JacobFV/labrat/hardware/electronics/power_budget.md

# 5 V servo rail: power budget

Generated by `gen_wiring.py` from its load table; edit the table there, not this file.

The servos run from their own 5 V supply into the PCA9685 breakout's V+ screw terminal. The ESP32 and the
PCA9685 logic (VCC, ~10 mA) run from USB 5 V through the DevKit's 3.3 V regulator. The two meet only at GND.

## Per-servo currents at 5 V (conservative, datasheet and bench numbers rounded up)

| ch | role | servo | idle (A) | moving (A) | stall (A) |
|---|---|---|---|---|---|
| 0 | syringe plunger drive | FS90R continuous | 0.01 | 0.20 | 0.80 |
| 1 | capacitive-probe arm | SG90 positional | 0.01 | 0.25 | 0.75 |
| 2 | phone stand pan | MG90S positional | 0.01 | 0.30 | 0.90 |
| 3 | phone stand tilt | MG90S positional | 0.01 | 0.30 | 0.90 |
| 4 | spare / second syringe | FS90R or SG90 | 0.01 | 0.25 | 0.80 |
| 5 | spare | SG90 | 0.01 | 0.25 | 0.75 |

## Scenarios (supply: 4 A)

| scenario | rail current (A) | margin |
|---|---|---|
| idle, everything holding | 0.03 | ok |
| typical step: plunger moving, stand aiming, probe arm swinging | 1.05 | ok |
| homing: plunger driven into its stop (until syr_home), stand aiming | 1.41 | ok |
| bad day: all four installed servos stalled | 3.35 | tight |
| worst case, six servos (two spares) stalled | 4.90 | exceeds supply: brief only |

## Choices

- **Supply: 5 V, 4 A** (20 W). Normal work stays near 1-1.5 A; four installed servos all
  stalled is still inside the rating. Six stalled servos exceed it, but only for the moment before the
  firmware's timed pulses or the stall clears. A 3 A brick works for the four installed servos alone.
  Cheapest alternative: an XL4015 5 A buck module running off the 3018's 24 V supply, set to 5.2 V.
- **Bulk capacitor: 1000 uF / 16 V electrolytic across V+ and GND at the PCA9685 terminal** (the breakout
  has a footprint for it). 9 g servos draw 0.5-0.9 A spikes at every start; without it the rail sags and
  servos twitch. Rule of thumb ~150-250 uF per servo, so 1000 uF covers 4-6.
- **Wiring:** supply to terminal with 20-22 AWG. Servo leads are 26-28 AWG; for the 1 m runs to the head,
  1 m of 26 AWG round trip at 0.8 A stall drops ~0.2 V, which is acceptable.
- **Common ground:** supply -, PCA9685 GND and ESP32 GND are one net (the breakout's header carries it).
  The laptop USB ground joins it through the ESP32. Never connect the servo supply + to the ESP32's 5V pin.
- **ESP32 power:** USB only (laptop, powered hub, phone OTG, or a USB charger when the phone drives it
  over BLE). Peak ~0.35 A with BLE active.
