JacobFV/labrat/tappet/hardware/electronics/netlist.csv

net | ref | pin
+3V3 | A1 | J1-1
+3V3 | A1 | J1-2
+3V3 | A2 | VCC
+3V3 | R11 | 1
+3V3 | R6 | 1
+3V3 | TP6 | 1
5V_DEVKIT | A1 | J1-21
5V_DEVKIT | D3 | K
5V_DEVKIT | TP5 | 1
5V_LOGIC | C6 | +
5V_LOGIC | C9 | 1
5V_LOGIC | D3 | A
5V_LOGIC | TP3 | 1
5V_LOGIC | U3 | OUT+
5V_LOGIC | U4 | 1 IN
CC1_HEAD | J2 | CC1
CC1_HEAD | R12 | 2
CC1_IN | J1 | CC1
CC1_IN | U1 | CC1
CC2_HEAD | J2 | CC2
CC2_HEAD | R13 | 2
CC2_IN | J1 | CC2
CC2_IN | U1 | CC2
CH224_CFG1 | R2 | 1
CH224_CFG1 | U1 | CFG1
CH224_VDD | C1 | 1
CH224_VDD | R1 | 2
CH224_VDD | U1 | VDD
DN_IN | J1 | D-
DN_IN | U1 | DM
DP_IN | J1 | D+
DP_IN | U1 | DP
GND | A1 | J1-22
GND | A1 | J3-1
GND | A1 | J3-21
GND | A1 | J3-22
GND | A2 | GND
GND | A2 | GND (term)
GND | C1 | 2
GND | C10 | 2
GND | C11 | 2
GND | C2 | -
GND | C3 | 2
GND | C4 | -
GND | C5 | 2
GND | C6 | -
GND | C7 | -
GND | C8 | 2
GND | C9 | 2
GND | D2 | A
GND | E1 | TIP
GND | E2 | TIP
GND | J1 | GND
GND | J1 | SHIELD
GND | J2 | GND
GND | J2 | SHIELD
GND | M1 | GND
GND | M2 | GND
GND | M3 | GND
GND | M4 | GND
GND | M5 | GND
GND | M6 | GND
GND | M7 | GND
GND | M8 | GND
GND | R10 | 2
GND | R2 | 2
GND | R4 | 2
GND | R5 | 2
GND | R8 | 2
GND | SW1 | 2
GND | TP9 | 1
GND | U1 | GND
GND | U2 | IN-
GND | U2 | OUT-
GND | U3 | IN-
GND | U3 | OUT-
GND | U4 | 2 GND
GND | U5 | 2 GND
I2C_SCL | A1 | J1-15
I2C_SCL | A2 | SCL
I2C_SDA | A1 | J1-12
I2C_SDA | A2 | SDA
PCA_OE | A1 | J1-16
PCA_OE | A2 | OE
PCA_OE | R11 | 2
PD_PG | D1 | K
PD_PG | U1 | PG
PG_LED | D1 | A
PG_LED | R3 | 2
PHONE_VBUS_EN | A1 | J1-7
PHONE_VBUS_EN | R5 | 1
PHONE_VBUS_EN | U4 | 3 EN
PHONE_VBUS_FLT | A1 | J1-8
PHONE_VBUS_FLT | R6 | 2
PHONE_VBUS_FLT | U4 | 4 /FLT
PWM0 | A2 | PWM0
PWM0 | M1 | SIG
PWM1 | A2 | PWM1
PWM1 | M2 | SIG
PWM2 | A2 | PWM2
PWM2 | M3 | SIG
PWM3 | A2 | PWM3
PWM3 | M4 | SIG
PWM4 | A2 | PWM4
PWM4 | M5 | SIG
PWM5 | A2 | PWM5
PWM5 | M6 | SIG
PWM6 | A2 | PWM6
PWM6 | M7 | SIG
PWM7 | A2 | PWM7
PWM7 | M8 | SIG
STATUS_LED | A1 | J3-16
U4_ILIM | R4 | 1
U4_ILIM | U4 | 5 ILIM
USB_DN | A1 | J3-20
USB_DN | J2 | D-
USB_DN | U5 | 3 I/O2
USB_DN | U5 | 4 I/O2
USB_DP | A1 | J3-19
USB_DP | J2 | D+
USB_DP | U5 | 1 I/O1
USB_DP | U5 | 6 I/O1
USER_BUTTON | A1 | J3-14
USER_BUTTON | SW1 | 1
VBUS_HEAD | C7 | +
VBUS_HEAD | C8 | 1
VBUS_HEAD | J2 | VBUS
VBUS_HEAD | R12 | 1
VBUS_HEAD | R13 | 1
VBUS_HEAD | TP4 | 1
VBUS_HEAD | U4 | 6 OUT
VBUS_HEAD | U5 | 5 VBUS
VBUS_IN | F1 | 1
VBUS_IN | J1 | VBUS
VBUS_IN | R1 | 1
VBUS_IN | R3 | 1
VIN_9V | C2 | +
VIN_9V | C3 | 1
VIN_9V | D2 | K
VIN_9V | F1 | 2
VIN_9V | R9 | 1
VIN_9V | TP1 | 1
VIN_9V | U2 | IN+
VIN_9V | U3 | IN+
VIN_SENSE | A1 | J1-5
VIN_SENSE | C11 | 1
VIN_SENSE | R10 | 1
VIN_SENSE | R9 | 2
VIN_SENSE | TP8 | 1
VSERVO_SENSE | A1 | J1-4
VSERVO_SENSE | C10 | 1
VSERVO_SENSE | R7 | 2
VSERVO_SENSE | R8 | 1
VSERVO_SENSE | TP7 | 1
V_SERVO | A2 | V+ (term)
V_SERVO | C4 | +
V_SERVO | C5 | 1
V_SERVO | M1 | V+
V_SERVO | M2 | V+
V_SERVO | M3 | V+
V_SERVO | M4 | V+
V_SERVO | M5 | V+
V_SERVO | M6 | V+
V_SERVO | M7 | V+
V_SERVO | M8 | V+
V_SERVO | R7 | 1
V_SERVO | TP2 | 1
V_SERVO | U2 | OUT+
NC | A1 | J1-10
NC | A1 | J1-11
NC | A1 | J1-13
NC | A1 | J1-14
NC | A1 | J1-17
NC | A1 | J1-18
NC | A1 | J1-19
NC | A1 | J1-20
NC | A1 | J1-3
NC | A1 | J1-6
NC | A1 | J1-9
NC | A1 | J3-10
NC | A1 | J3-11
NC | A1 | J3-12
NC | A1 | J3-13
NC | A1 | J3-15
NC | A1 | J3-17
NC | A1 | J3-18
NC | A1 | J3-2
NC | A1 | J3-3
NC | A1 | J3-4
NC | A1 | J3-5
NC | A1 | J3-6
NC | A1 | J3-7
NC | A1 | J3-8
NC | A1 | J3-9
NC | A2 | PWM10
NC | A2 | PWM11
NC | A2 | PWM12
NC | A2 | PWM13
NC | A2 | PWM14
NC | A2 | PWM15
NC | A2 | PWM8
NC | A2 | PWM9
NC | U1 | CFG2
NC | U1 | CFG3
