JacobFV/labrat/apps/console/models/laptop_screen.jpg

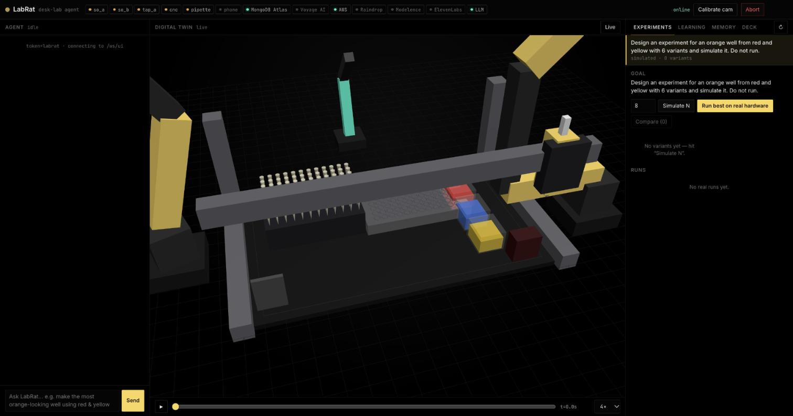
apps/console/models/laptop_screen.jpg
