JacobFV/labrat/cad/cnc3018/renders/cnc3018_spindle_pipette.png

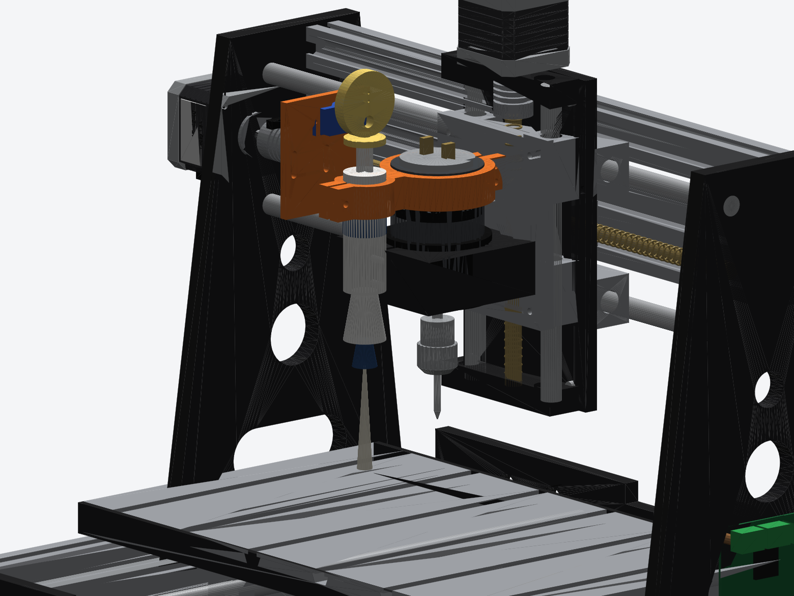
cad/cnc3018/renders/cnc3018_spindle_pipette.png
