JacobFV/labrat/cad/cnc3018/renders/real_bench_photo.png

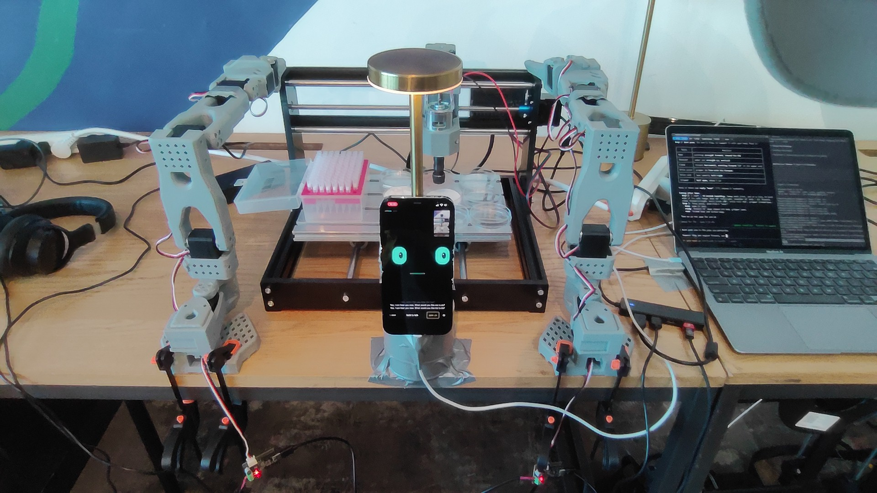
cad/cnc3018/renders/real_bench_photo.png
