JacobFV/labrat/cad/cnc3018/renders/twin_chrome.png

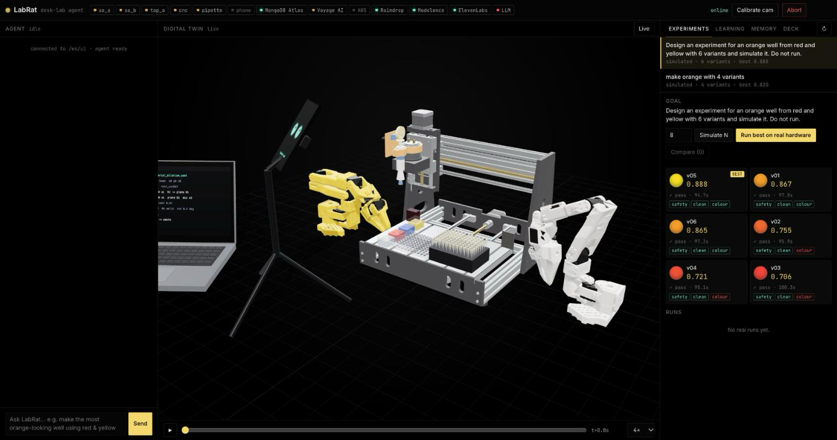
cad/cnc3018/renders/twin_chrome.png
