JacobFV/labrat/cad/syringe/preview.png

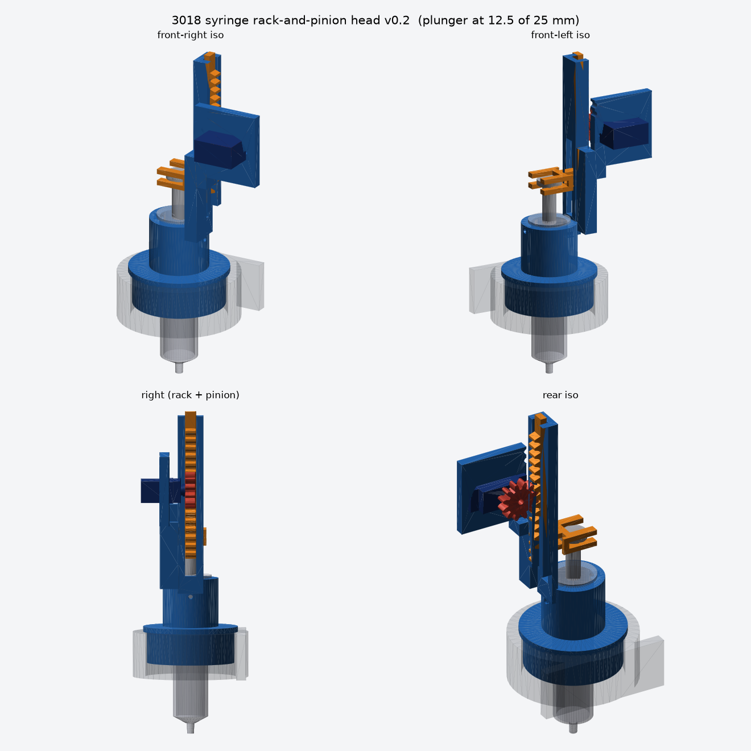
cad/syringe/preview.png
