JacobFV/labrat/docs/images/sponsors/aws.png

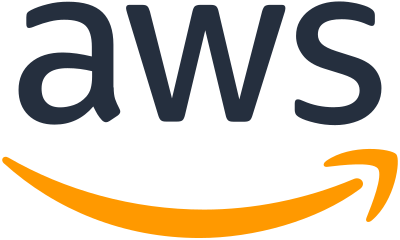
docs/images/sponsors/aws.png
