JacobFV/labrat/docs/images/sponsors/mongodb.png

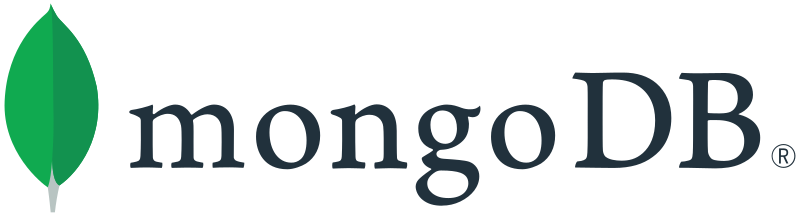
docs/images/sponsors/mongodb.png
