JacobFV/labrat/docs/images/sponsors/voyageai.png

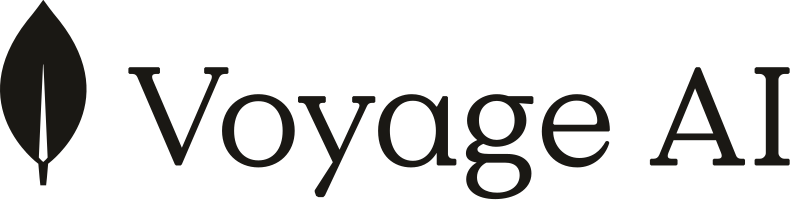
docs/images/sponsors/voyageai.png
