JacobFV/labrat/docs/images/twin_layers_head.png

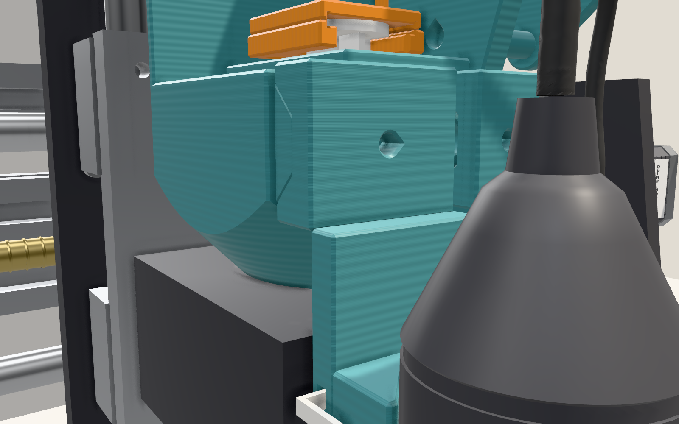
docs/images/twin_layers_head.png
