JacobFV/labrat/docs/images/twin_layers_so101.png

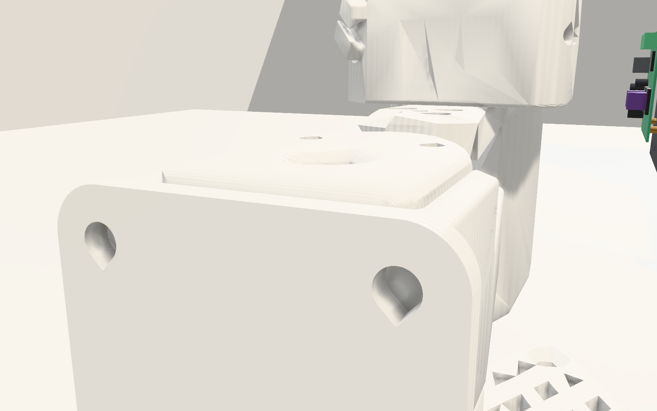
docs/images/twin_layers_so101.png
