JacobFV/labrat/docs/images/twin_simmany.png

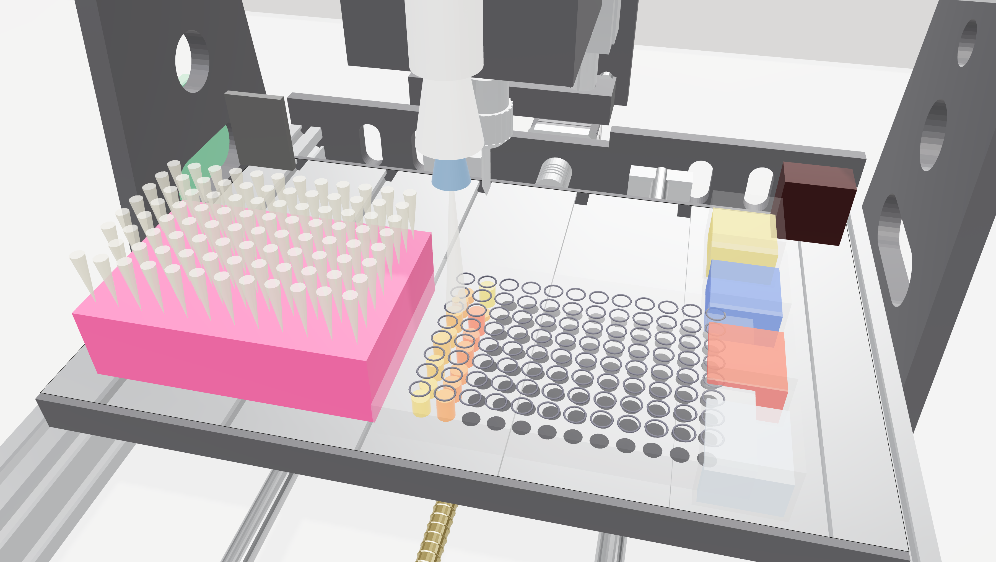
docs/images/twin_simmany.png
