JacobFV/labrat/docs/images/twin_simreal.png

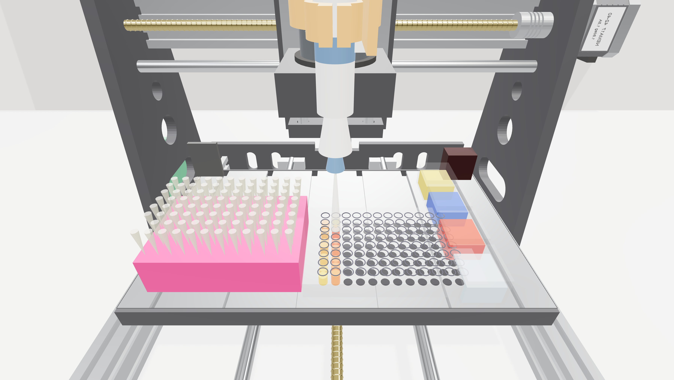
docs/images/twin_simreal.png
