JacobFV/labrat/docs/images/twin_tip.png

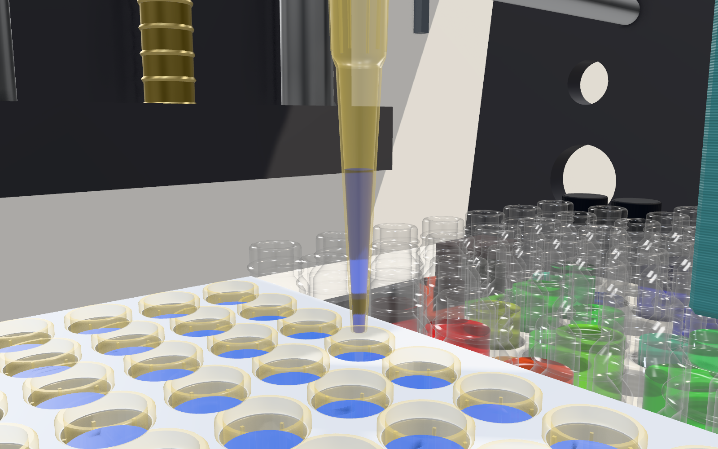
docs/images/twin_tip.png
