JacobFV/labrat/docs/images/twin_tiprack.png

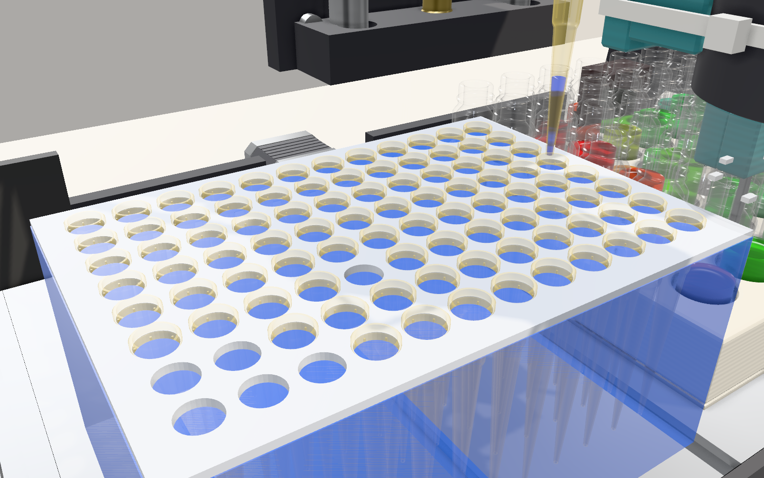
docs/images/twin_tiprack.png
