JacobFV/labrat/docs/images/twin_vials.png

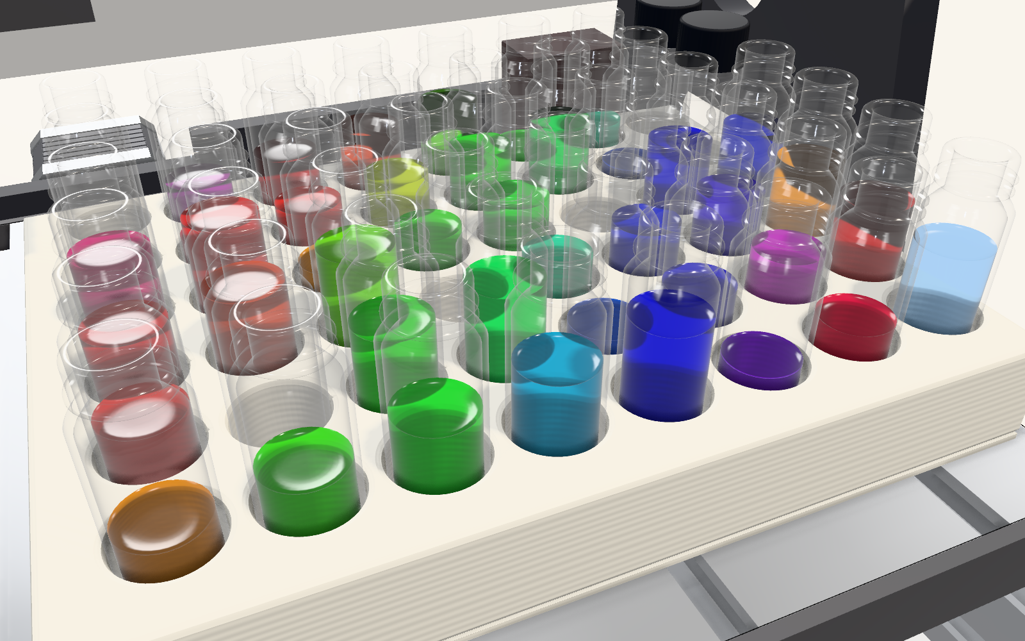
docs/images/twin_vials.png
