JacobFV/labrat/docs/images/twin_vials_caps.png

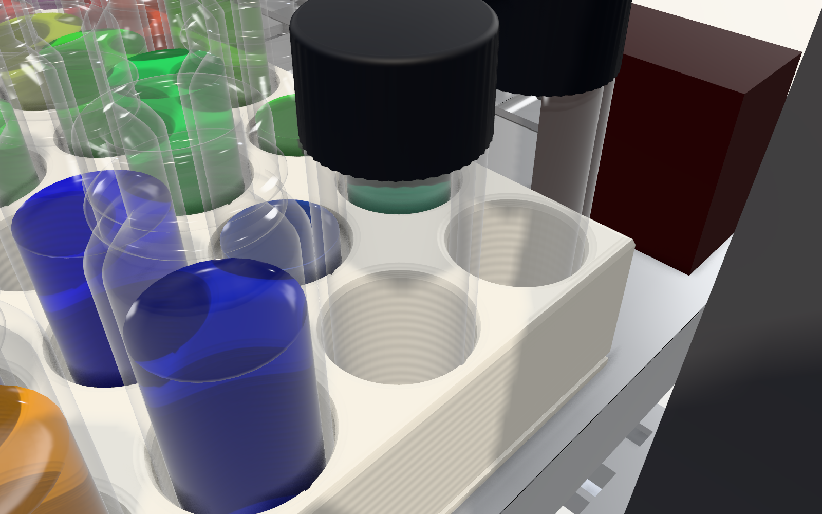
docs/images/twin_vials_caps.png
