JacobFV/labrat/docs/images/twin_vials_side.png

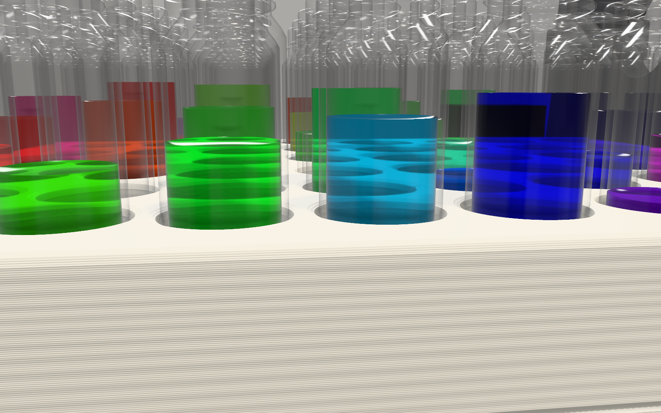
docs/images/twin_vials_side.png
