JacobFV/labrat/docs/images/twin_vials_top.png

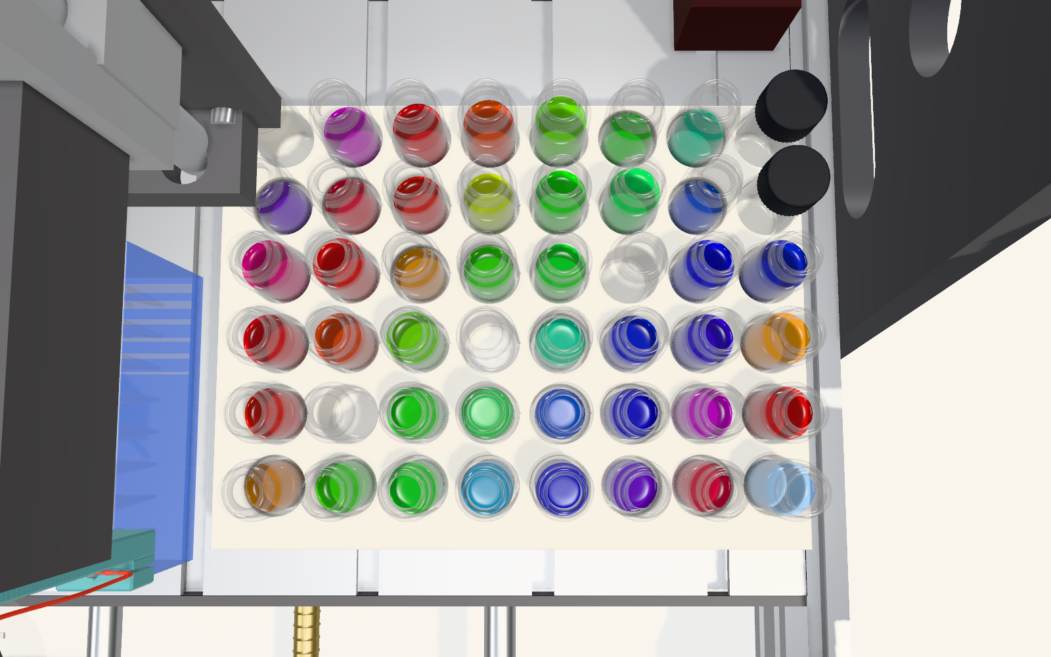
docs/images/twin_vials_top.png
