JacobFV/labrat/hardware/cnc3018/renders/bench_cnc_syringe_closeup.png

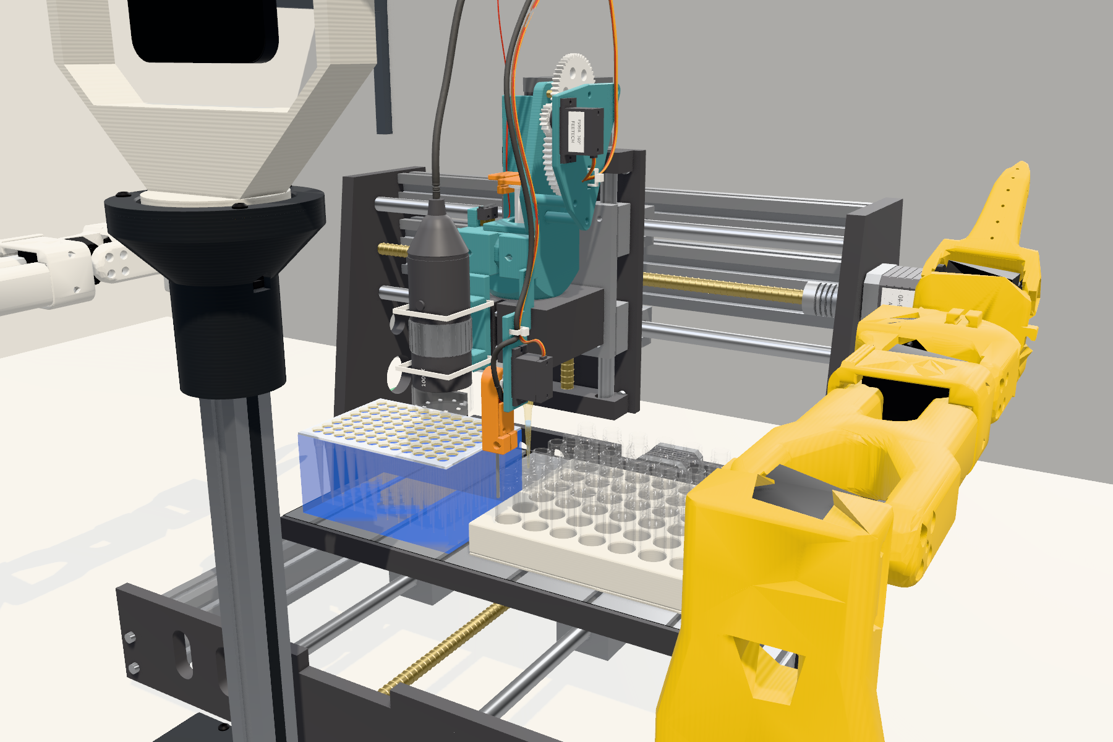
hardware/cnc3018/renders/bench_cnc_syringe_closeup.png
