JacobFV/labrat/hardware/cnc3018/renders/bench_syringe_head_detail.png

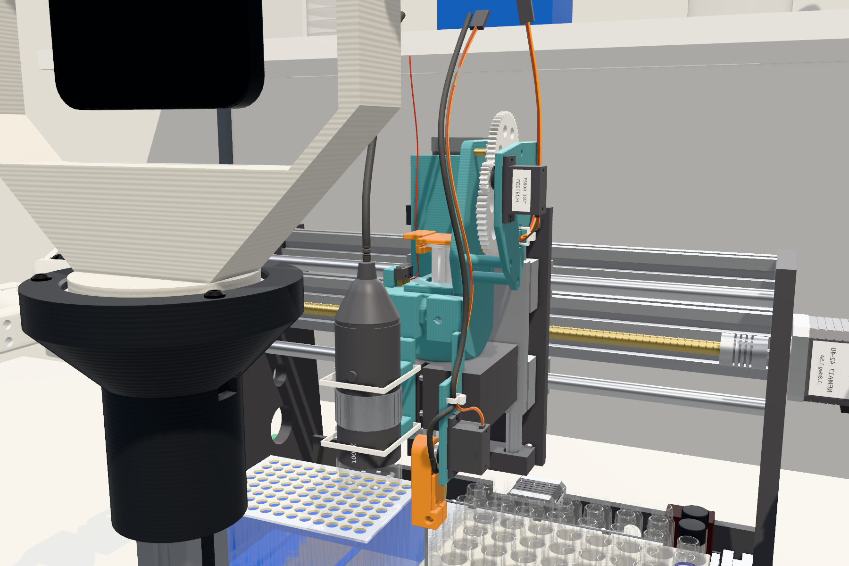
hardware/cnc3018/renders/bench_syringe_head_detail.png
