JacobFV/labrat/hardware/cnc3018/renders/cnc3018_front.png

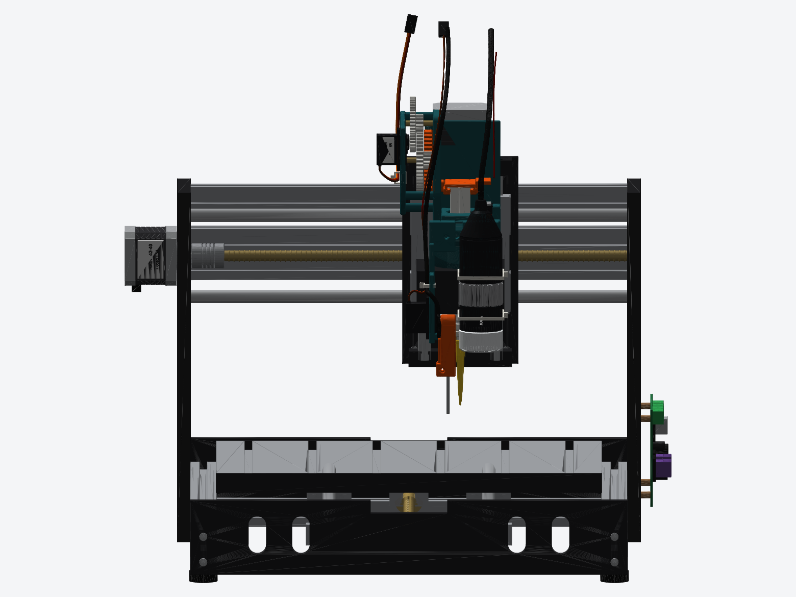
hardware/cnc3018/renders/cnc3018_front.png
