JacobFV/labrat/hardware/cnc3018/renders/cnc3018_iso.png

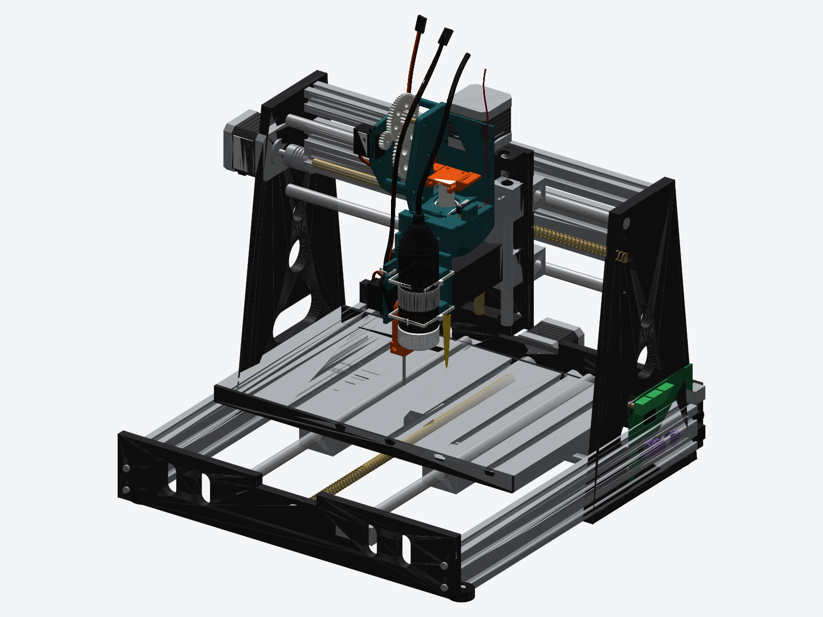
hardware/cnc3018/renders/cnc3018_iso.png
