JacobFV/labrat/hardware/cnc3018/renders/cnc3018_syringe_head.png

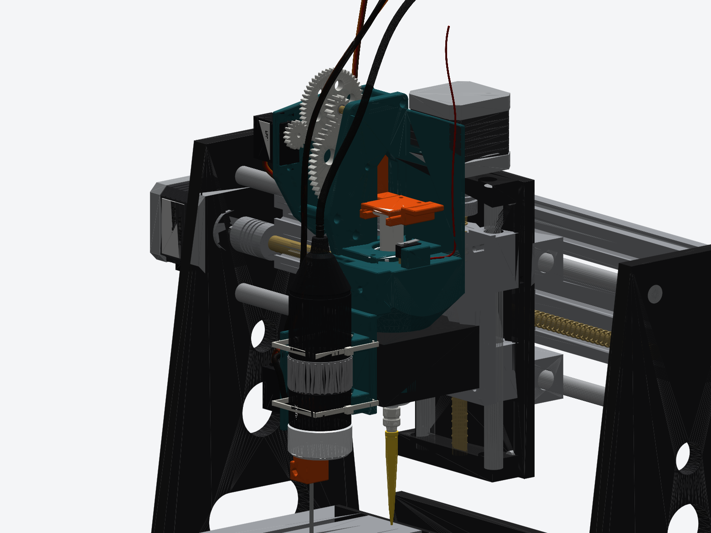
hardware/cnc3018/renders/cnc3018_syringe_head.png
