JacobFV/labrat/hardware/cnc3018/renders/lab_iso.png

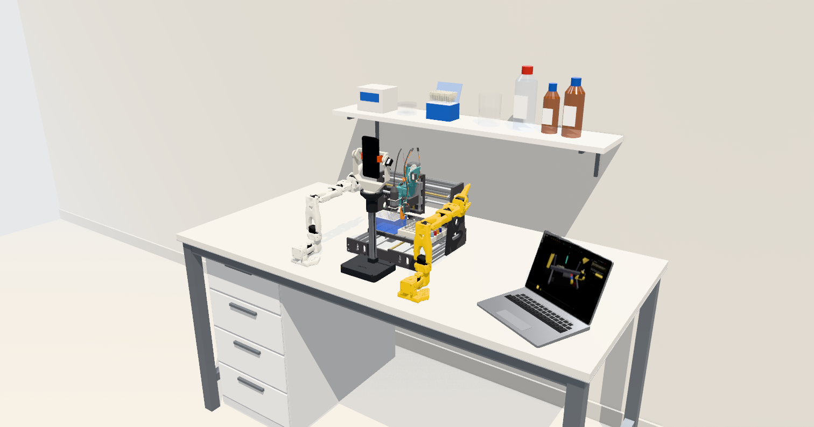
hardware/cnc3018/renders/lab_iso.png
