JacobFV/labrat/hardware/phone-stand/renders/detail_turntable.png

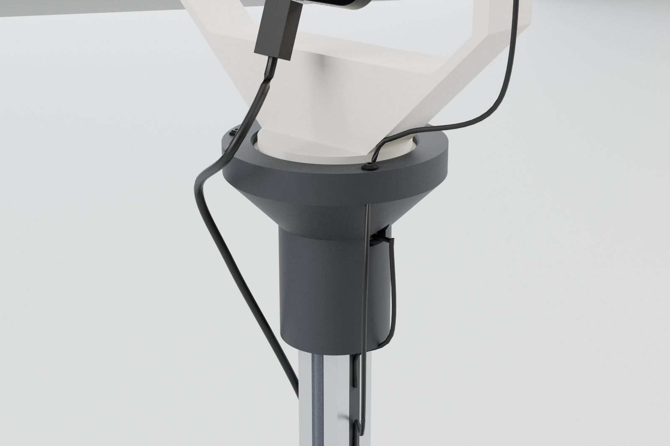
hardware/phone-stand/renders/detail_turntable.png
