JacobFV/labrat/hardware/tool-head/renders/bench_deck.png

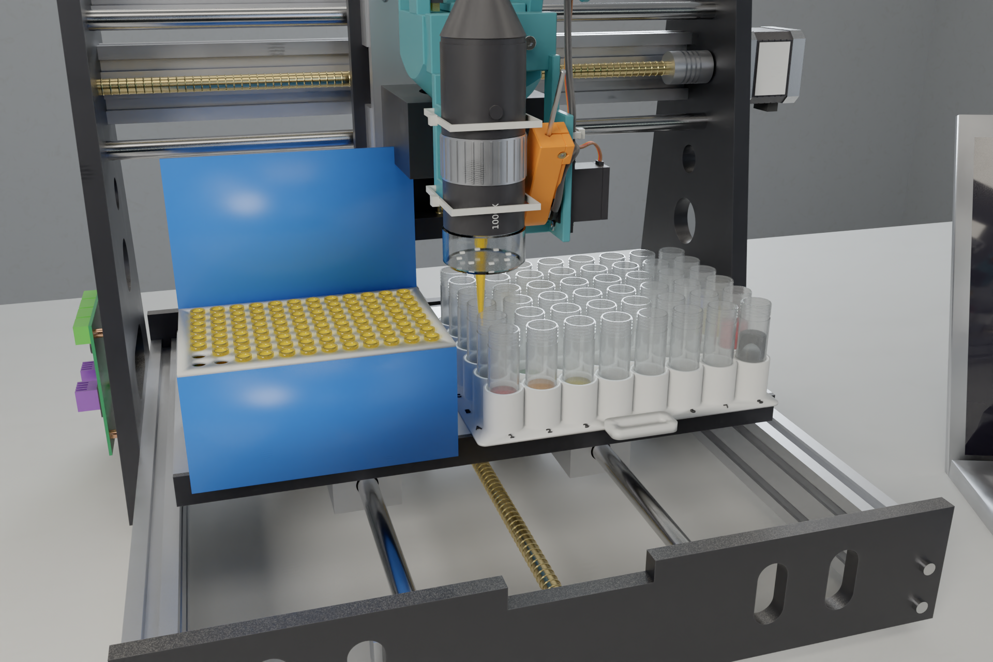
hardware/tool-head/renders/bench_deck.png
