JacobFV/labrat/hardware/tool-head/renders/bench_probing_wide.png

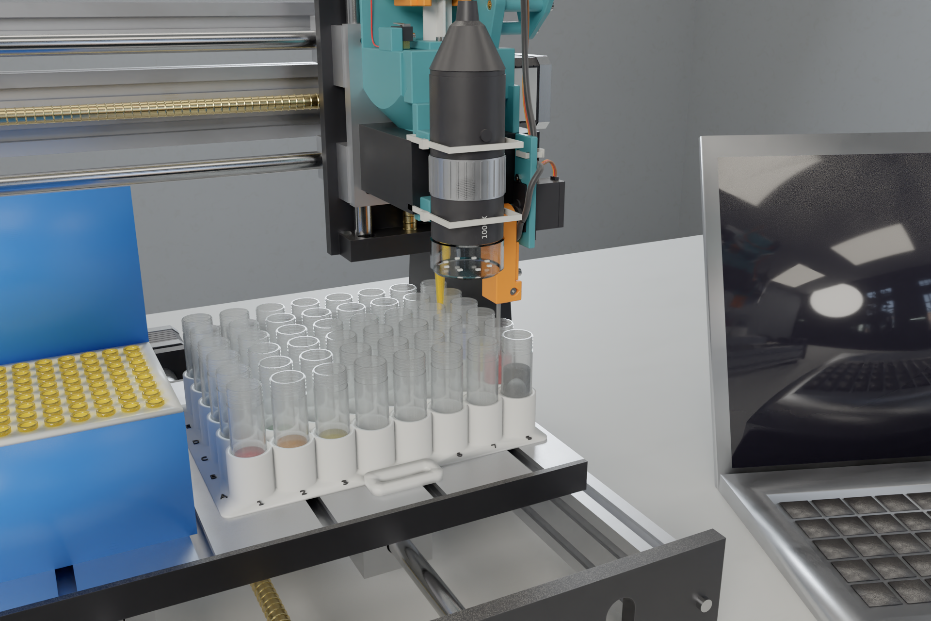
hardware/tool-head/renders/bench_probing_wide.png
