JacobFV/labrat/hardware/tool-head/renders/head_tip.png

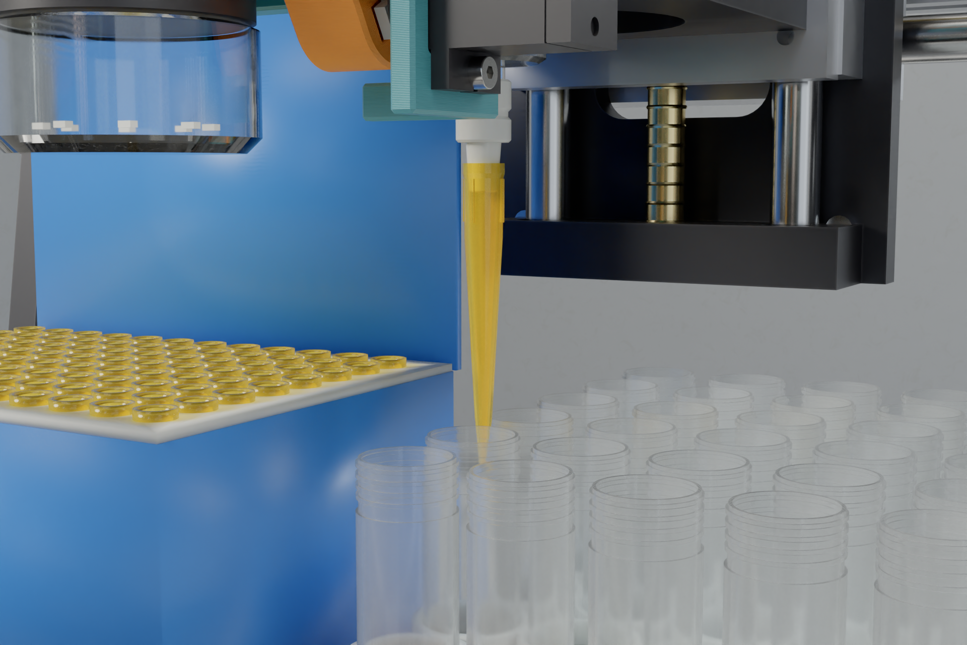
hardware/tool-head/renders/head_tip.png
