JacobFV/labrat/hardware/tool-head/renders/studio_carriage.png

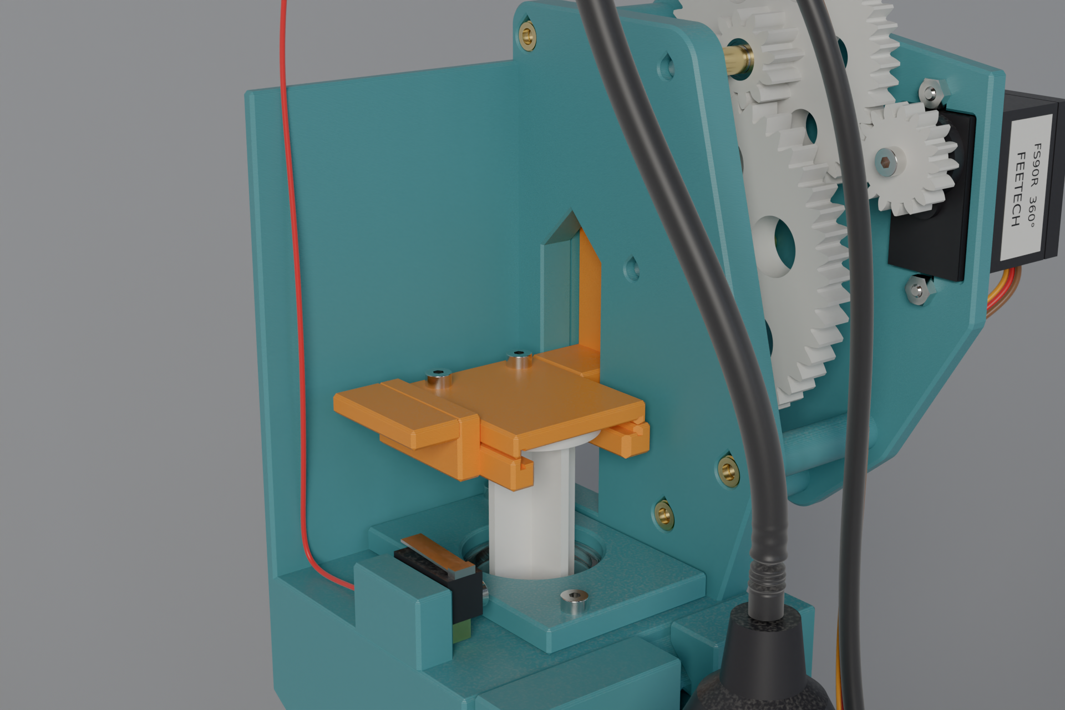
hardware/tool-head/renders/studio_carriage.png
