JacobFV/labrat/hardware/tool-head/renders/studio_gearbox.png

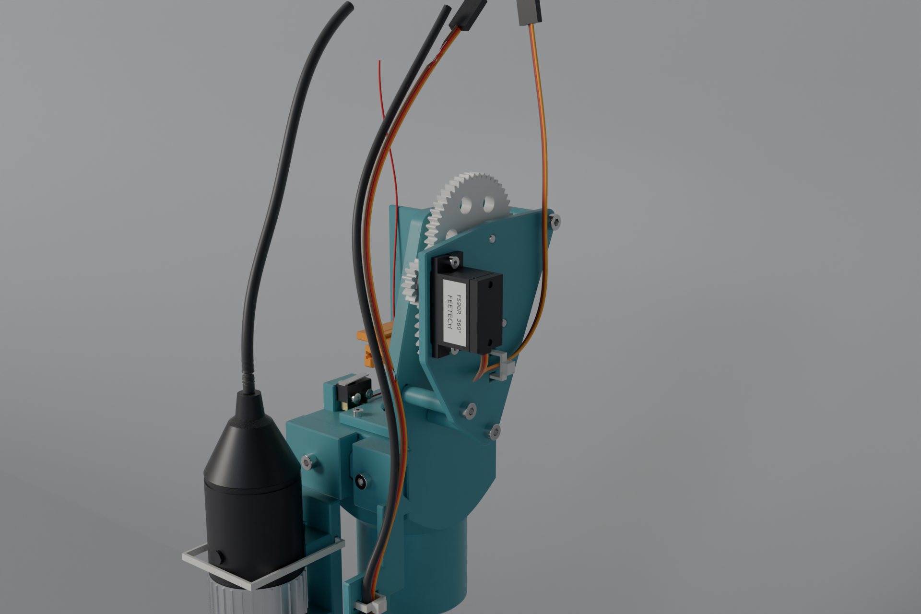
hardware/tool-head/renders/studio_gearbox.png
