JacobFV/labrat/hardware/tool-head/renders/studio_home_switch.png

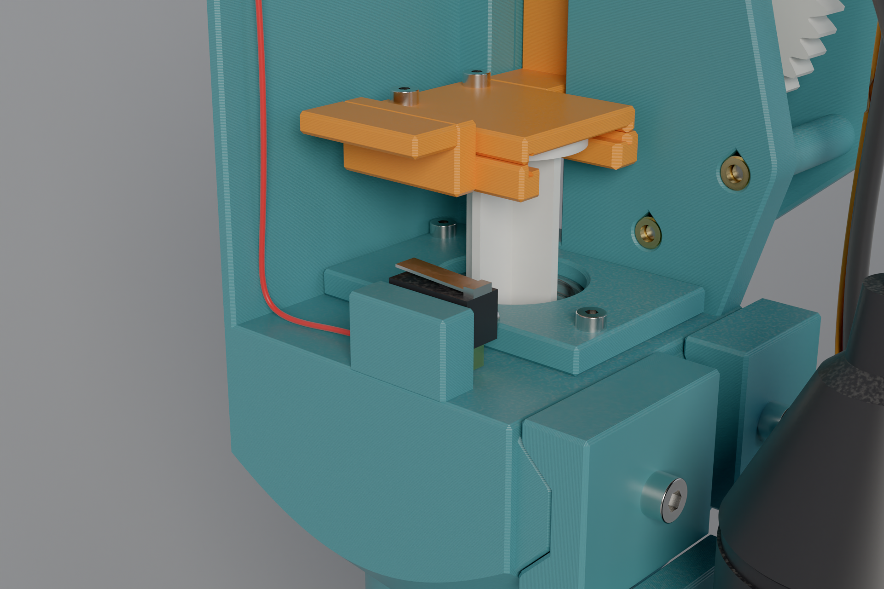
hardware/tool-head/renders/studio_home_switch.png
