JacobFV/labrat/hardware/tool-head/renders/studio_rear_left.png

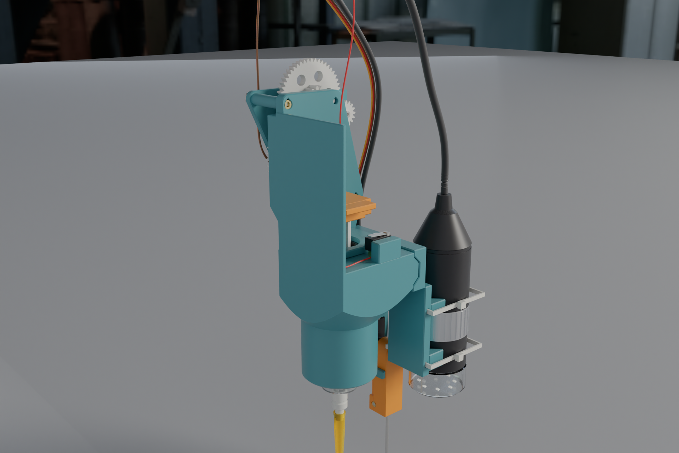
hardware/tool-head/renders/studio_rear_left.png
