JacobFV/labrat/hardware/tool-head/renders/studio_servo_side.png

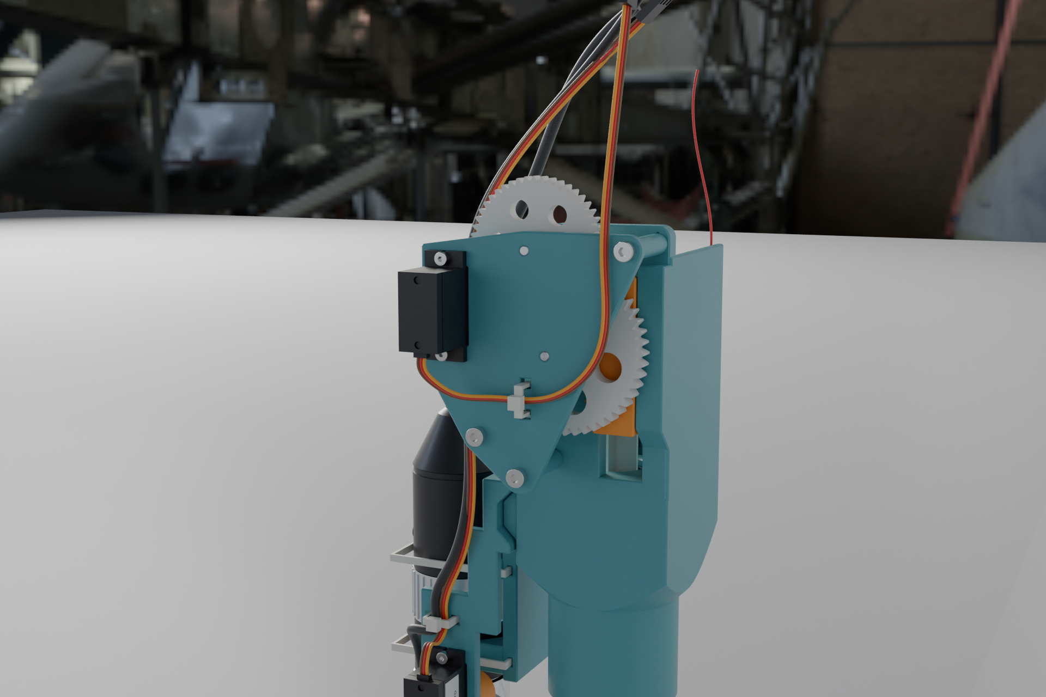
hardware/tool-head/renders/studio_servo_side.png
