JacobFV/labrat/hardware/tool-head/renders/studio_tip.png

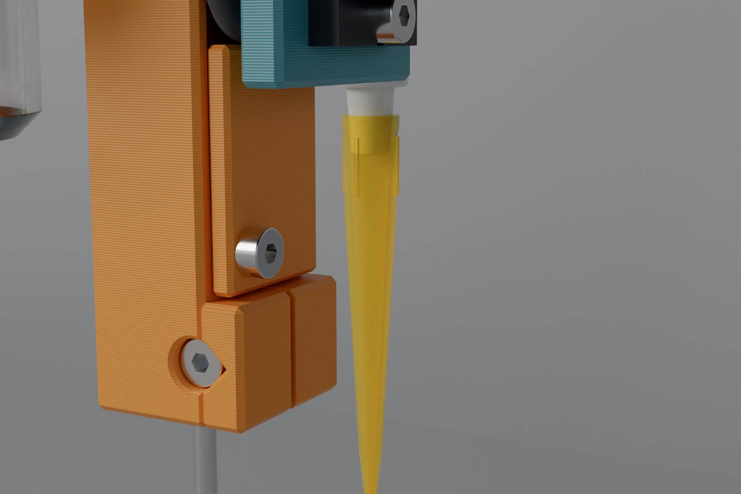
hardware/tool-head/renders/studio_tip.png
