JacobFV/labrat/hardware/tool-head/renders/studio_tool_rail.png

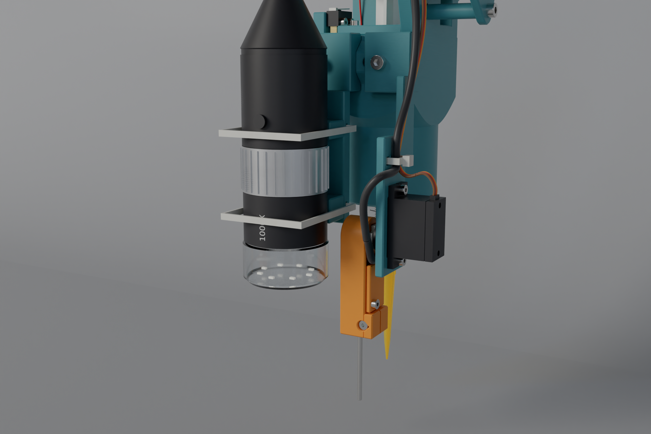
hardware/tool-head/renders/studio_tool_rail.png
