JacobFV/labrat/tappet/hardware/cad/plates/plate2_turrets_neck_clamp.png

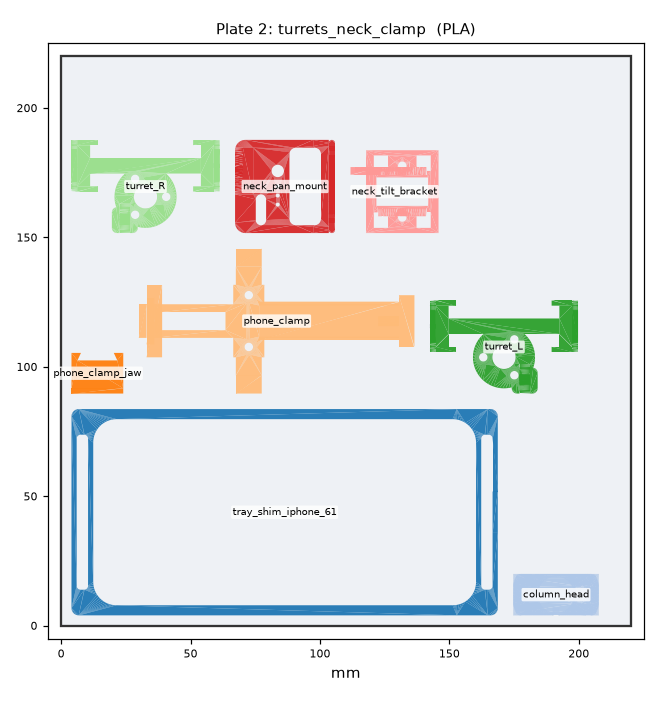
tappet/hardware/cad/plates/plate2_turrets_neck_clamp.png
