JacobFV/labrat/tappet/hardware/cad/plates/plate4_arm_links.png

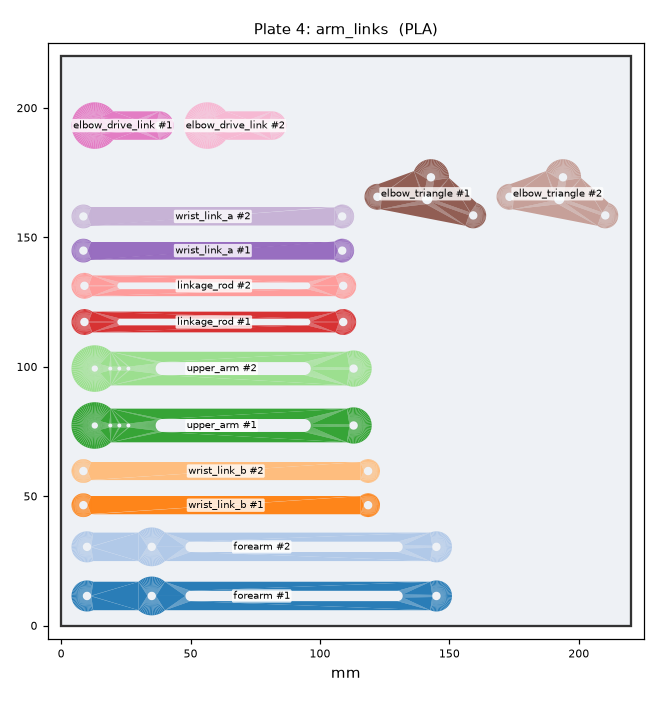
tappet/hardware/cad/plates/plate4_arm_links.png
