JacobFV/labrat/tappet/hardware/cad/renders/arm_L_closeup.png

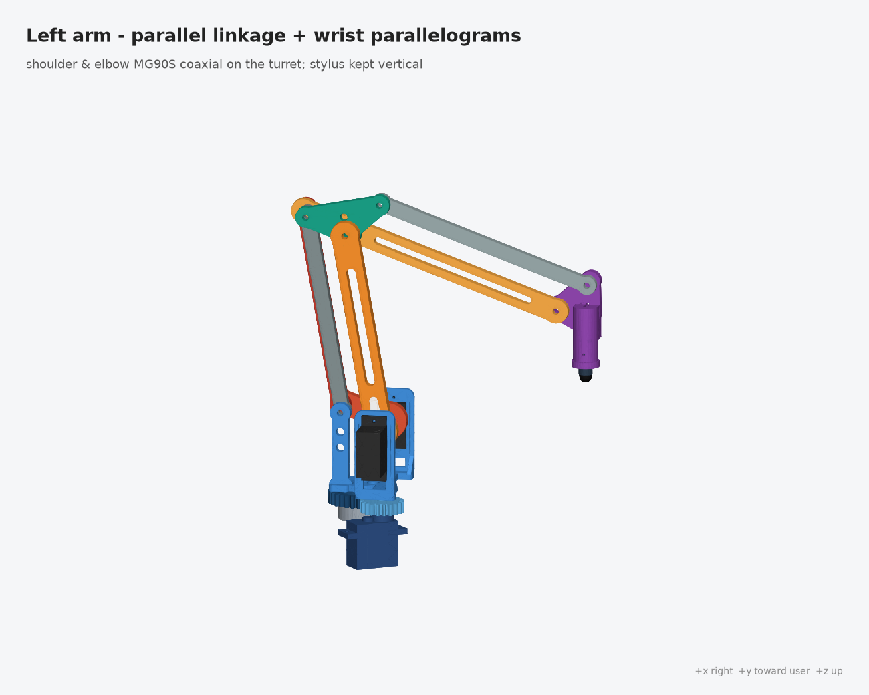
tappet/hardware/cad/renders/arm_L_closeup.png
