JacobFV/labrat/tappet/hardware/cad/renders/part_cable_clip.png

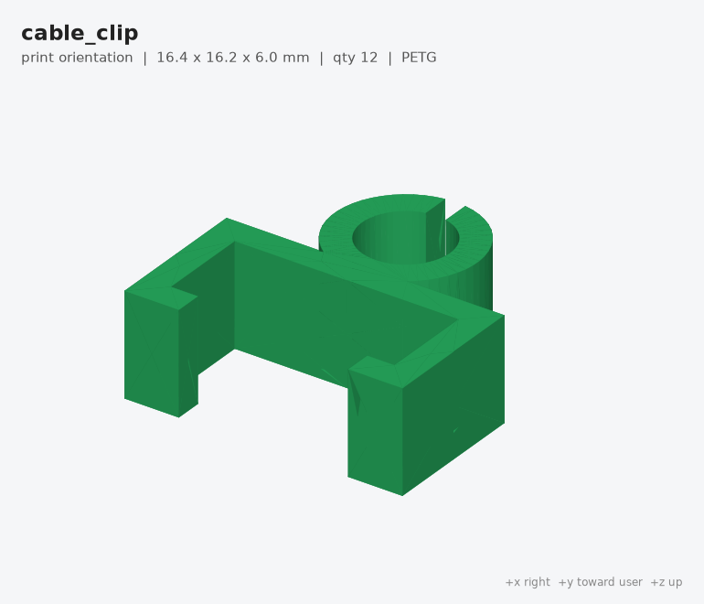
tappet/hardware/cad/renders/part_cable_clip.png
