JacobFV/labrat/tappet/hardware/cad/renders/part_elbow_drive_link.png

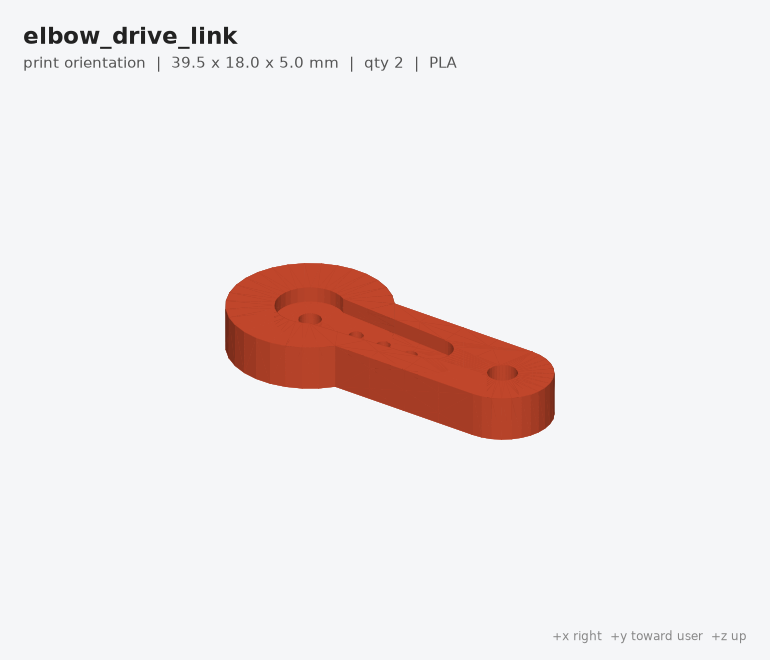
tappet/hardware/cad/renders/part_elbow_drive_link.png
