JacobFV/labrat/tappet/hardware/cad/renders/part_neck_pan_mount.png

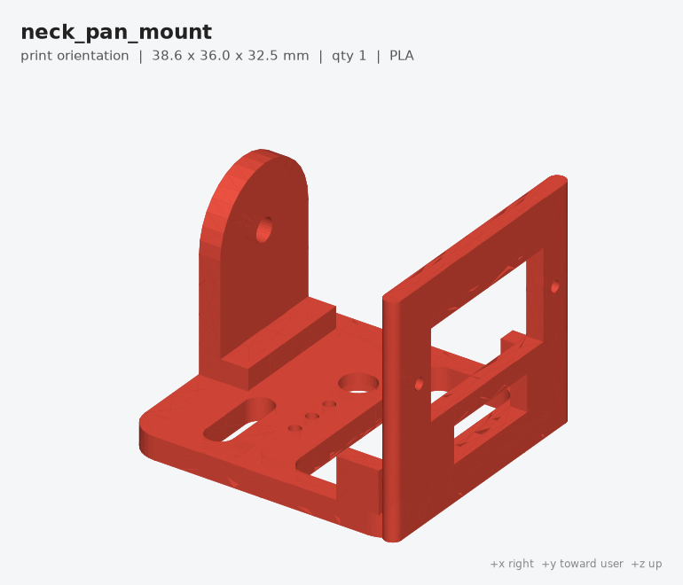
tappet/hardware/cad/renders/part_neck_pan_mount.png
