JacobFV/labrat/tappet/hardware/cad/renders/part_neck_tilt_bracket.png

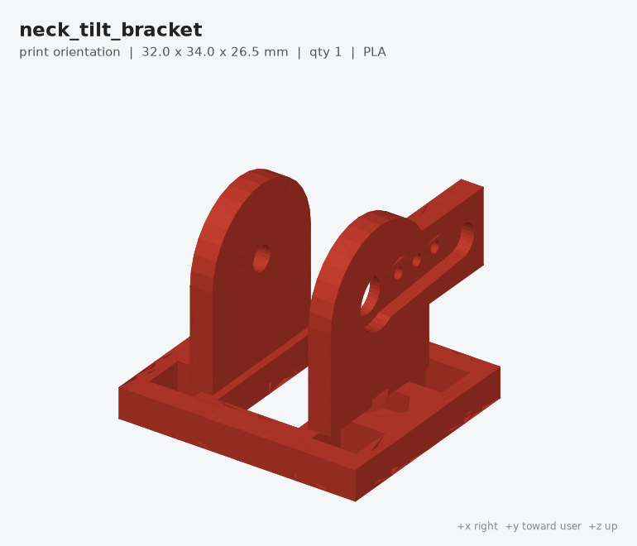
tappet/hardware/cad/renders/part_neck_tilt_bracket.png
