JacobFV/labrat/tappet/hardware/cad/renders/part_phone_clamp.png

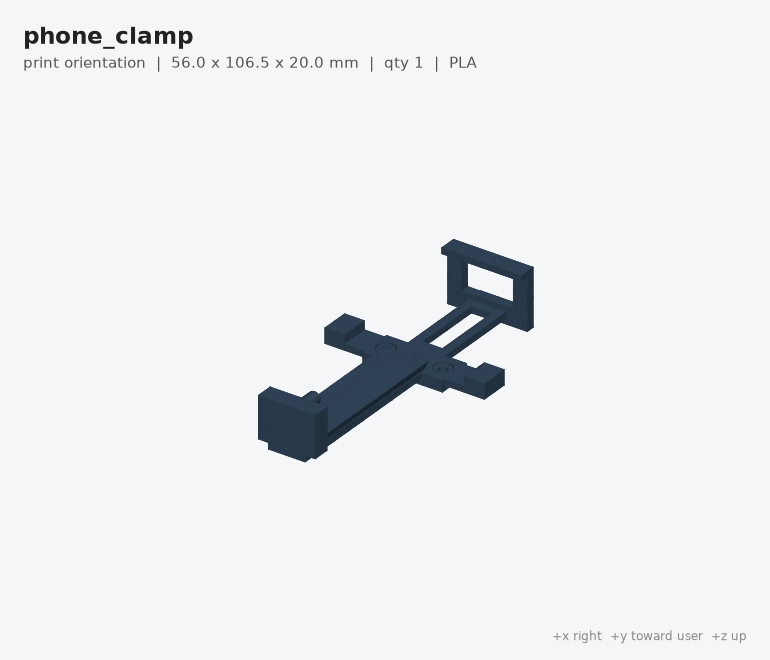
tappet/hardware/cad/renders/part_phone_clamp.png
