JacobFV/labrat/tappet/hardware/cad/renders/part_stylus_holder_R.png

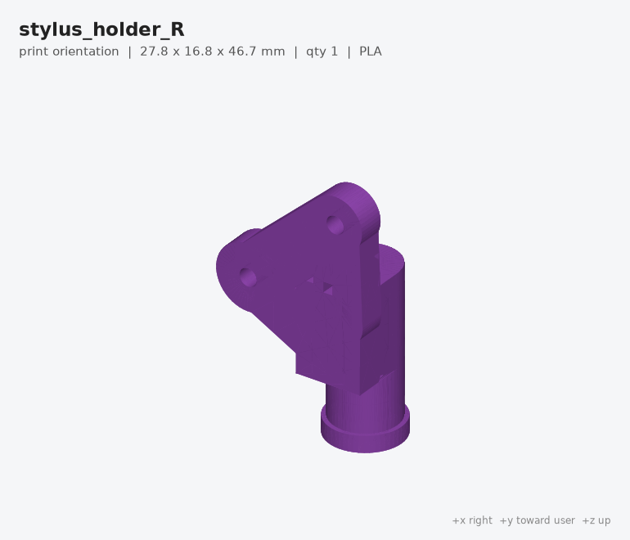
tappet/hardware/cad/renders/part_stylus_holder_R.png
