JacobFV/labrat/tappet/hardware/cad/renders/part_tray.png

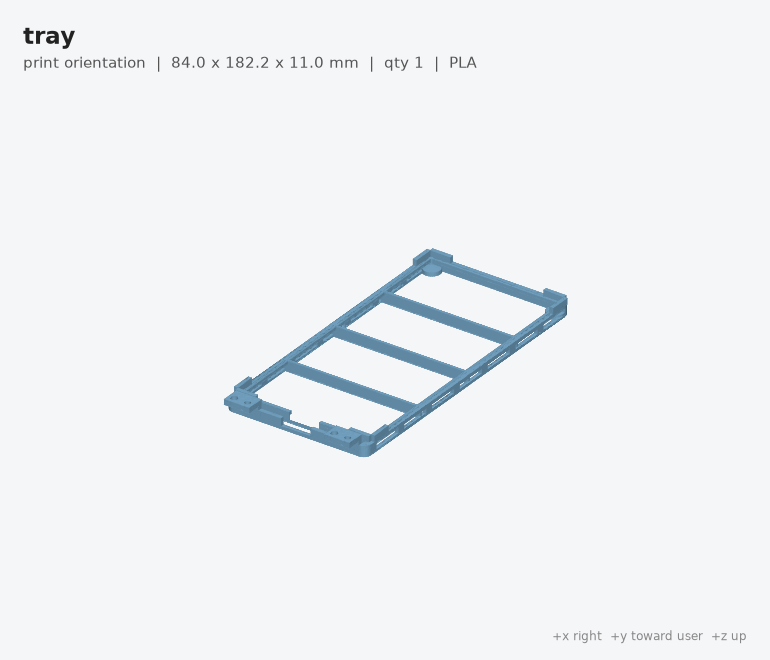
tappet/hardware/cad/renders/part_tray.png
