JacobFV/labrat/tappet/hardware/cad/renders/part_tray_shim_iphone_61.png

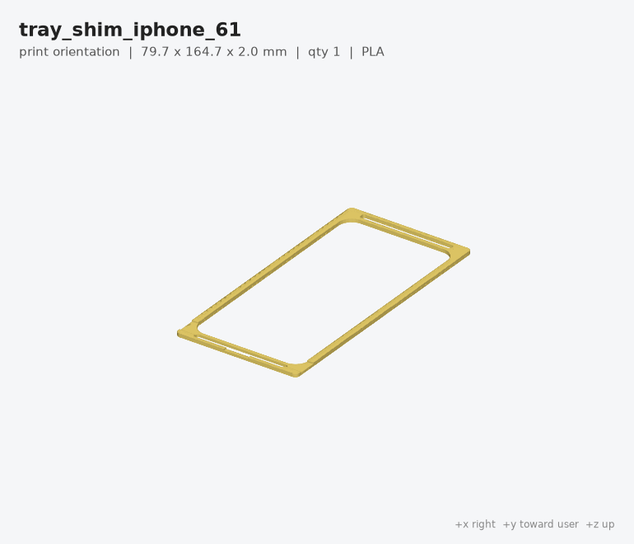
tappet/hardware/cad/renders/part_tray_shim_iphone_61.png
