JacobFV/labrat/tappet/hardware/cad/renders/part_turret_L.png

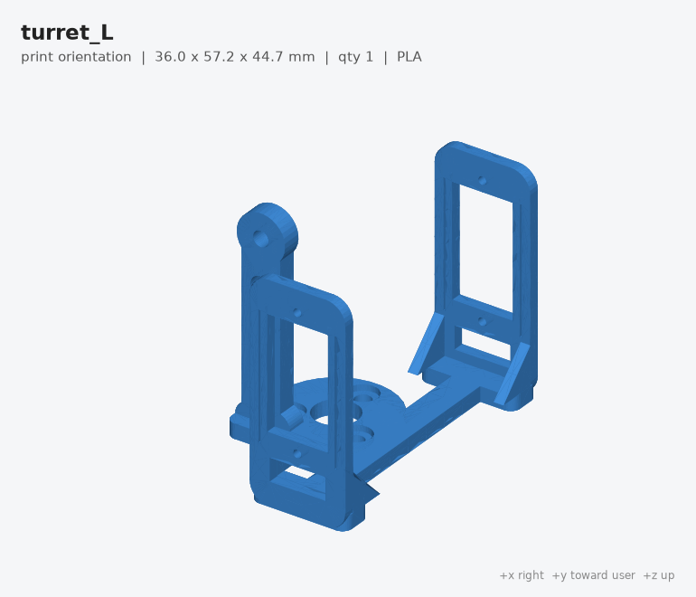
tappet/hardware/cad/renders/part_turret_L.png
