JacobFV/labrat/tappet/hardware/cad/renders/part_upper_arm.png

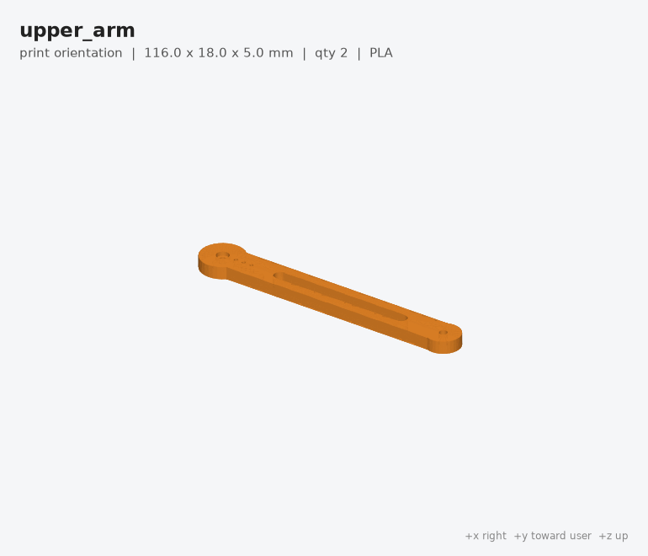
tappet/hardware/cad/renders/part_upper_arm.png
