JacobFV/labrat/video/iphone_overlay.png

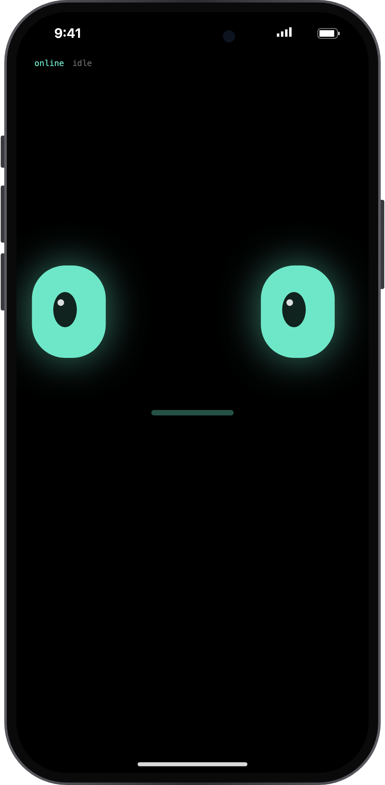
video/iphone_overlay.png
