JacobFV/labrat/hardware/tool-head/bom.csv

pn | qty | unit | name | kind | process | material | vendor | vendor_pn | unit_cost_usd | notes
LIB-SHCS-M2x10 | 2 | ea | ISO 4762 M2x10 socket head cap screw, A2 | buy | purchased | stainless_a2_fastener | McMaster-Carr / Bossard | ISO 4762 M2x10 A2 | 0.08
LIB-SHCS-M2x12 | 1 | ea | ISO 4762 M2x12 socket head cap screw, A2 | buy | purchased | stainless_a2_fastener | McMaster-Carr / Bossard | ISO 4762 M2x12 A2 | 0.084
LIB-SHCS-M2x16 | 1 | ea | ISO 4762 M2x16 socket head cap screw, A2 | buy | purchased | stainless_a2_fastener | McMaster-Carr / Bossard | ISO 4762 M2x16 A2 | 0.092
LIB-SHCS-M2x6 | 2 | ea | ISO 4762 M2x6 socket head cap screw, A2 | buy | purchased | stainless_a2_fastener | McMaster-Carr / Bossard | ISO 4762 M2x6 A2 | 0.072
LIB-SHCS-M2x8 | 8 | ea | ISO 4762 M2x8 socket head cap screw, A2 | buy | purchased | stainless_a2_fastener | McMaster-Carr / Bossard | ISO 4762 M2x8 A2 | 0.076
LIB-SHCS-M3x10 | 2 | ea | ISO 4762 M3x10 socket head cap screw, A2 | buy | purchased | stainless_a2_fastener | McMaster-Carr / Bossard | ISO 4762 M3x10 A2 | 0.08
LIB-SHCS-M3x30 | 3 | ea | ISO 4762 M3x30 socket head cap screw, A2 | buy | purchased | stainless_a2_fastener | McMaster-Carr / Bossard | ISO 4762 M3x30 A2 | 0.12
MF-NUT-M2-ISO4032 | 4 | ea | ISO 4032 hex nut M2 | buy | purchased | stainless_a2_fastener
SYR-100 | 1 | ea | head body | make | fdm_print | petg_print |  |  |  | PETG, 0.2 mm, 6 walls, 25 % gyroid; upright on the plug, no supports
SYR-101 | 1 | ea | gear plate 2 with standoffs | make | fdm_print | petg_print |  |  |  | PETG, 0.2 mm, 6 walls; on its outer face (standoffs up), no supports
SYR-102 | 1 | ea | flange clamp | make | fdm_print | petg_print |  |  |  | upside down (relief pocket up), no supports
SYR-103 | 1 | ea | plunger carriage with m1 rack | make | fdm_print | petg_print |  |  |  | on its back face (rack teeth stand up), no supports; its back V-groove rides a rib behind the mesh (PLA on PLA, a smear of PTFE / silicone grease)
SYR-104 | 1 | ea | luer-to-tip adapter | make | cnc_lathe | pom_black |  |  |  | POM-C natural, turned; female ISO 80369-7 slip socket, 200 uL tip cone
SYR-105 | 1 | ea | thumb-disc cap | make | fdm_print | petg_print |  |  |  | upside down (pocket up), no supports
SYR-110 | 1 | ea | G1 17T m0.8 servo gear | make | fdm_print | petg_print |  |  |  | horn pocket up, no supports
SYR-111 | 1 | ea | G2/G3 50T m0.8 + 12T m1 compound gear | make | fdm_print | petg_print |  |  |  | G2 on the bed, no supports
SYR-112 | 1 | ea | G4/G5 49T m1 + 12T m1 output gear | make | fdm_print | petg_print |  |  |  | G4 on the bed, no supports
SYR-130-01p00 | 1.0 | mm | bearing spacer, brass tube 4 x 0.45 cut to 1 | stock | tube_cut | brass_c360 | K&S Precision Metals | 9220 (4 mm x 0.45 wall brass tube), cut + deburred | 0.004 | bears on the MR63ZZ inner ring only (OD 4.0 < shield bore)
SYR-130-04p00 | 4.0 | mm | bearing spacer, brass tube 4 x 0.45 cut to 4 | stock | tube_cut | brass_c360 | K&S Precision Metals | 9220 (4 mm x 0.45 wall brass tube), cut + deburred | 0.016 | bears on the MR63ZZ inner ring only (OD 4.0 < shield bore)
SYR-130-08p00 | 8.0 | mm | bearing spacer, brass tube 4 x 0.45 cut to 8 | stock | tube_cut | brass_c360 | K&S Precision Metals | 9220 (4 mm x 0.45 wall brass tube), cut + deburred | 0.032 | bears on the MR63ZZ inner ring only (OD 4.0 < shield bore)
SYR-130-09p00 | 9.0 | mm | bearing spacer, brass tube 4 x 0.45 cut to 9 | stock | tube_cut | brass_c360 | K&S Precision Metals | 9220 (4 mm x 0.45 wall brass tube), cut + deburred | 0.036 | bears on the MR63ZZ inner ring only (OD 4.0 < shield bore)
SYR-200A | 1 | ea | Feetech FS90R continuous-rotation servo (case, spline, horn, lead) | buy | purchased | abs_black | Feetech | FS90R | 6.5 | continuous rotation micro servo, 4.8-6 V, 110 rpm no-load @ 4.8 V
SYR-201A | 1 | ea | 12 mL luer-slip syringe (barrel 20.2 OD x 80) | buy | purchased | polypropylene_natural | BD / Terumo / Monoject | 12 mL luer slip (barrel OD 20.2 measured) | 0.25
SYR-202 | 1 | ea | 200 uL universal pipette tip | buy | purchased | polypropylene_natural | (FT-200L-RS rack) | 200 uL, 96 / rack (representative tip geometry) | 0.02
SYR-220 | 4 | ea | MR63ZZ bearing 3x6x2.5 | buy | purchased | steel_hardened_ground | NMB / SKF | MR63ZZ | 0.6
SYR-221 | 2 | ea | dowel pin ISO 2338 3m6 x 30 | buy | purchased | steel_hardened_ground | McMaster-Carr | ISO 2338 3m6x30 | 0.3
SYR-222 | 8 | ea | heat-set insert M2 x 4 | buy | purchased | brass_c360 | ruthex | RX-M2x4 | 0.1
SYR-223 | 5 | ea | heat-set insert M3 x 5.7 | buy | purchased | brass_c360 | ruthex | RX-M3x5.7 | 0.12
SYR-232 | 1 | ea | cable tie 2.5 x 100 nylon | buy | purchased | polypropylene_natural | HellermannTyton | T18R | 0.03
SYR-233 | 2 | ea | cable tie 2.5 x 200 nylon (microscope) | buy | purchased | polypropylene_natural | HellermannTyton | T30R | 0.04
SYR-240A | 1 | ea | TowerPro SG90 positional micro servo (case, spline, horn, lead) - probe arm | buy | purchased | abs_black | TowerPro | SG90 (positional, 180 deg) | 2.5 | positional micro servo, 4.8-6 V; servo hub PCA9685 ch 1
SYR-243 | 1 | ea | cable tie 2.5 x 100 nylon (probe leads) | buy | purchased | polypropylene_natural | HellermannTyton | T18R | 0.03
SYR-250A | 1 | ea | subminiature hinge-lever microswitch (D2F-01L class / KW10) - syr_home | buy | purchased | abs_black | Omron / generic | D2F-01L class / KW10-Z1P (12.8 x 5.8 x 6.5, holes 2x Ø2.1 on 6.5) | 0.6 | COM + NO: closes ~0.5 mm before the stopper bottoms; to the servo hub syr_home input (switch to GND, internal pull-up)
SYR-251 | 1 | ea | syr_home lead, 2 x 26 AWG (COM, NO) + 2.54 housing | buy | purchased | cable_pvc_black | generic | 2-core 26 AWG | 0.3
SYR-300A | 1 | ea | USB digital microscope housing | buy | purchased | abs_black | generic (Jiusion / DEPSTECH / Mustool) | 1000x 8-LED USB digital microscope | 18.0 | Ø33 x ~118 body (ASSUMED: measure); UVC camera on the laptop's USB
SYR-310A | 1 | ea | TTP223 capacitive touch module (mini) | buy | purchased | pcb_green | generic | TTP223 15 x 11 module | 0.4 | VCC 5 V, OUT -> GRBL probe pin (A5), $6=1
SYR-311 | 48.0 | mm | electrode, stainless rod Ø2 cut to 48 | stock | tube_cut | stainless_304_brushed | McMaster-Carr | 304 stainless rod Ø2 | 0.48 | tip squared and deburred
SYR-312 | 1 | ea | sensing lead TTP223 pad -> electrode (PVC, 26 AWG, 25 mm) | buy | purchased | cable_pvc_black | generic | 26 AWG hook-up wire | 0.02
SYR-313 | 1 | ea | probe cable, 3 x 28 AWG silicone, Ø3 (GND, 5 V, OUT -> 3018 probe pin A5); service loop across the arm joint | buy | purchased | cable_pvc_black | generic | 3-core 28 AWG silicone + 2.54 housing | 0.8
TM-110 | 1 | ea | tool module: USB microscope cradle | make | fdm_print | petg_print |  |  |  | on its side (module +X up), no supports; slides on the tool rail, 1x M3x10 at an index
TM-120 | 1 | ea | probe bracket (rail saddle + SG90 plate + deployed stop) | make | fdm_print | petg_print |  |  |  | Servo-deployed arm. On its +X face (servo plate on the bed), no supports; slides on the tool rail, 1x M3x10 at x = 11
TM-121 | 1 | ea | probe lid (TTP223 cover on the arm) | make | fdm_print | petg_print |  |  |  | flat, no supports; 1x M2x6
TM-122 | 1 | ea | probe arm (electrode + TTP223, on the SG90 horn) | make | fdm_print | petg_print |  |  |  | on its -X face (horn + TTP223 pockets up), no supports; electrode pinched by 1x M2x12
