JacobFV/labrat/cad/renders/parts.png

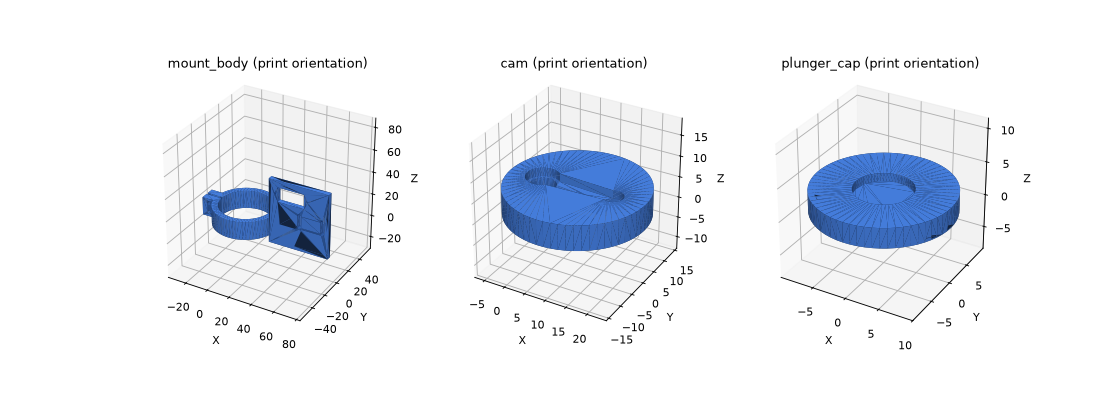
cad/renders/parts.png
