JacobFV/labrat/hardware/phone-stand/step/phone_stand_assembly.step

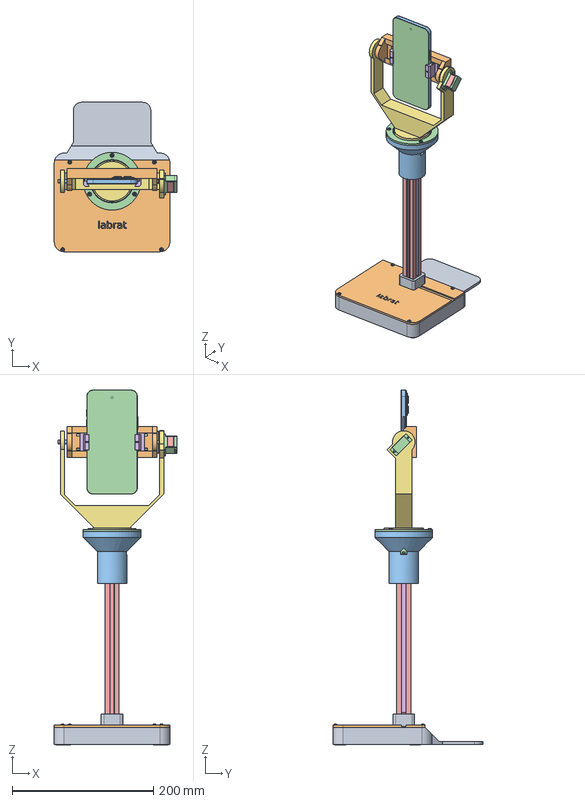
[picture p73: CAD file, 2026-10-15]
hardware/phone-stand/step/phone_stand_assembly.step
173.7 x 212.0 x 503.2 mm
base [PS-100]
lid [PS-101]
pan_housing [PS-110]
retainer [PS-111]
post [PS-201]
slot_cover [PS-206]
pad_3 [PS-205] x 4
base_screw [LIB-M5x12-CSK]
housing_screw [LIB-M5x20-BH]
pinion_insert [LIB-INS-M3] x 9
pinion_screw [LIB-M3x8-BH] x 8
pan_servo_C [PS-200A-C]
pan_servo_L [PS-200A-L]
pan_servo_S [PS-200A-S]
yoke [PS-120]
pan_horn [PS-200A-H]
tilt_servo_C [PS-200B-C]
tilt_servo_L [PS-200B-L]
tilt_servo_S [PS-200B-S]
bearing_623 [PS-202]
cradle [PS-130]
tilt_horn [PS-200B-H]
idler_spacer [PS-133]
idler_washer [LIB-M3-W433]
idler_screw [LIB-M3x16-SHCS]
jaw_r [PS-131] x 2
pinion [PS-132]
pinion_sleeve [PS-134]
spring_post_ru [LIB-M2.5x12-PAN] x 4
phone_body [LIB-PHONE-phone_body]
phone_glass [LIB-PHONE-phone_glass]
phone_bump [LIB-PHONE-phone_bump]
phone_lens [LIB-PHONE-phone_lens]
