JacobFV/labrat/cad/syringe/step/syringe_head_assembly.step

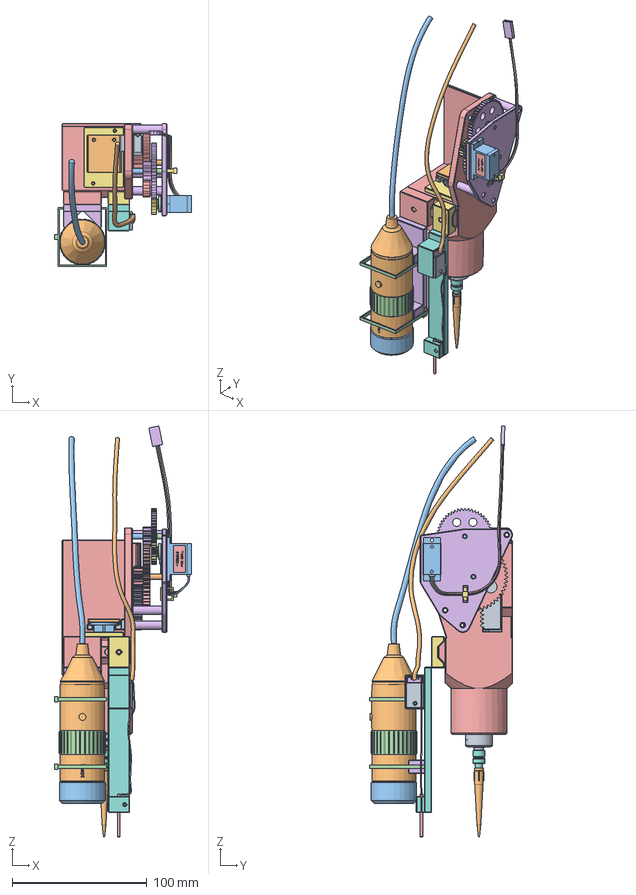
[picture p74: CAD file, 2026-10-14]
cad/syringe/step/syringe_head_assembly.step
101.7 x 106.0 x 304.5 mm
spacer_c_rear [SYR-130-01p00]
spacer_c_front [SYR-130-09p00]
spacer_b_rear [SYR-130-08p00]
spacer_b_front [SYR-130-04p00]
body [SYR-100]
plate2 [SYR-101]
flange_clamp [SYR-102]
adapter [SYR-104]
barrel [SYR-201A]
tip [SYR-202]
servo [SYR-200A]
servo_label [SYR-200C]
servo_label_print [SYR-200D]
lead_gnd [SYR-230A]
lead_vcc [SYR-230B]
lead_sig [SYR-230C]
lead_connector [SYR-231]
lead_tie [SYR-232]
pin_c [SYR-221] x 2
carriage [SYR-103]
disc_cap [SYR-105]
plunger [SYR-201C]
stopper [SYR-201D]
gear_c [SYR-112]
gear_b [SYR-111]
gear_a [SYR-110]
servo_spline [SYR-200B]
servo_horn [SYR-200E]
bearing_b_front [SYR-220] x 4
ins_rail_probe [SYR-223] x 5
ins_lid [SYR-222] x 6
mod_microscope [TM-110]
mod_probe [TM-120]
mod_probe_lid [TM-121]
microscope [SYR-300A]
microscope_cap [SYR-300B]
microscope_wheel [SYR-300C]
microscope_leds [SYR-300D]
microscope_label [SYR-300E]
microscope_usb [SYR-300F]
microscope_tie_1 [SYR-233] x 2
electrode [SYR-311]
ttp223 [SYR-310A]
ttp223_ic [SYR-310B]
electrode_lead [SYR-312]
probe_cable [SYR-313]
