JacobFV/labrat/tappet/hardware/cad/step/assembly.step

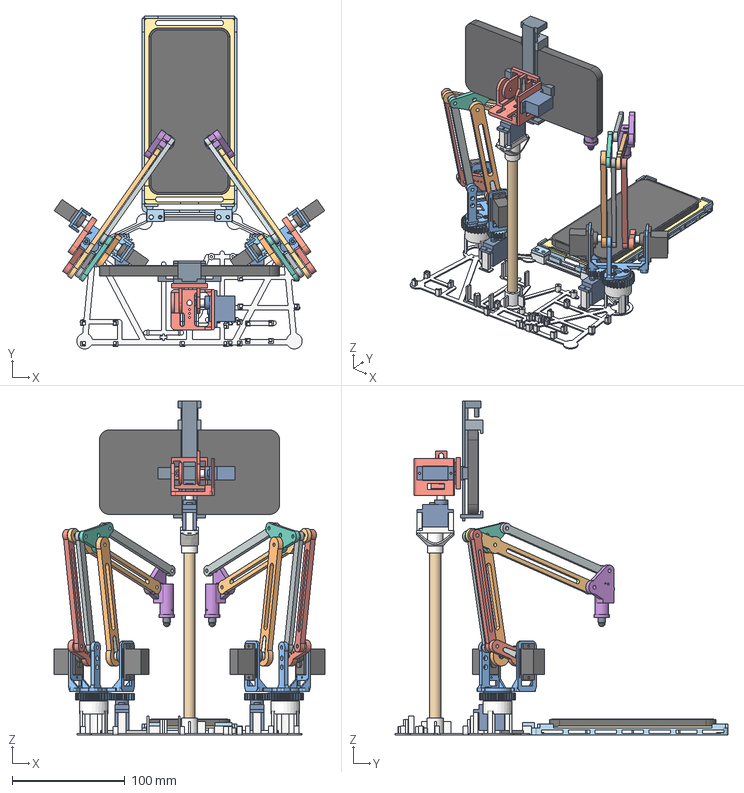
[picture p75: CAD file, 2026-10-11]
tappet/hardware/cad/step/assembly.step
240.2 x 295.5 x 296.0 mm
chassis
column_dowel
column_head
servo_pan
neck_pan_mount
horn_pan
servo_tilt
neck_tilt_bracket
horn_tilt
phone_clamp
phone_clamp_jaw
head_phone
tray
tray_shim
target_phone
turret_L
yaw_gear_turret_L
upper_arm_L
forearm_L
elbow_drive_link_L
linkage_rod_L
wrist_link_a_L
wrist_link_b_L
elbow_triangle_L
stylus_holder_L
stylus_plunger_L
stylus_tip_L
horn_shoulder_L
horn_elbow_L
servo_shoulder_L
servo_elbow_L
bearing_608_L
yaw_servo_L
yaw_gear_servo_L
turret_R
yaw_gear_turret_R
upper_arm_R
forearm_R
elbow_drive_link_R
linkage_rod_R
wrist_link_a_R
wrist_link_b_R
elbow_triangle_R
stylus_holder_R
stylus_plunger_R
stylus_tip_R
horn_shoulder_R
horn_elbow_R
servo_shoulder_R
servo_elbow_R
bearing_608_R
yaw_servo_R
yaw_gear_servo_R
