JacobFV/labrat/cad/syringe/step/assembly.step

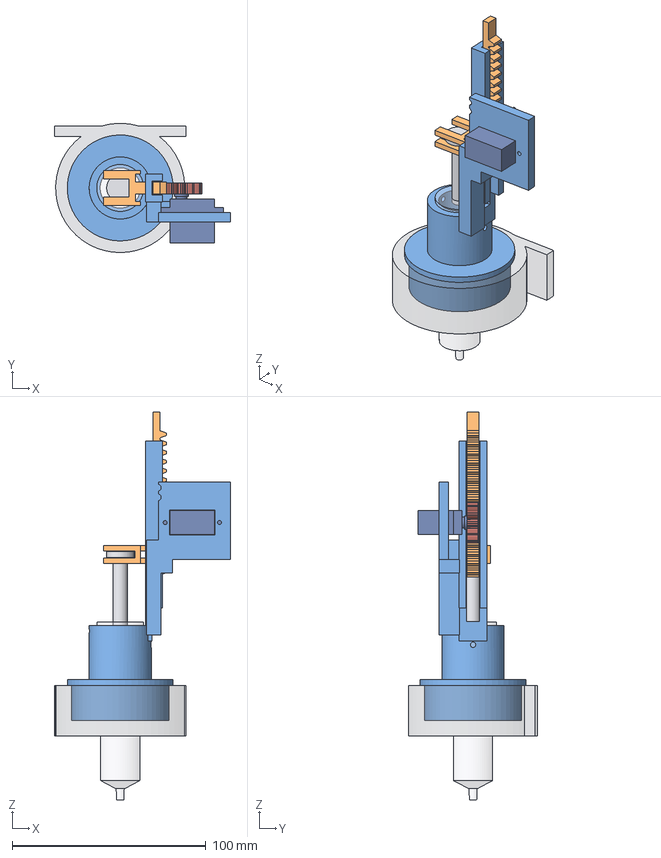
[picture p76: CAD file, 2026-10-14]
cad/syringe/step/assembly.step
91.0 x 66.5 x 200.0 mm
mount_body
rack
pinion
syringe
plunger
servo
clamp_proxy
