JacobFV/labrat/apps/console/models/so101/assets/sts3215_03a_no_horn_v1.stl

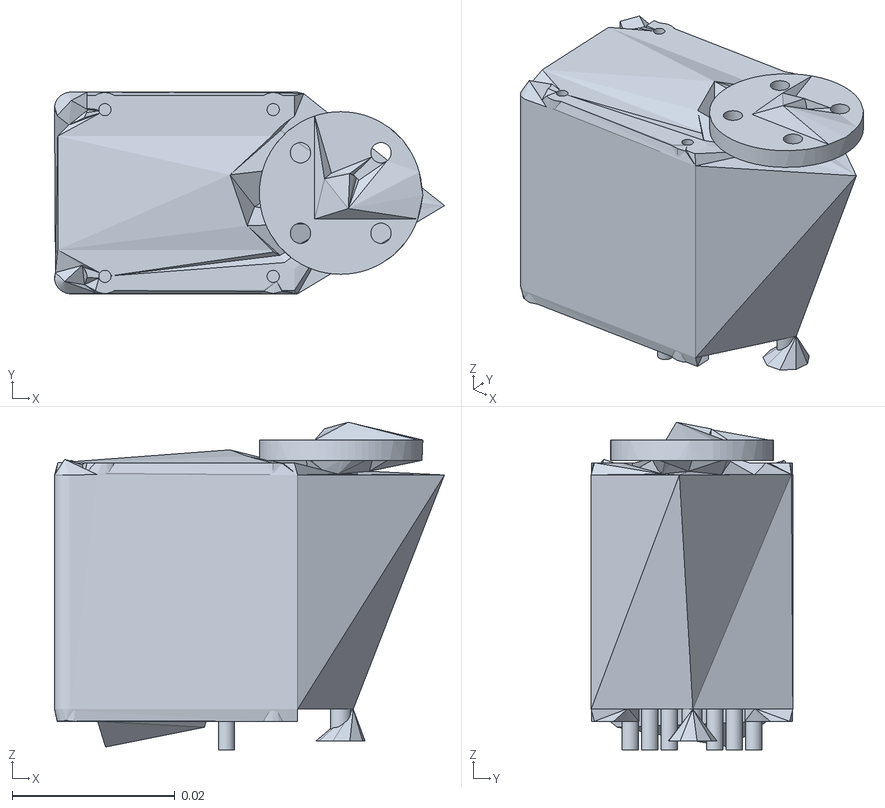
[picture p77: CAD file, 2026-10-15]
apps/console/models/so101/assets/sts3215_03a_no_horn_v1.stl
0.048 x 0.0248 x 0.0403
