JacobFV/labrat/cad/deck/step/DECK-001.step

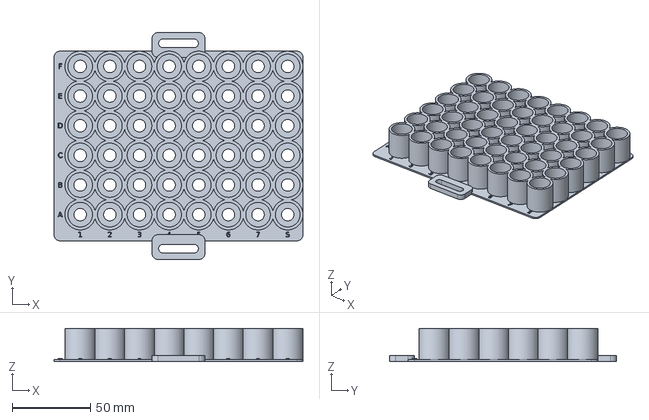
[picture p78: CAD file, 2026-10-14]
cad/deck/step/DECK-001.step
159.6 x 145.6 x 21.2 mm
