JacobFV/labrat/cad/plate_pipette.3mf

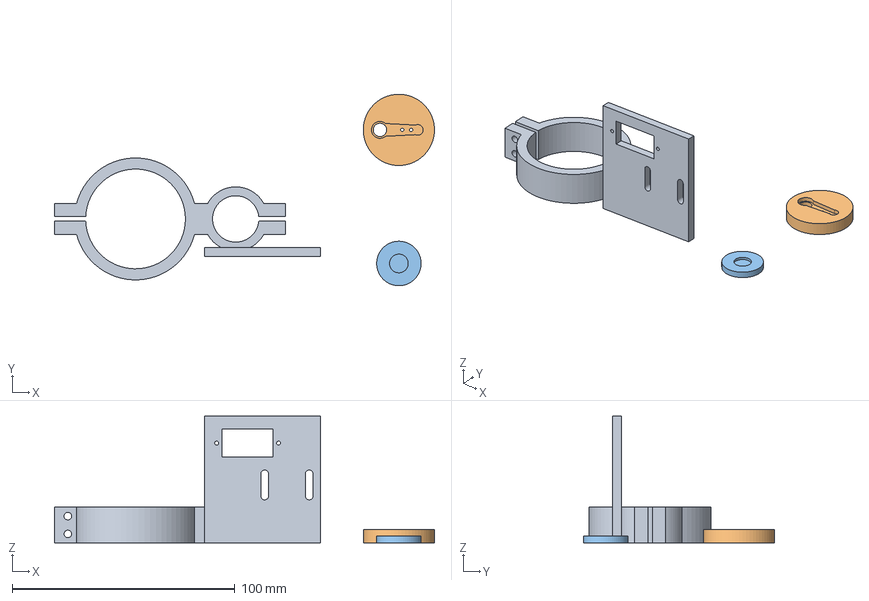
[picture p79: CAD file, 2026-10-11]
cad/plate_pipette.3mf
170.7 x 86.0 x 56.9 mm
mount_body
cam
plunger_cap
