JacobFV/labrat/cad/stl/cam.stl

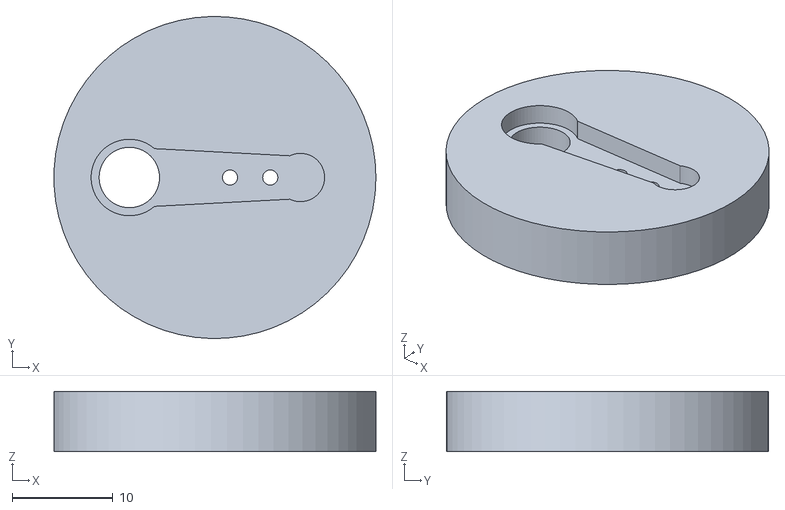
[picture p80: CAD file, 2026-10-11]
cad/stl/cam.stl
32.0 x 32.0 x 6.00
