JacobFV/labrat/cad/syringe/plate_fdm_1.3mf

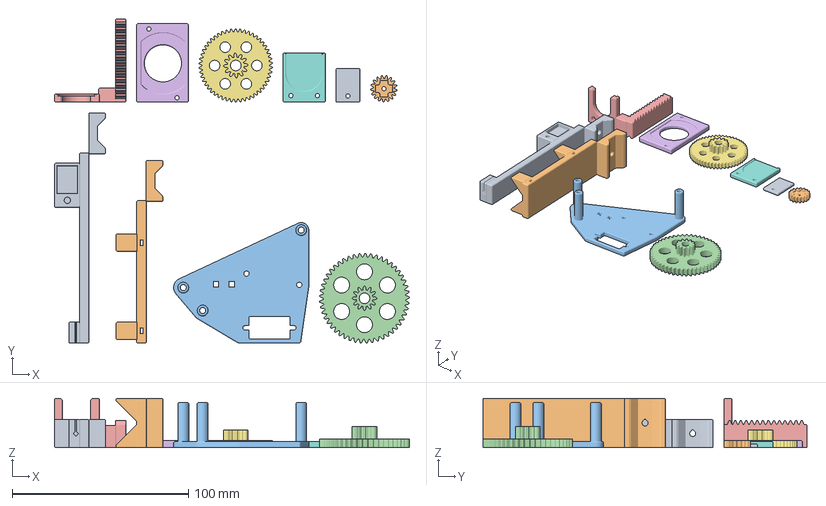
[picture p81: CAD file, 2026-10-14]
cad/syringe/plate_fdm_1.3mf
201.3 x 183.9 x 28.0 mm
TM-120_0
TM-110_0
SYR-101_0
SYR-112_0
SYR-103_0
SYR-102_0
SYR-111_0
SYR-105_0
TM-121_0
SYR-110_0
