JacobFV/labrat/cad/syringe/stl/mock_syringe.stl

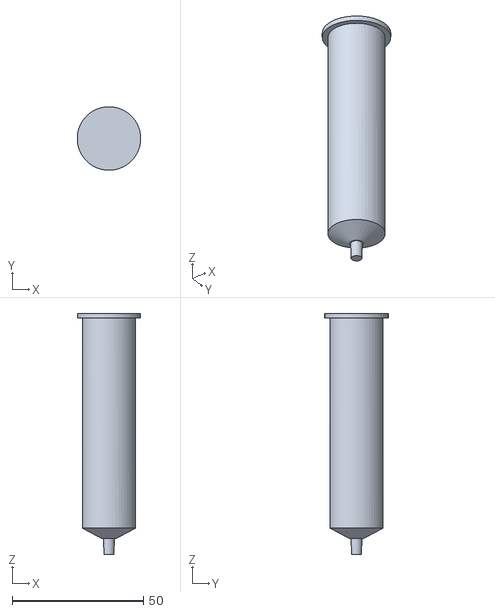
[picture p82: CAD file, 2026-10-14]
cad/syringe/stl/mock_syringe.stl
24.2 x 24.2 x 91.8
