JacobFV/labrat/cad/syringe/twin/static__abs_black.stl

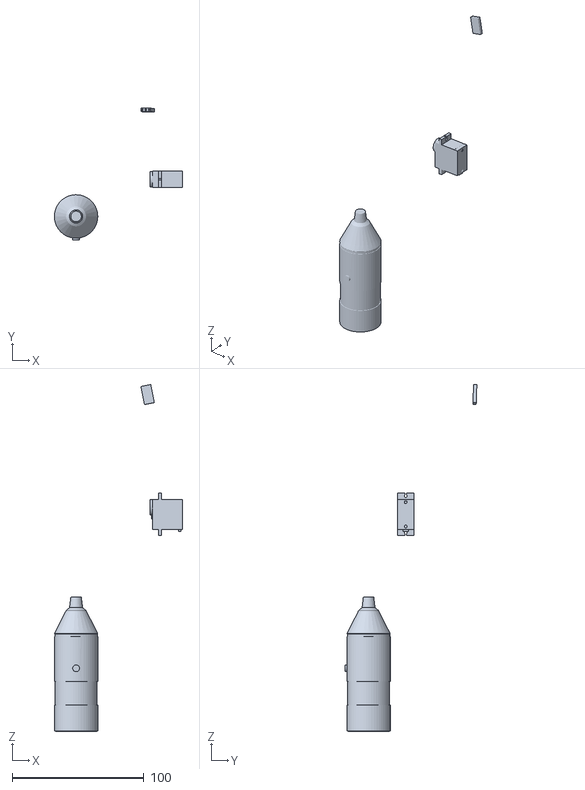
[picture p83: CAD file, 2026-10-14]
cad/syringe/twin/static__abs_black.stl
97.4 x 100.1 x 263.5
