JacobFV/labrat/hardware/deck/step/DECK-001.step

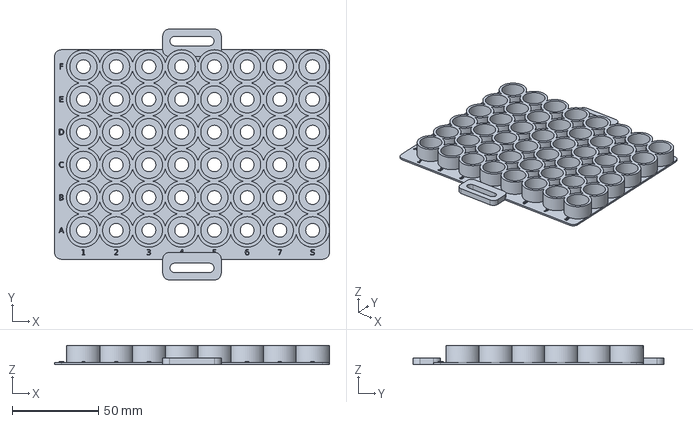
[picture p84: CAD file, 2026-10-15]
hardware/deck/step/DECK-001.step
159.6 x 145.6 x 11.2 mm
