JacobFV/labrat/hardware/phone-stand/plate_3.3mf

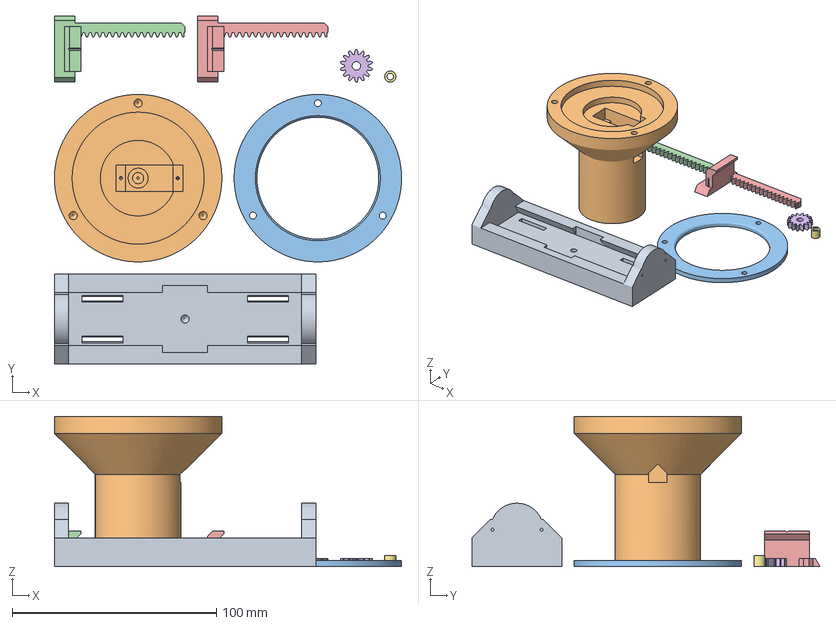
[picture p85: CAD file, 2026-10-15]
hardware/phone-stand/plate_3.3mf
170.0 x 170.4 x 73.4 mm
PS-130_1
PS-110_1
PS-111_1
PS-131_1
PS-131_2
PS-132_1
PS-133_1
