JacobFV/labrat/hardware/phone-stand/step/PS-120.step

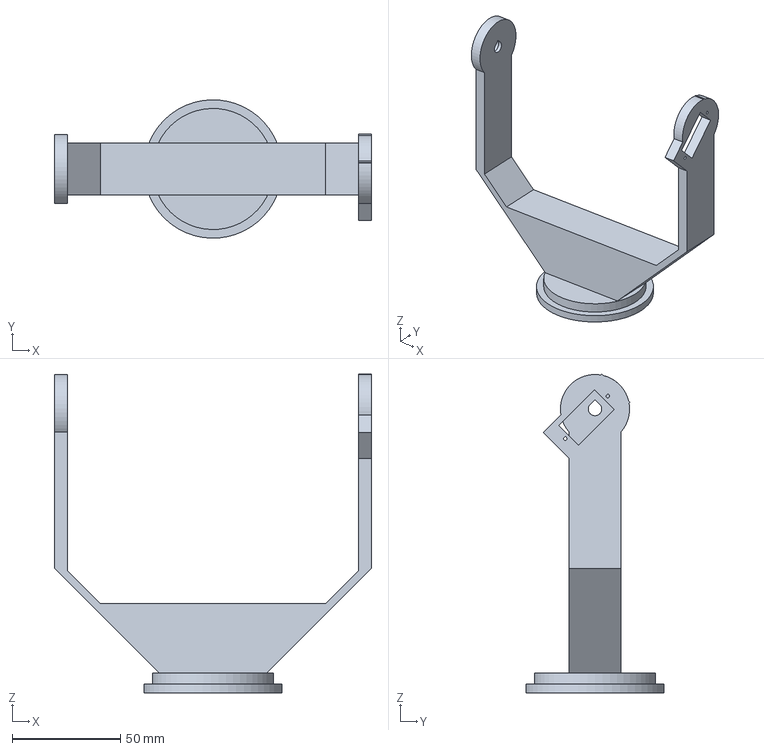
[picture p86: CAD file, 2026-10-15]
hardware/phone-stand/step/PS-120.step
146.6 x 64.0 x 147.3 mm
