JacobFV/labrat/hardware/print/plate_01_pla_toolhead_deck.3mf

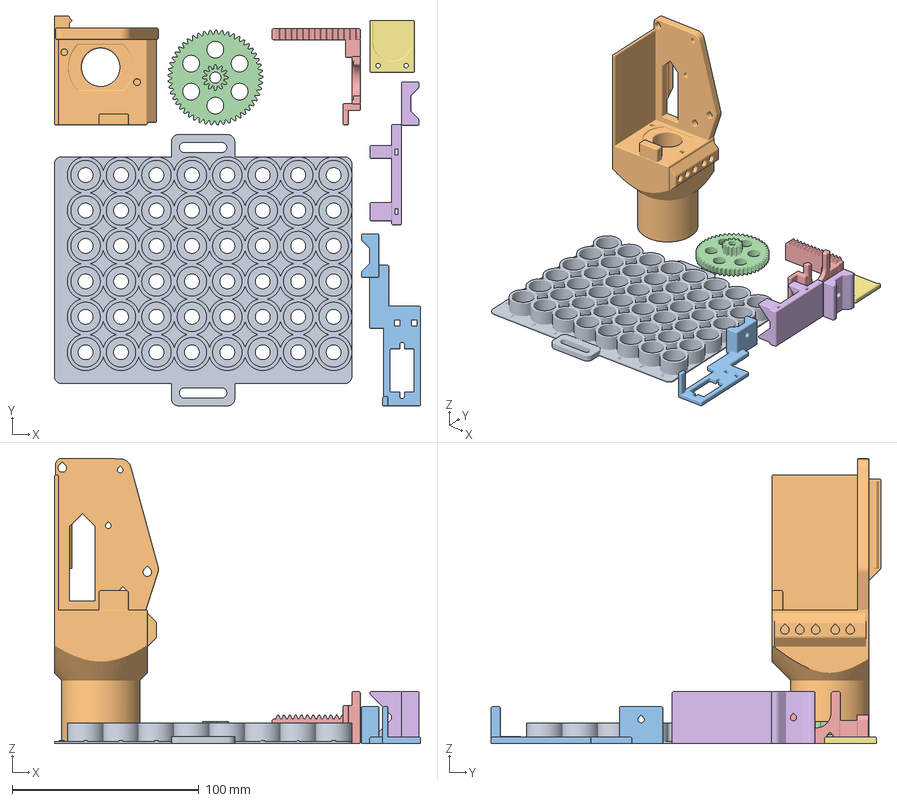
[picture p87: CAD file, 2026-10-15]
hardware/print/plate_01_pla_toolhead_deck.3mf
196.5 x 209.1 x 153.1 mm
DECK-001
SYR-100
TM-120
SYR-112
SYR-103
TM-110
SYR-105
