JacobFV/labrat/hardware/tool-head/plate_fdm_1.3mf

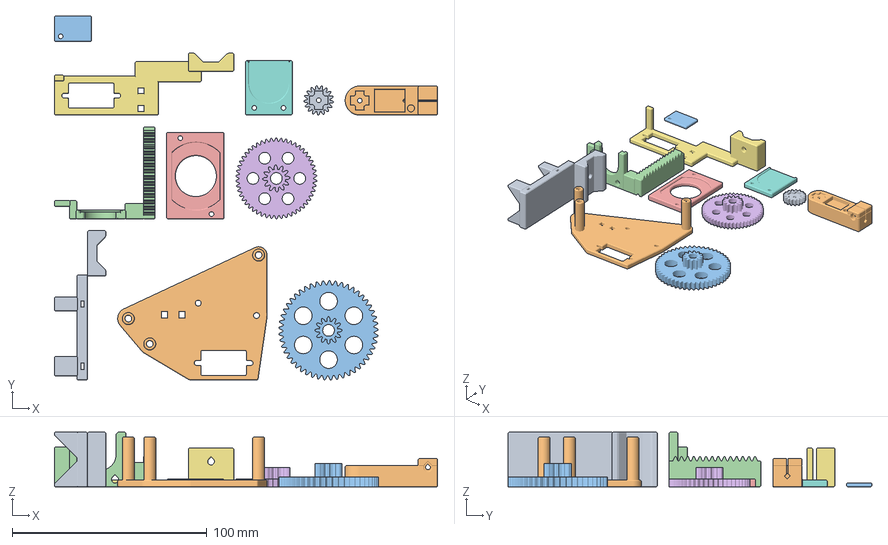
[picture p88: CAD file, 2026-10-15]
hardware/tool-head/plate_fdm_1.3mf
196.8 x 186.8 x 28.0 mm
TM-110_0
SYR-101_0
SYR-112_0
SYR-103_0
SYR-102_0
SYR-111_0
TM-120_0
SYR-105_0
SYR-110_0
TM-122_0
TM-121_0
