JacobFV/labrat/hardware/tool-head/step/SYR-100.step

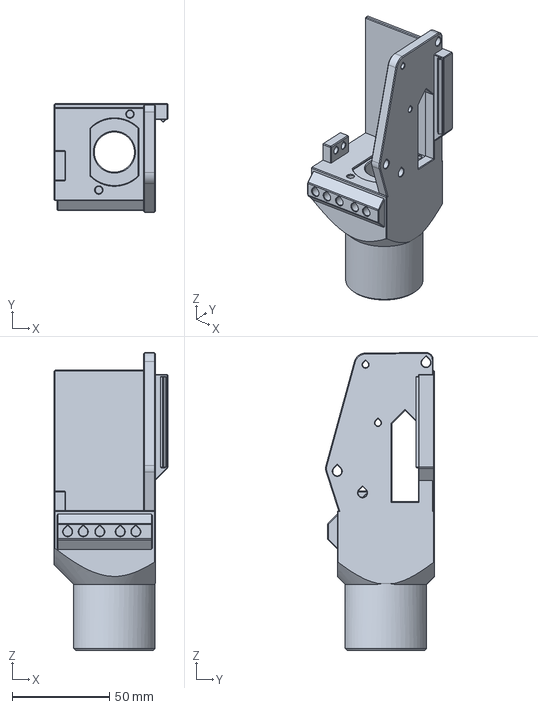
[picture p89: CAD file, 2026-10-15]
hardware/tool-head/step/SYR-100.step
58.5 x 55.9 x 153.1 mm
