JacobFV/labrat/hardware/tool-head/twin/probe__pom_black.stl

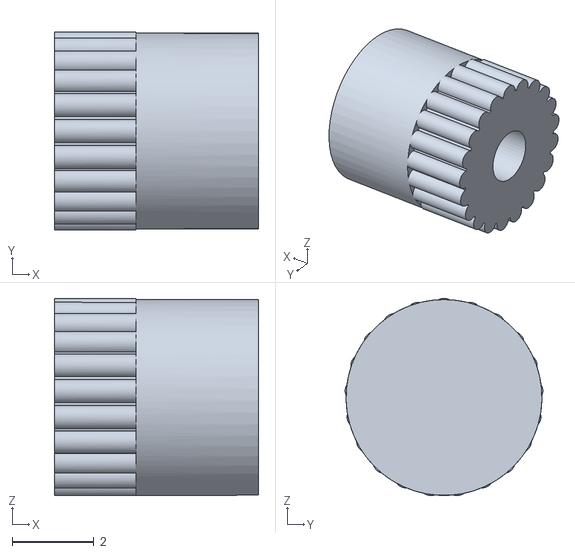
[picture p90: CAD file, 2026-10-15]
hardware/tool-head/twin/probe__pom_black.stl
5.00 x 4.85 x 4.84
