JacobFV/labrat/tappet/hardware/cad/plates/plate1_chassis_tray.stl

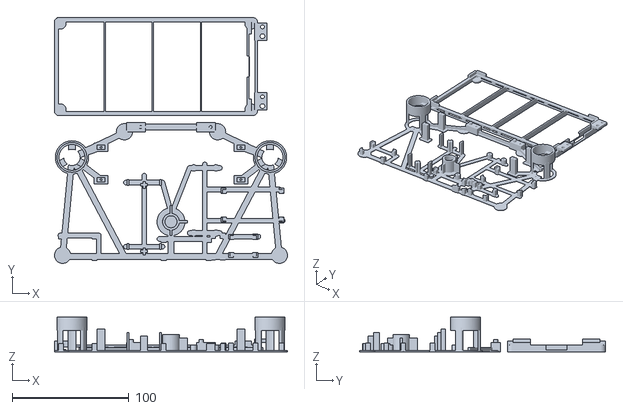
[picture p91: CAD file, 2026-10-11]
tappet/hardware/cad/plates/plate1_chassis_tray.stl
200.0 x 211.0 x 30.0
