JacobFV/labrat/tappet/hardware/cad/step/neck_pan_mount.step

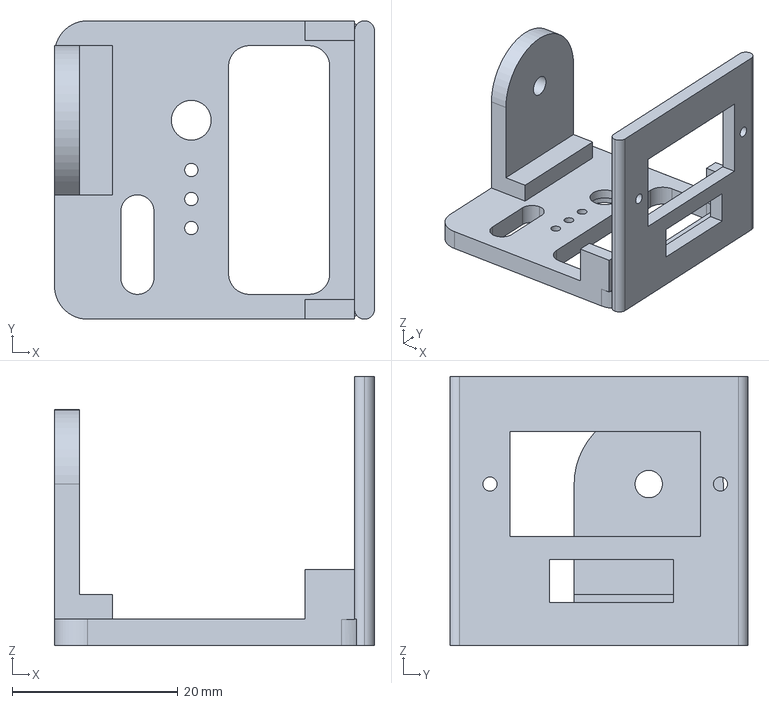
[picture p92: CAD file, 2026-10-11]
tappet/hardware/cad/step/neck_pan_mount.step
38.6 x 36.0 x 32.5 mm
