JacobFV/labrat/tappet/hardware/cad/stl/phone_clamp_jaw.stl

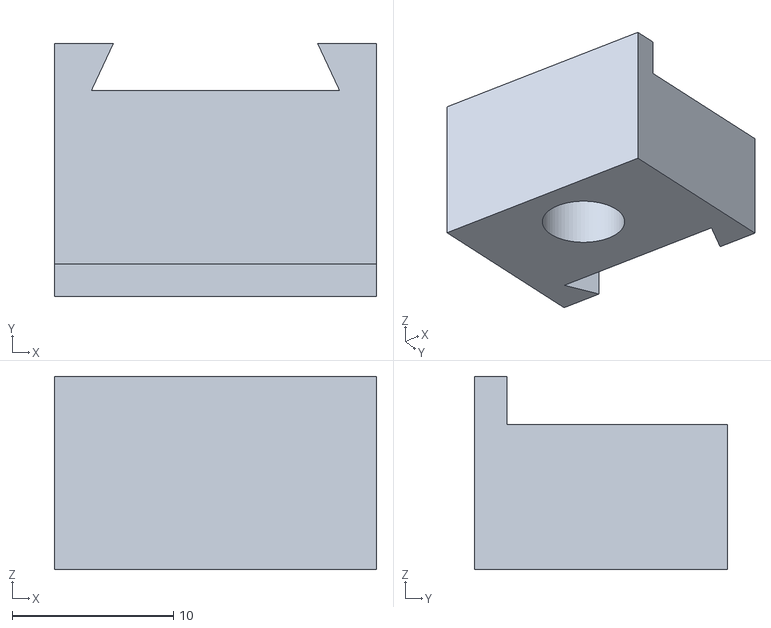
[picture p93: CAD file, 2026-10-11]
tappet/hardware/cad/stl/phone_clamp_jaw.stl
20.0 x 15.7 x 12.0
