JacobFV/labrat/web/models/so101/assets/upper_arm_so101_v1.stl

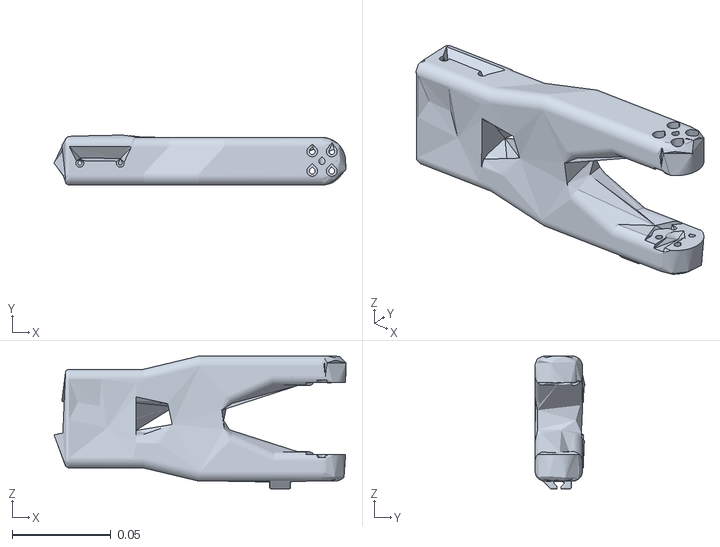
[picture p94: CAD file, 2026-10-11]
web/models/so101/assets/upper_arm_so101_v1.stl
0.148 x 0.0253 x 0.0674
