JacobFV/labrat/apps/console/models/so101/assets/under_arm_so101_v1.stl

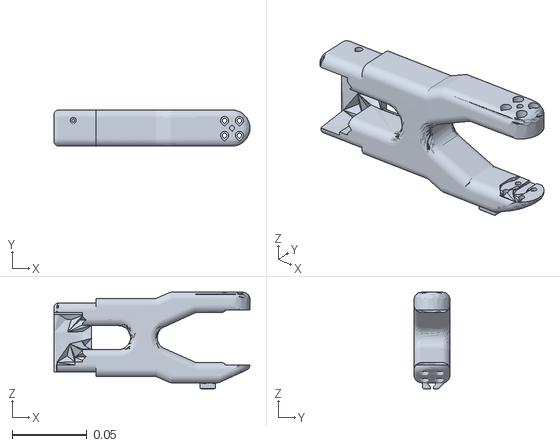
[picture p95: CAD file, 2026-10-15]
apps/console/models/so101/assets/under_arm_so101_v1.stl
0.131 x 0.024 x 0.0644
