JacobFV/labrat/cad/stl/plunger_cap.stl

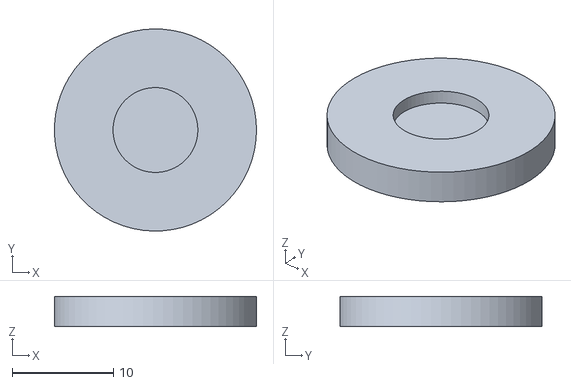
[picture p96: CAD file, 2026-10-11]
cad/stl/plunger_cap.stl
20.0 x 20.0 x 3.00
