JacobFV/labrat/cad/syringe/plate_fdm.3mf

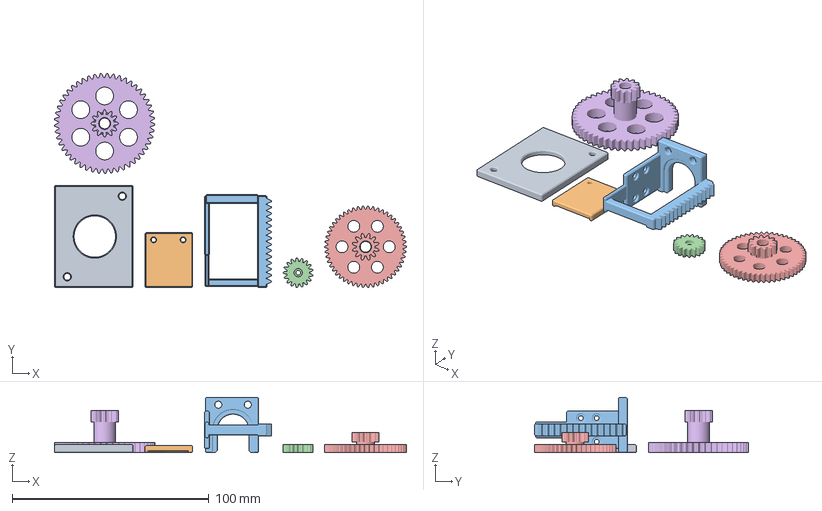
[picture p97: CAD file, 2026-10-14]
cad/syringe/plate_fdm.3mf
179.0 x 109.0 x 28.0 mm
SYR-102_0
SYR-105_0
SYR-103_0
SYR-110_0
SYR-111_0
SYR-112_0
