JacobFV/labrat/cad/syringe/stl/mock_servo.stl

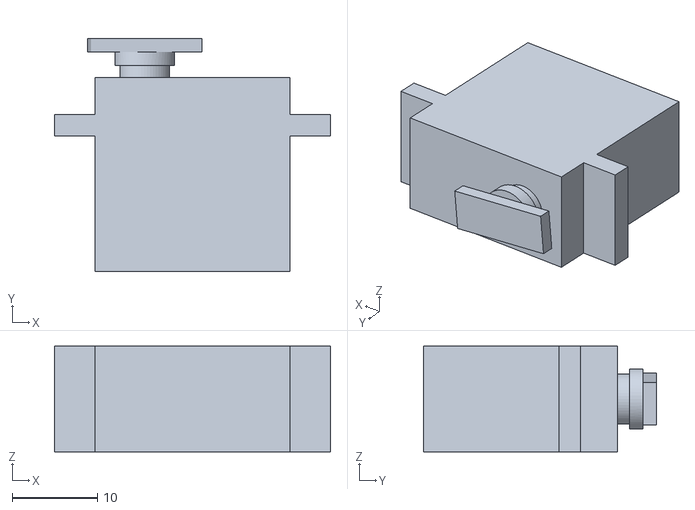
[picture p98: CAD file, 2026-10-14]
cad/syringe/stl/mock_servo.stl
32.3 x 27.3 x 12.4
