JacobFV/labrat/cad/syringe/twin/static__stainless_304_brushed.stl

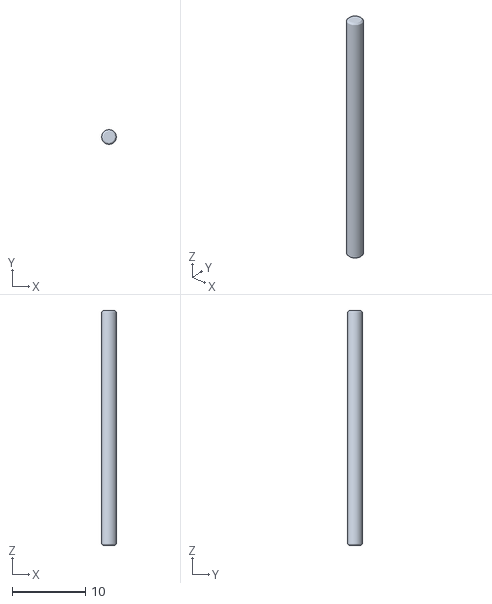
[picture p99: CAD file, 2026-10-14]
cad/syringe/twin/static__stainless_304_brushed.stl
2.00 x 2.00 x 32.0
