JacobFV/labrat/hardware/phone-stand/plate_2.3mf

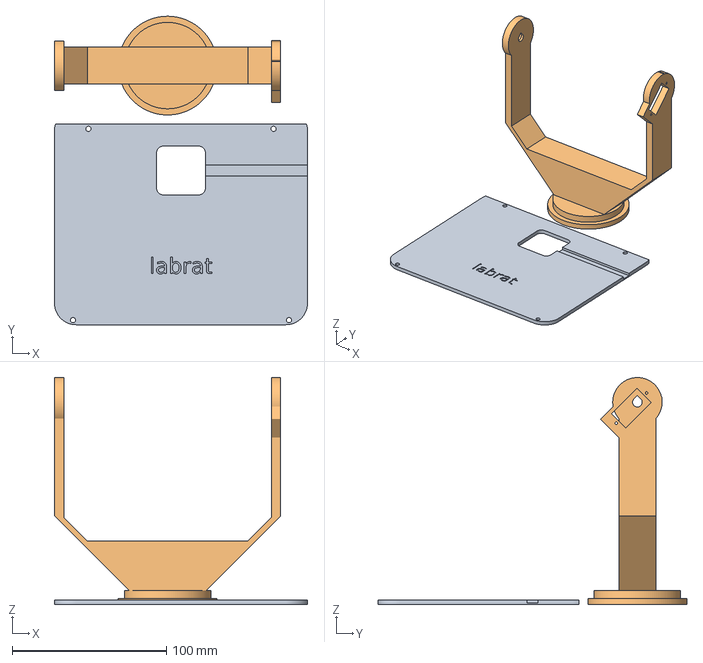
[picture p100: CAD file, 2026-10-15]
hardware/phone-stand/plate_2.3mf
164.0 x 200.0 x 147.3 mm
PS-101_1
PS-120_1
