JacobFV/labrat/hardware/phone-stand/step/PS-101.step

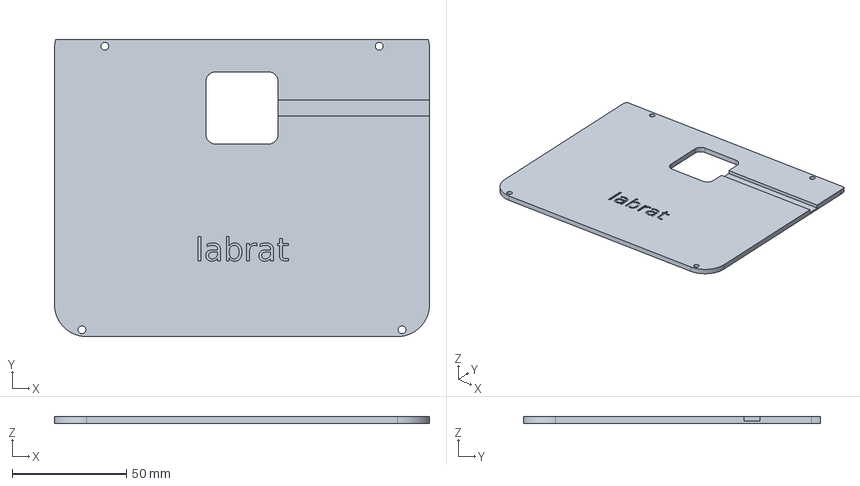
[picture p101: CAD file, 2026-10-15]
hardware/phone-stand/step/PS-101.step
164.0 x 130.0 x 3.00 mm
