JacobFV/labrat/hardware/print/plate_02_pla_toolhead_deck.3mf

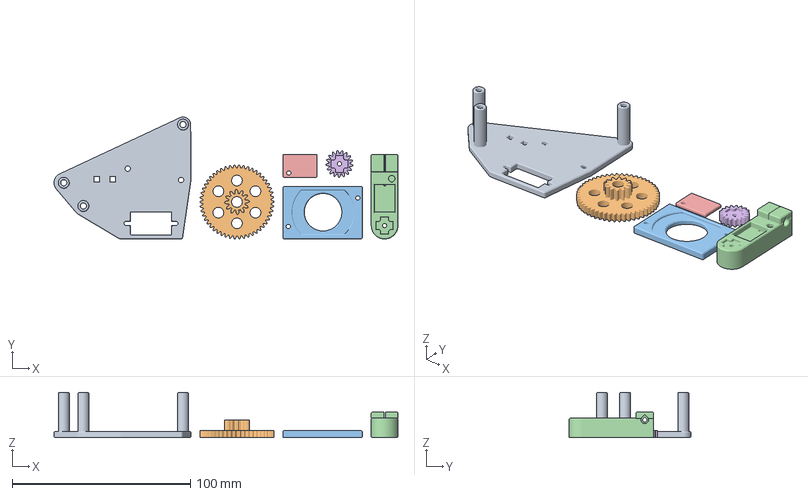
[picture p102: CAD file, 2026-10-15]
hardware/print/plate_02_pla_toolhead_deck.3mf
192.9 x 68.4 x 25.5 mm
SYR-101
SYR-111
SYR-102
TM-122
TM-121
SYR-110
