JacobFV/labrat/hardware/tool-head/step/SYR-105.step

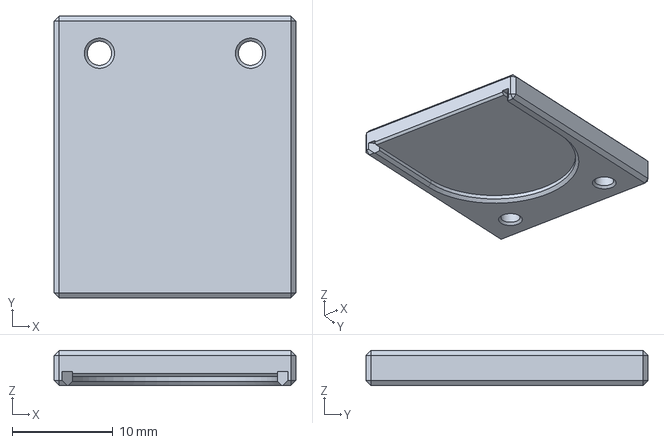
[picture p103: CAD file, 2026-10-15]
hardware/tool-head/step/SYR-105.step
24.0 x 28.0 x 3.50 mm
