JacobFV/labrat/hardware/tool-head/twin/static__petg_print__mod_probe.stl

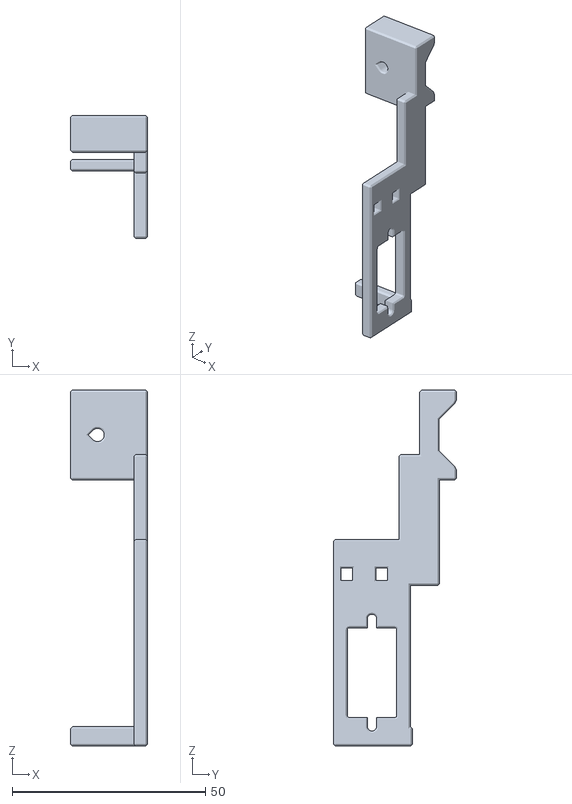
[picture p104: CAD file, 2026-10-15]
hardware/tool-head/twin/static__petg_print__mod_probe.stl
19.9 x 31.9 x 92.2
