JacobFV/labrat/tappet/hardware/cad/plates/plate5_gears_stylus.3mf

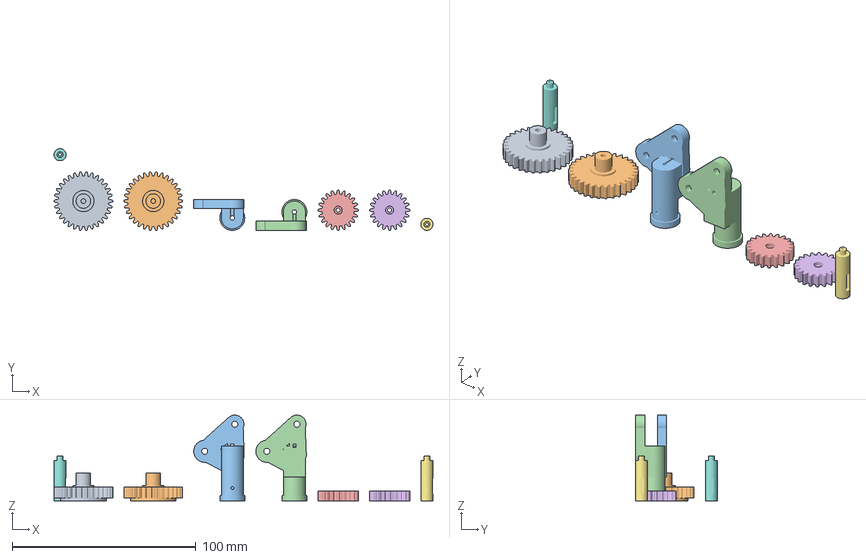
[picture p105: CAD file, 2026-10-11]
tappet/hardware/cad/plates/plate5_gears_stylus.3mf
206.2 x 44.5 x 46.7 mm
yaw_gear_turret_1
yaw_gear_turret_2
stylus_holder_L
stylus_holder_R
yaw_gear_servo_1
yaw_gear_servo_2
stylus_plunger_1
stylus_plunger_2
