JacobFV/labrat/tappet/hardware/cad/step/stylus_plunger.step

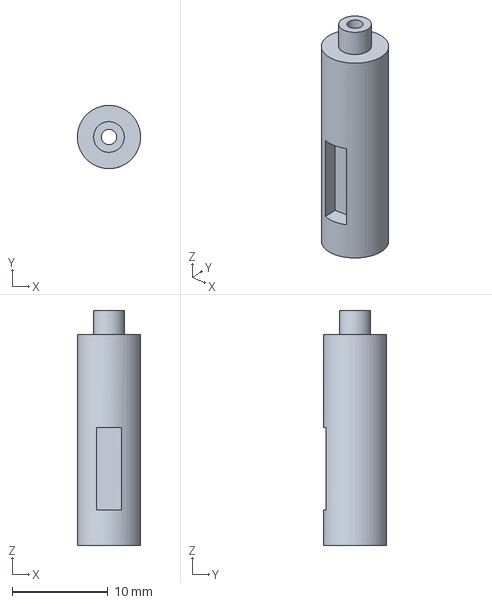
[picture p106: CAD file, 2026-10-11]
tappet/hardware/cad/step/stylus_plunger.step
6.59 x 6.60 x 24.5 mm
