JacobFV/labrat/tappet/hardware/cad/stl/tray.stl

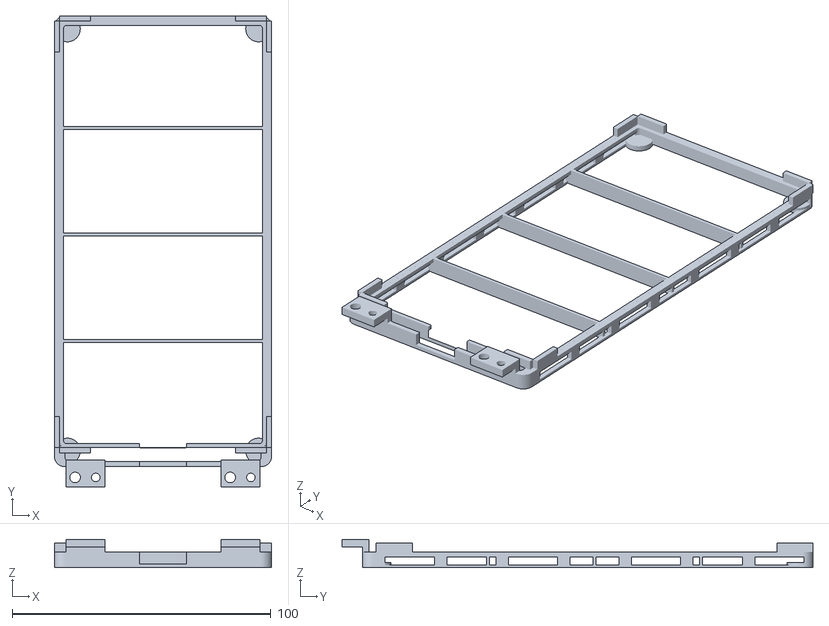
[picture p107: CAD file, 2026-10-11]
tappet/hardware/cad/stl/tray.stl
84.0 x 182.2 x 11.0
