JacobFV/labrat/web/models/so101/assets/wrist_roll_pitch_so101_v2.stl

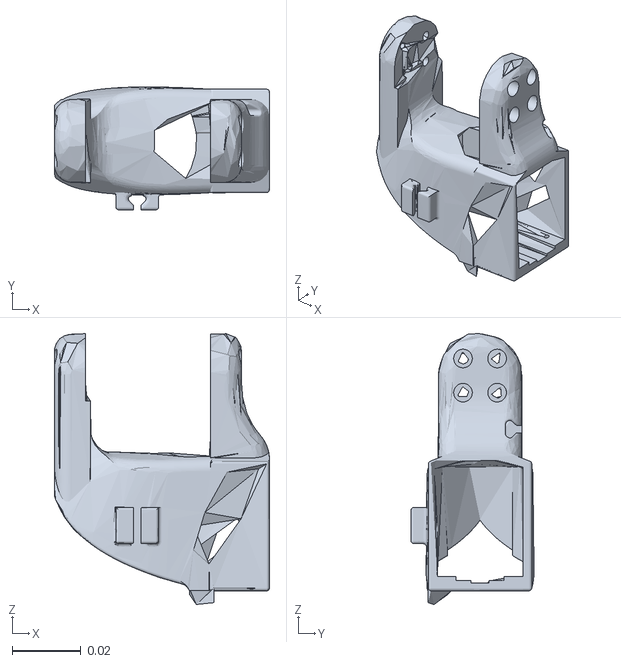
[picture p108: CAD file, 2026-10-11]
web/models/so101/assets/wrist_roll_pitch_so101_v2.stl
0.0623 x 0.0357 x 0.0786
