JacobFV/labrat/apps/console/models/so101/assets/motor_holder_so101_wrist_v1.stl

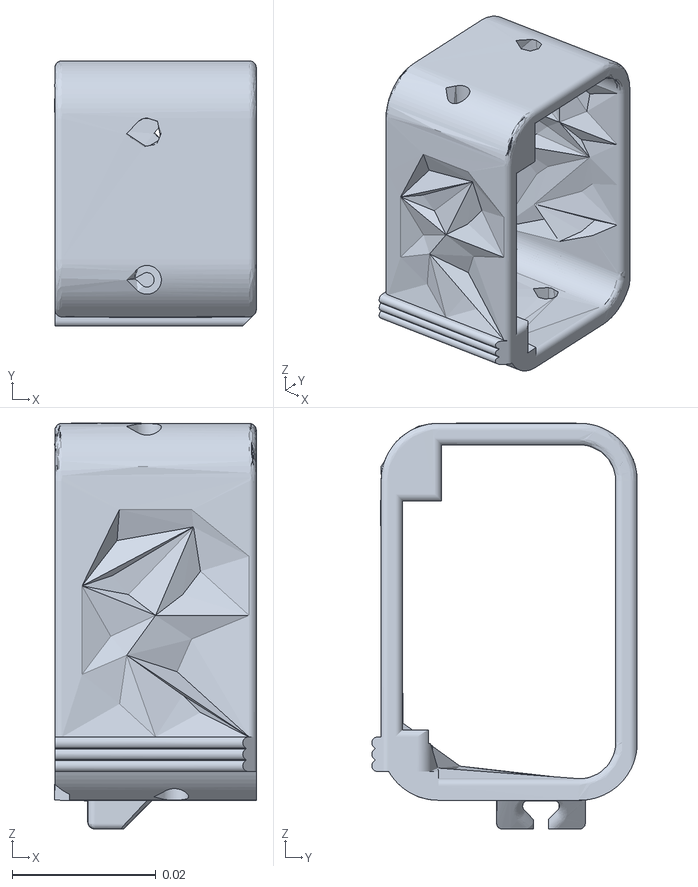
[picture p109: CAD file, 2026-10-15]
apps/console/models/so101/assets/motor_holder_so101_wrist_v1.stl
0.0281 x 0.0369 x 0.0564
