JacobFV/labrat/cad/stl/mount_body.stl

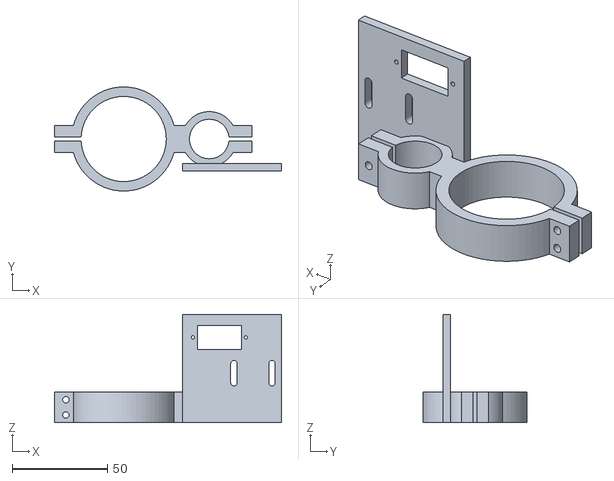
[picture p110: CAD file, 2026-10-11]
cad/stl/mount_body.stl
119.4 x 54.7 x 56.9
