JacobFV/labrat/cad/syringe/plate_syringe.3mf

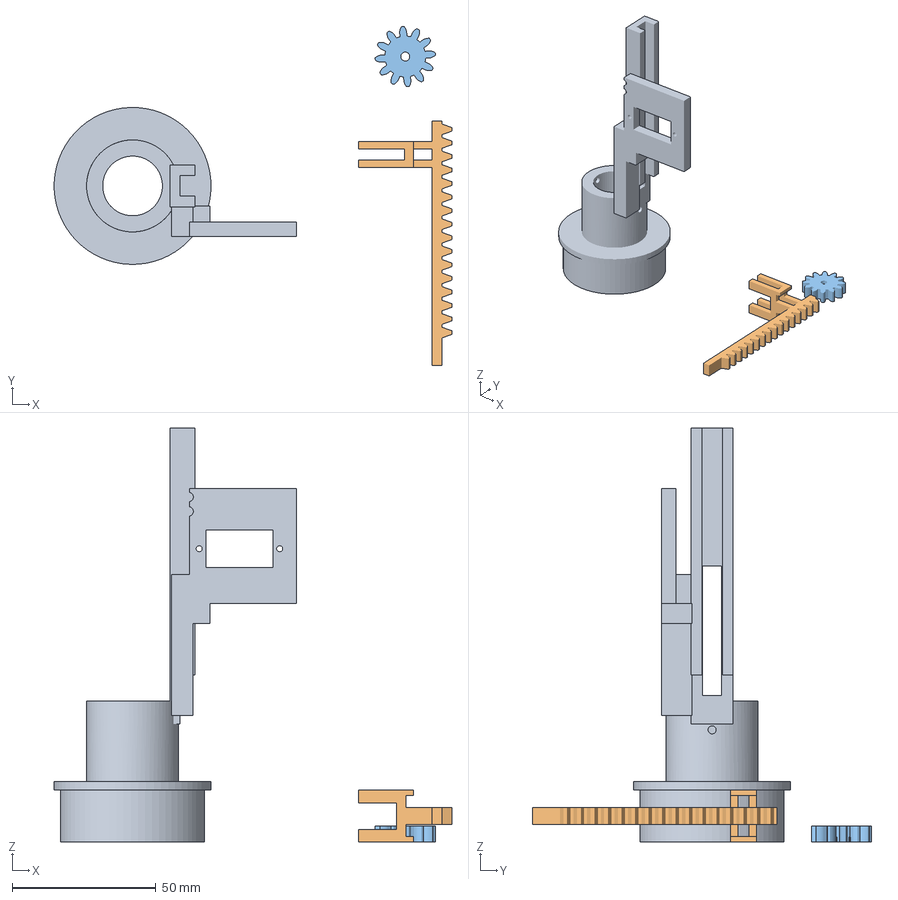
[picture p111: CAD file, 2026-10-14]
cad/syringe/plate_syringe.3mf
138.3 x 118.0 x 144.0 mm
mount_body
rack
pinion
