JacobFV/labrat/cad/syringe/stl/mock_plunger.stl

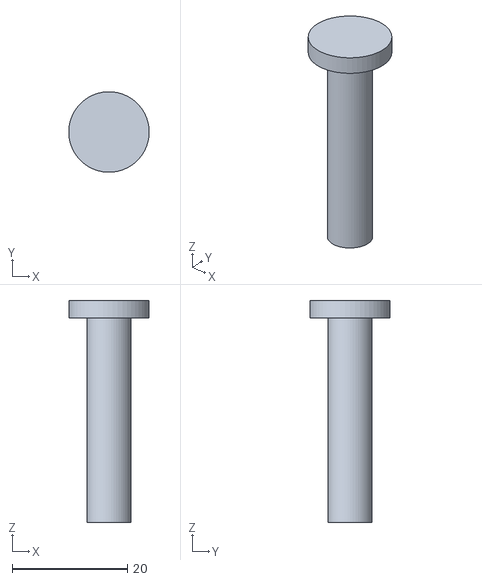
[picture p112: CAD file, 2026-10-14]
cad/syringe/stl/mock_plunger.stl
14.0 x 14.0 x 38.6
