JacobFV/labrat/cad/syringe/twin/static__syr_cable_red.stl

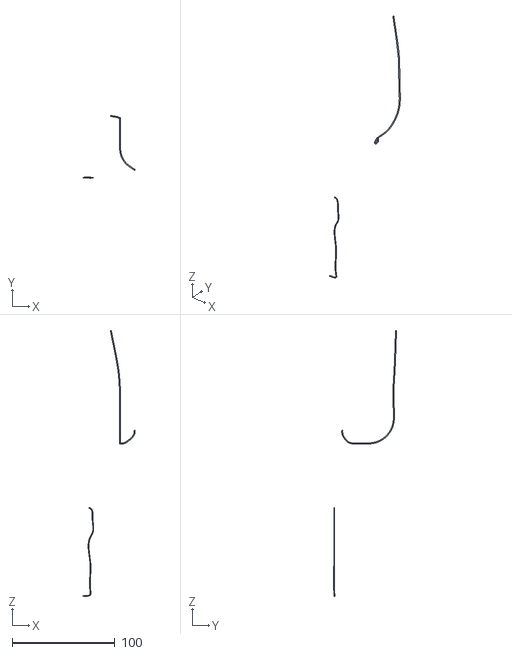
[picture p113: CAD file, 2026-10-14]
cad/syringe/twin/static__syr_cable_red.stl
51.0 x 61.4 x 259.1
