JacobFV/labrat/hardware/phone-stand/plate_1.3mf

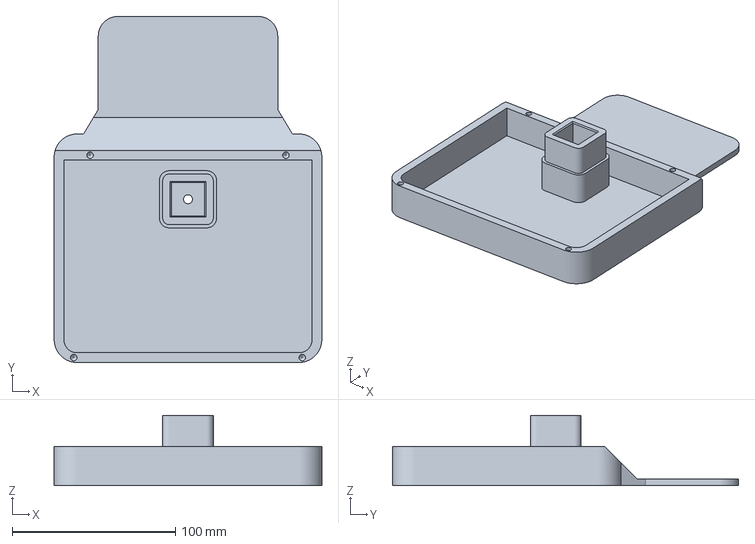
[picture p114: CAD file, 2026-10-15]
hardware/phone-stand/plate_1.3mf
164.0 x 212.0 x 43.0 mm
