JacobFV/labrat/hardware/phone-stand/step/PS-131.step

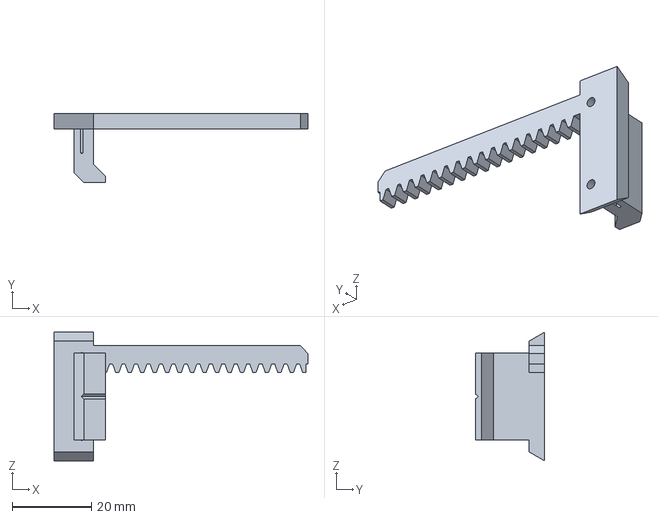
[picture p115: CAD file, 2026-10-15]
hardware/phone-stand/step/PS-131.step
64.0 x 17.4 x 32.4 mm
