JacobFV/labrat/hardware/tool-head/step/SYR-130-01p00.step

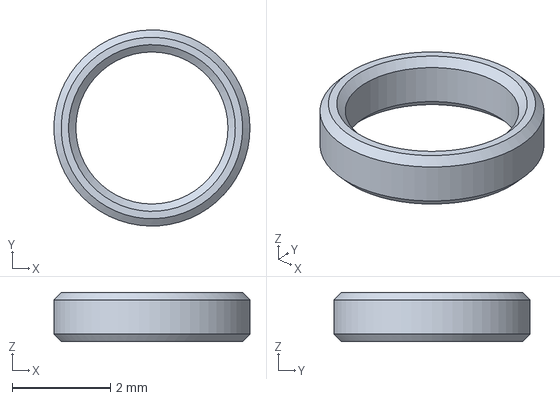
[picture p116: CAD file, 2026-10-15]
hardware/tool-head/step/SYR-130-01p00.step
4.00 x 4.00 x 1.00 mm
