JacobFV/labrat/hardware/tool-head/twin/static__print_black.stl

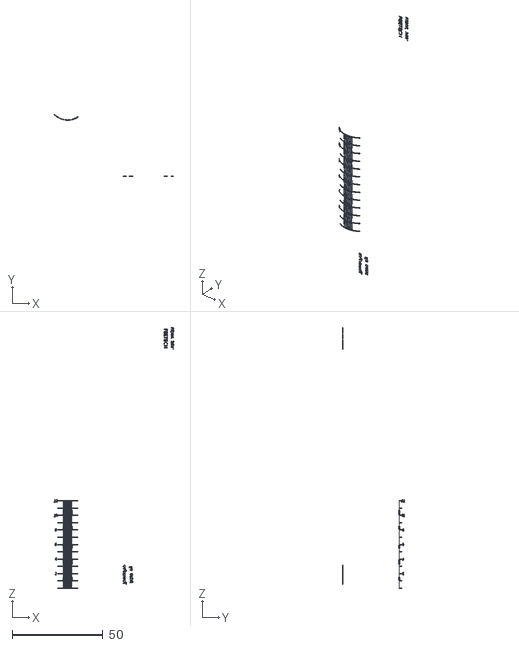
[picture p117: CAD file, 2026-10-15]
hardware/tool-head/twin/static__print_black.stl
65.8 x 34.2 x 144.0
