JacobFV/labrat/tappet/hardware/cad/plates/plate4_arm_links.stl

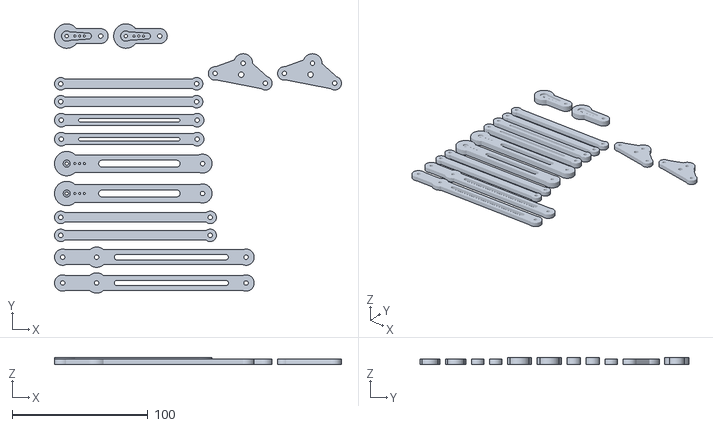
[picture p118: CAD file, 2026-10-11]
tappet/hardware/cad/plates/plate4_arm_links.stl
211.2 x 198.2 x 5.00
