JacobFV/labrat/tappet/hardware/cad/step/elbow_drive_link.step

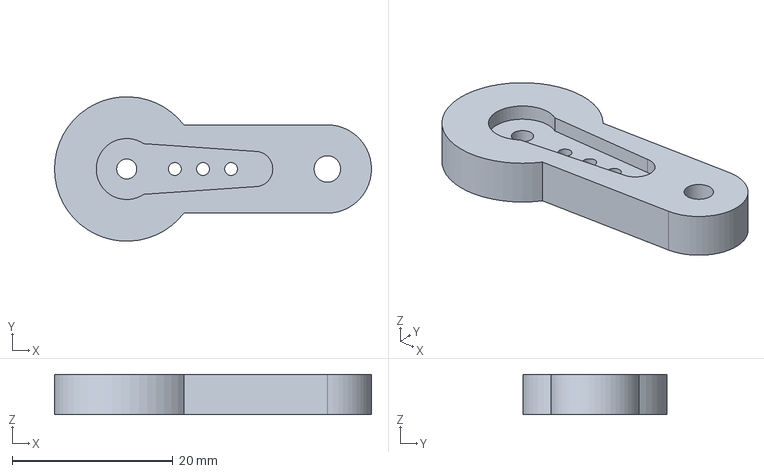
[picture p119: CAD file, 2026-10-11]
tappet/hardware/cad/step/elbow_drive_link.step
39.5 x 18.0 x 5.00 mm
