JacobFV/labrat/tappet/hardware/cad/stl/stylus_holder_R.stl

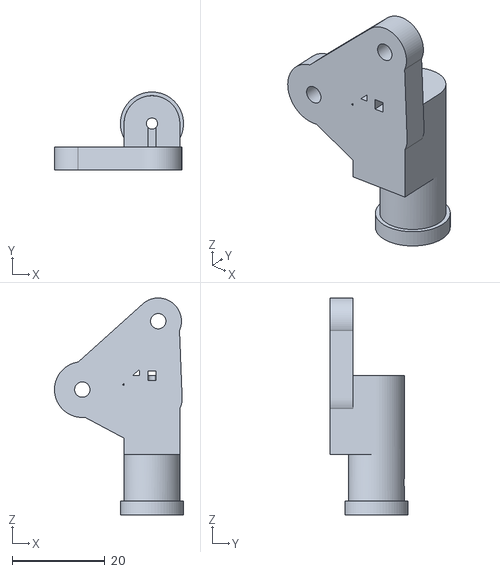
[picture p120: CAD file, 2026-10-11]
tappet/hardware/cad/stl/stylus_holder_R.stl
27.8 x 16.8 x 46.7
