JacobFV/labrat/web/models/so101/assets/sts3215_03a_v1.stl

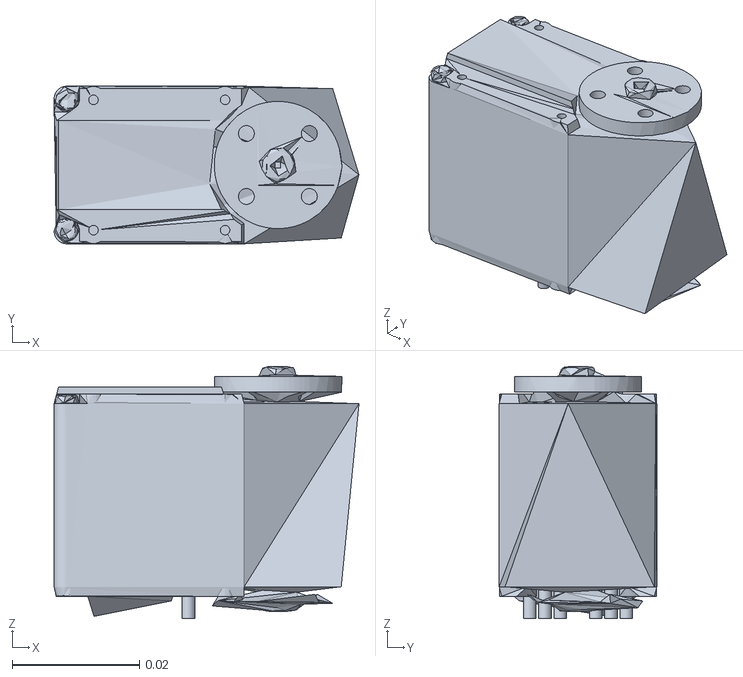
[picture p121: CAD file, 2026-10-11]
web/models/so101/assets/sts3215_03a_v1.stl
0.048 x 0.0248 x 0.0397
