JacobFV/labrat/apps/console/models/so101/assets/moving_jaw_so101_v1.stl

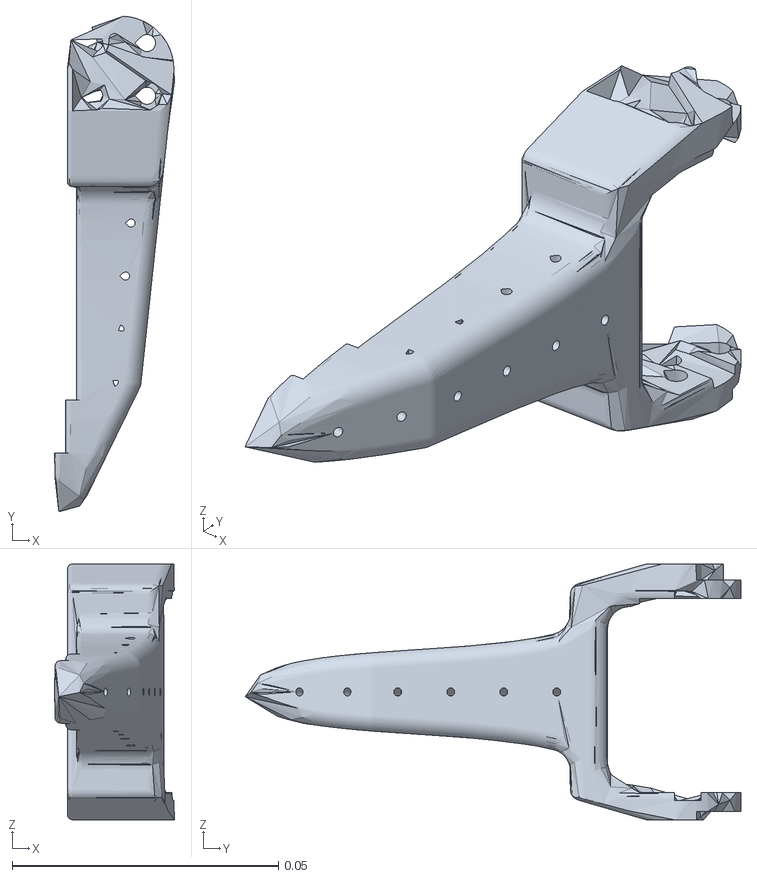
[picture p122: CAD file, 2026-10-15]
apps/console/models/so101/assets/moving_jaw_so101_v1.stl
0.0225 x 0.093 x 0.048
