JacobFV/labrat/cad/syringe/twin/static__aluminum_6063_t5_clear_anodized.stl

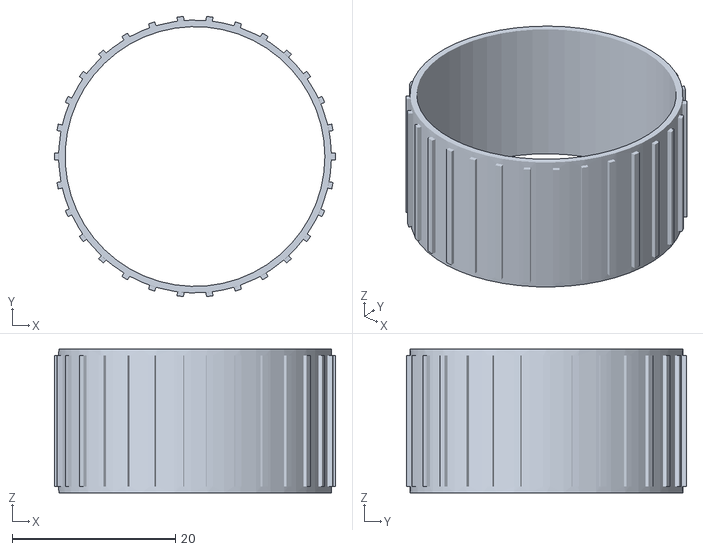
[picture p123: CAD file, 2026-10-14]
cad/syringe/twin/static__aluminum_6063_t5_clear_anodized.stl
34.4 x 34.3 x 17.6
