JacobFV/labrat/hardware/phone-stand/step/PS-130.step

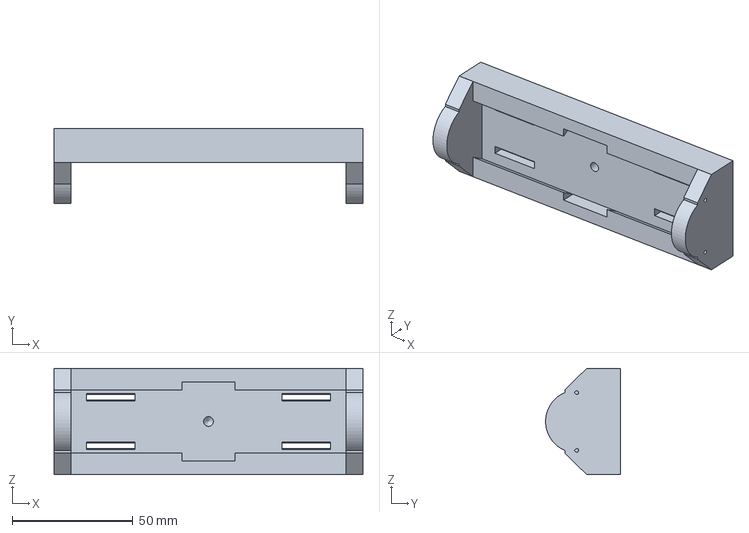
[picture p124: CAD file, 2026-10-15]
hardware/phone-stand/step/PS-130.step
128.0 x 31.0 x 44.0 mm
