JacobFV/labrat/hardware/print/plate_04_petg_stand.3mf

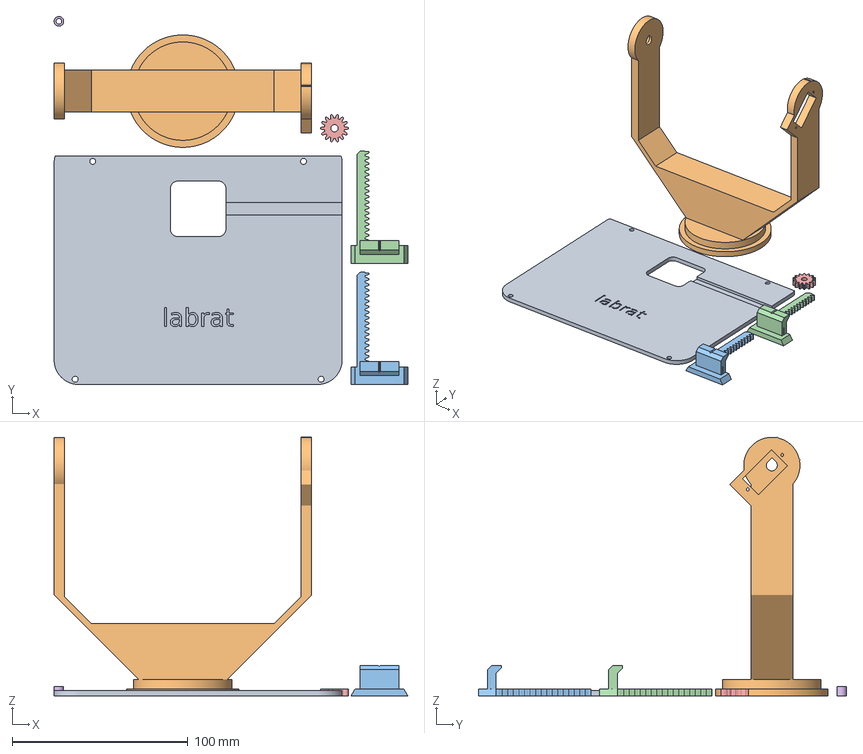
[picture p125: CAD file, 2026-10-15]
hardware/print/plate_04_petg_stand.3mf
201.4 x 209.5 x 147.3 mm
PS-101
PS-120
PS-131
PS-131_2
PS-132
PS-133
