JacobFV/labrat/hardware/tool-head/step/SYR-130-08p00.step

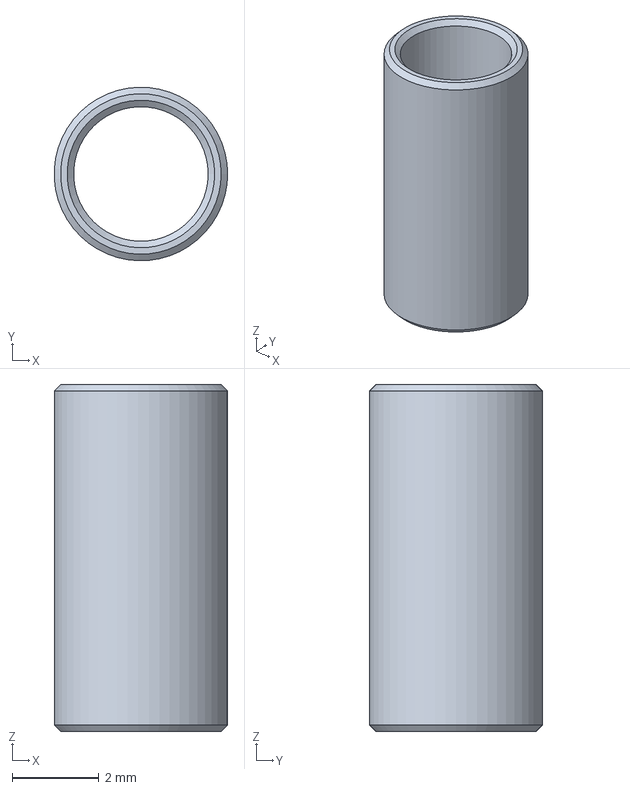
[picture p126: CAD file, 2026-10-15]
hardware/tool-head/step/SYR-130-08p00.step
4.00 x 4.00 x 8.00 mm
