JacobFV/labrat/hardware/tool-head/twin/probe__ic_epoxy_black.stl

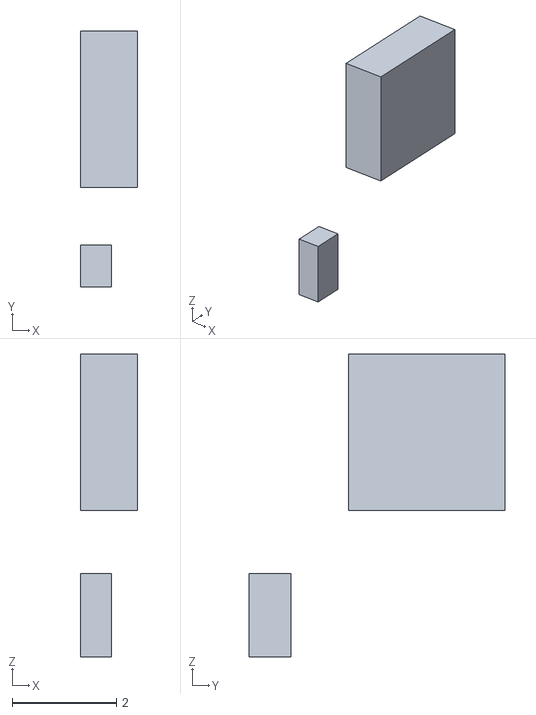
[picture p127: CAD file, 2026-10-15]
hardware/tool-head/twin/probe__ic_epoxy_black.stl
1.10 x 4.90 x 5.80
