JacobFV/labrat/tappet/hardware/cad/plates/plate2_turrets_neck_clamp.stl

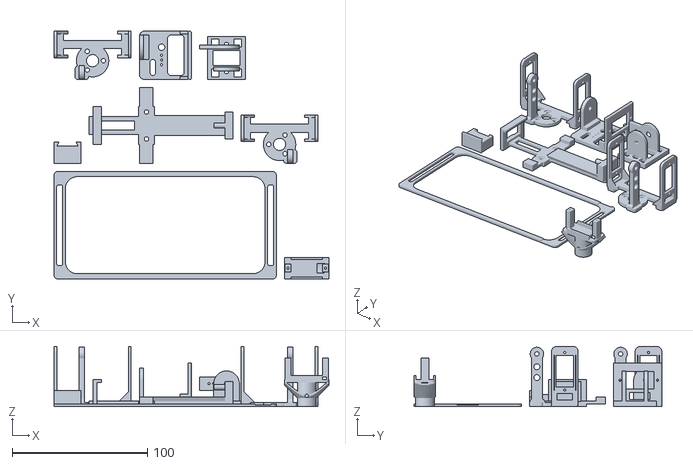
[picture p128: CAD file, 2026-10-11]
tappet/hardware/cad/plates/plate2_turrets_neck_clamp.stl
203.7 x 183.7 x 44.7
