JacobFV/labrat/tappet/hardware/cad/step/elbow_triangle.step

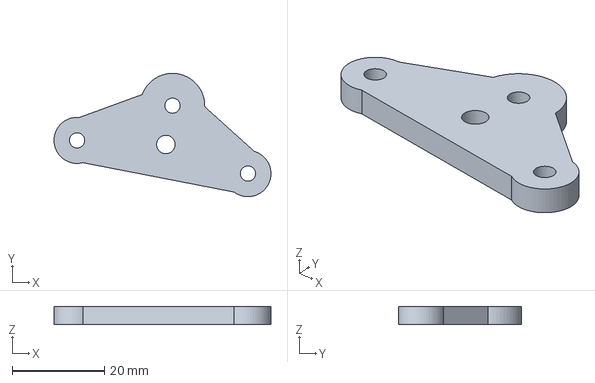
[picture p129: CAD file, 2026-10-11]
tappet/hardware/cad/step/elbow_triangle.step
47.0 x 26.7 x 4.00 mm
