JacobFV/labrat/tappet/hardware/cad/stl/upper_arm.stl

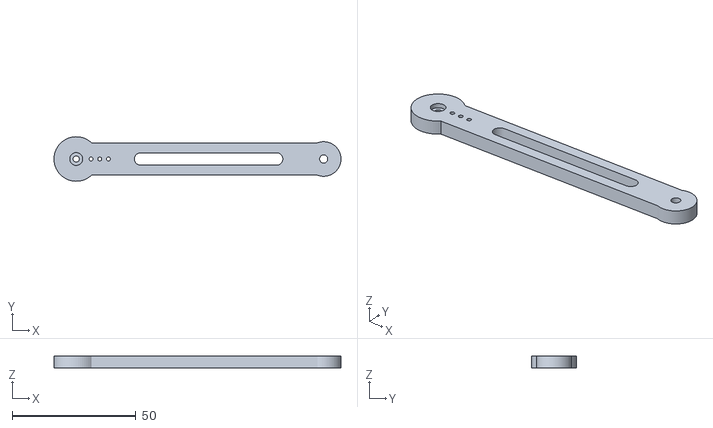
[picture p130: CAD file, 2026-10-11]
tappet/hardware/cad/stl/upper_arm.stl
116.0 x 18.0 x 5.00
