JacobFV/labrat/web/models/so101/assets/rotation_pitch_so101_v1.stl

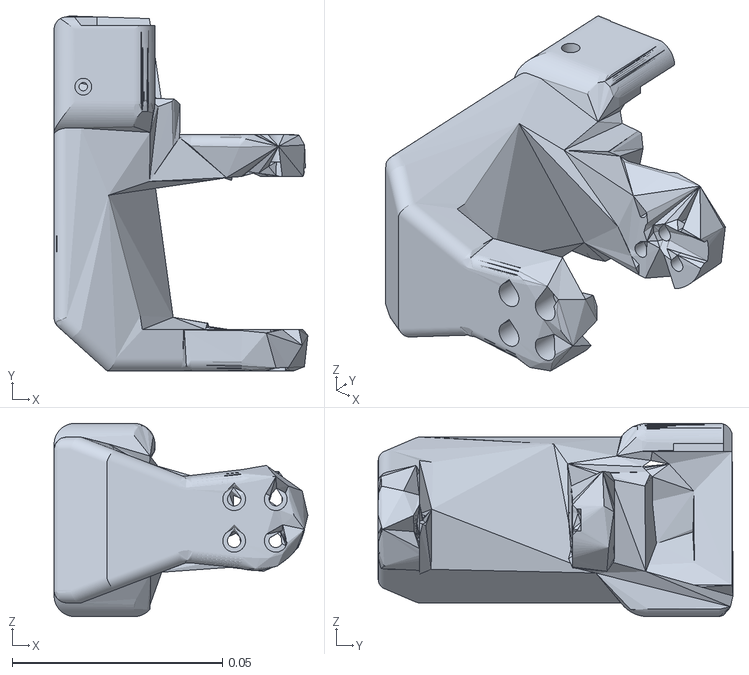
[picture p131: CAD file, 2026-10-11]
web/models/so101/assets/rotation_pitch_so101_v1.stl
0.0604 x 0.0845 x 0.046
