JacobFV/labrat/cad/syringe/twin/static__polycarbonate_clear.stl

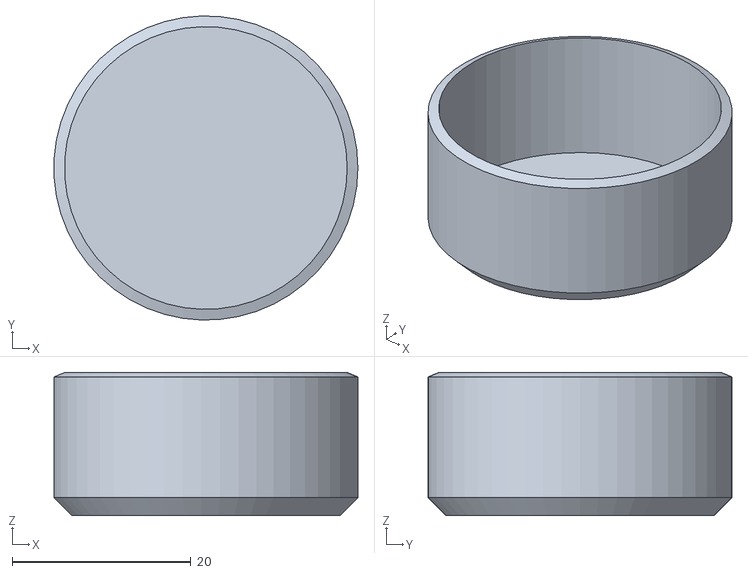
[picture p133: CAD file, 2026-10-14]
cad/syringe/twin/static__polycarbonate_clear.stl
34.0 x 34.0 x 16.0
