JacobFV/labrat/hardware/print/plate_05_petg_stand.3mf

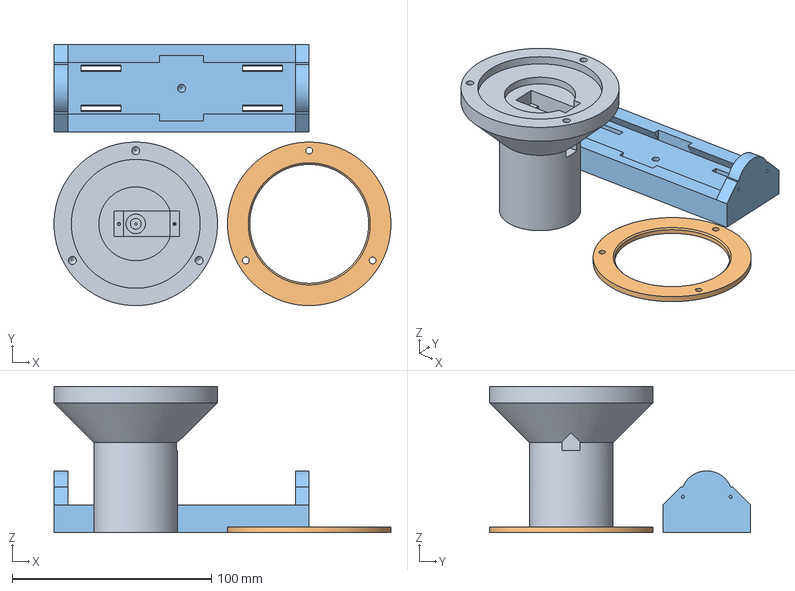
[picture p134: CAD file, 2026-10-15]
hardware/print/plate_05_petg_stand.3mf
169.0 x 131.0 x 73.4 mm
PS-110
PS-111
PS-130
