JacobFV/labrat/hardware/tool-head/step/SYR-112.step

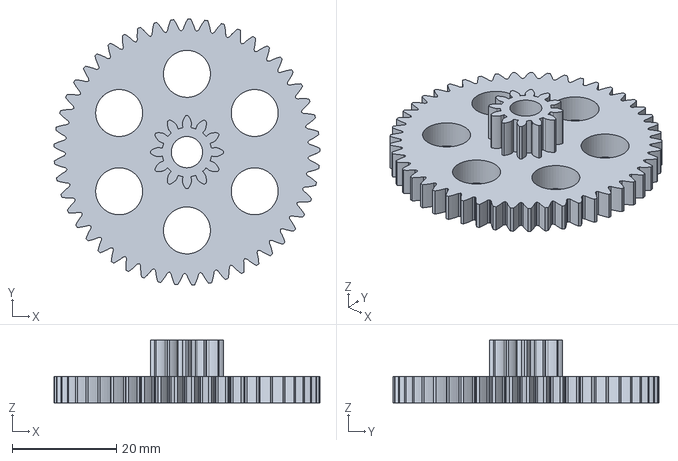
[picture p135: CAD file, 2026-10-15]
hardware/tool-head/step/SYR-112.step
51.0 x 51.0 x 12.0 mm
