JacobFV/labrat/hardware/tool-head/twin/static__cable_pvc_black.stl

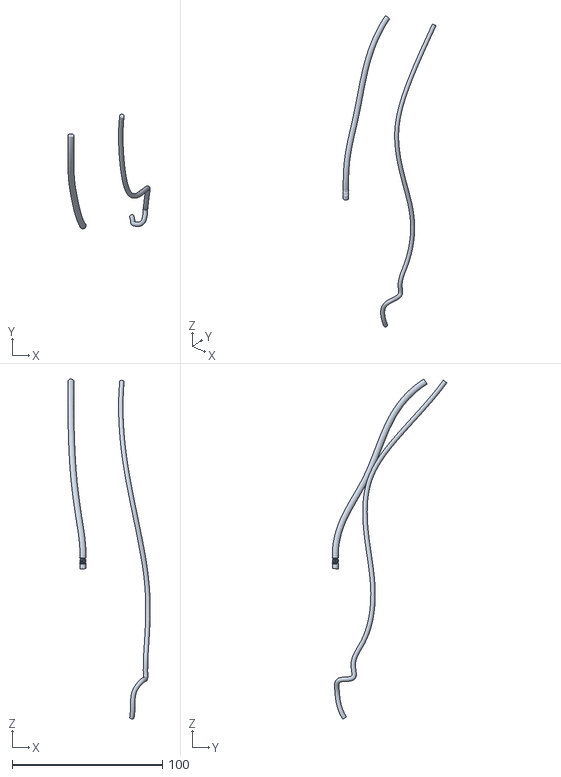
[picture p136: CAD file, 2026-10-15]
hardware/tool-head/twin/static__cable_pvc_black.stl
54.9 x 76.4 x 226.5
