JacobFV/labrat/tappet/hardware/cad/step/wrist_link_a.step

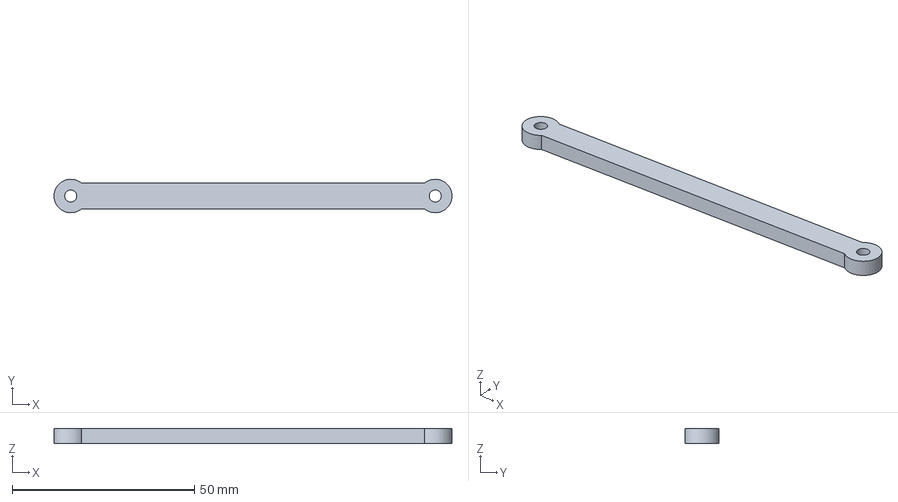
[picture p137: CAD file, 2026-10-11]
tappet/hardware/cad/step/wrist_link_a.step
109.2 x 9.20 x 4.00 mm
