JacobFV/labrat/tappet/hardware/cad/stl/turret_L.stl

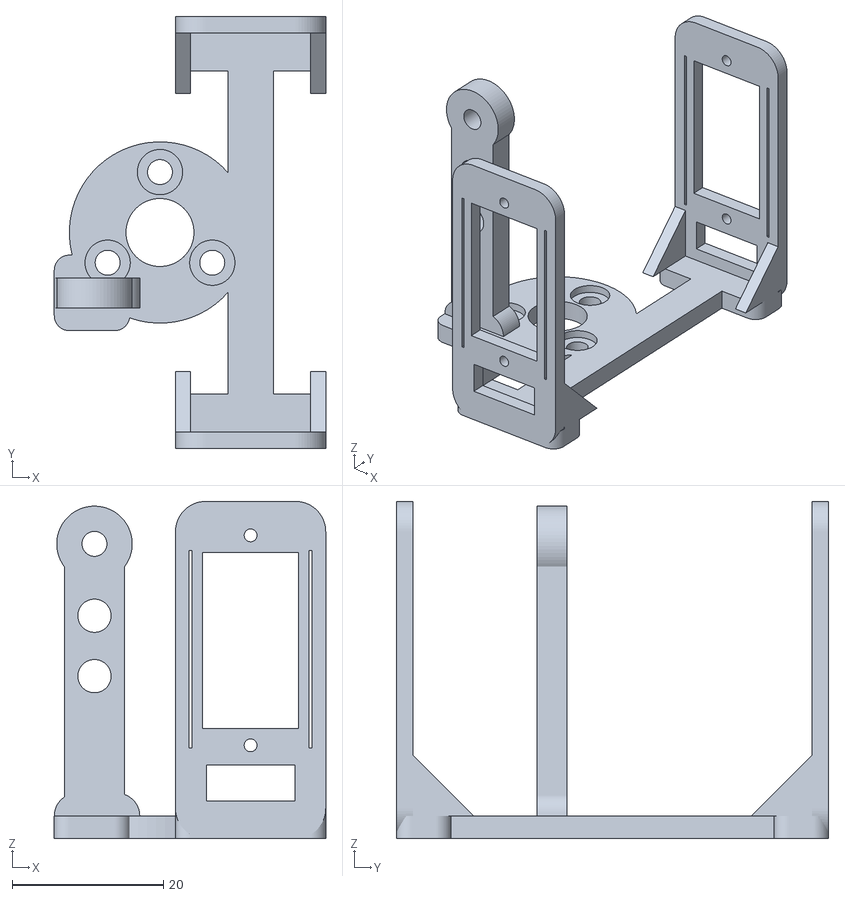
[picture p138: CAD file, 2026-10-11]
tappet/hardware/cad/stl/turret_L.stl
36.0 x 57.2 x 44.7
