JacobFV/labrat/web/models/so101/assets/base_so101_v2.stl

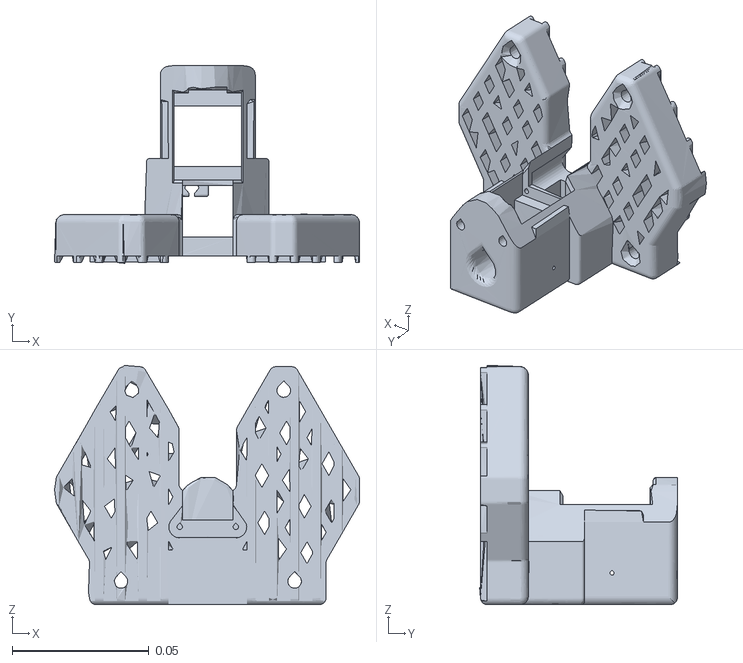
[picture p139: CAD file, 2026-10-11]
web/models/so101/assets/base_so101_v2.stl
0.112 x 0.0723 x 0.0875
