JacobFV/labrat/apps/console/models/so101/assets/motor_holder_so101_base_v1.stl

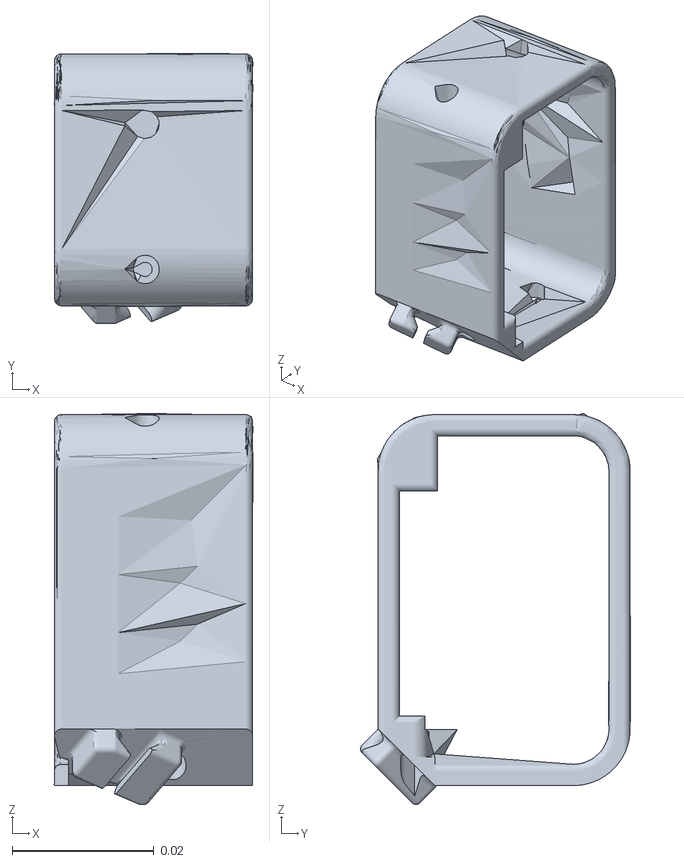
[picture p140: CAD file, 2026-10-15]
apps/console/models/so101/assets/motor_holder_so101_base_v1.stl
0.028 x 0.0382 x 0.0552
