JacobFV/labrat/cad/syringe/twin/static__print_white.stl

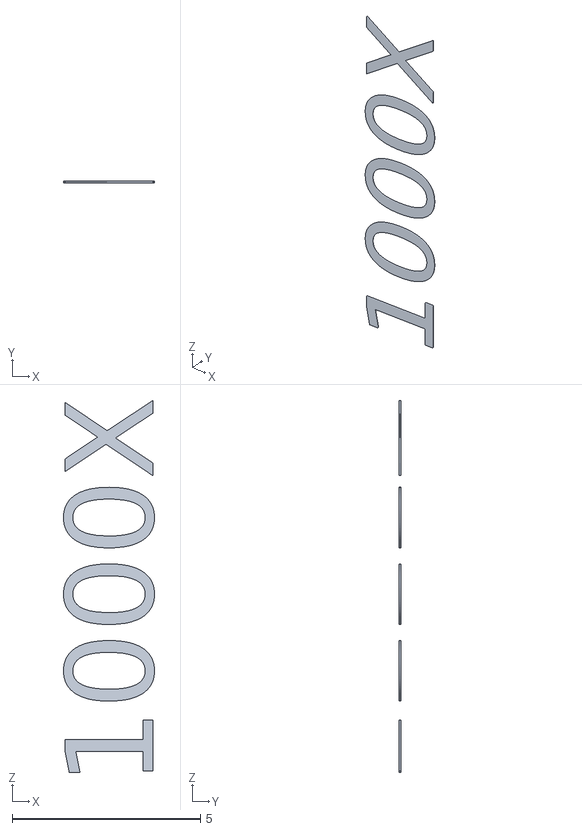
[picture p141: CAD file, 2026-10-14]
cad/syringe/twin/static__print_white.stl
2.42 x 0.04 x 9.88
