JacobFV/labrat/hardware/phone-stand/step/PS-110.step

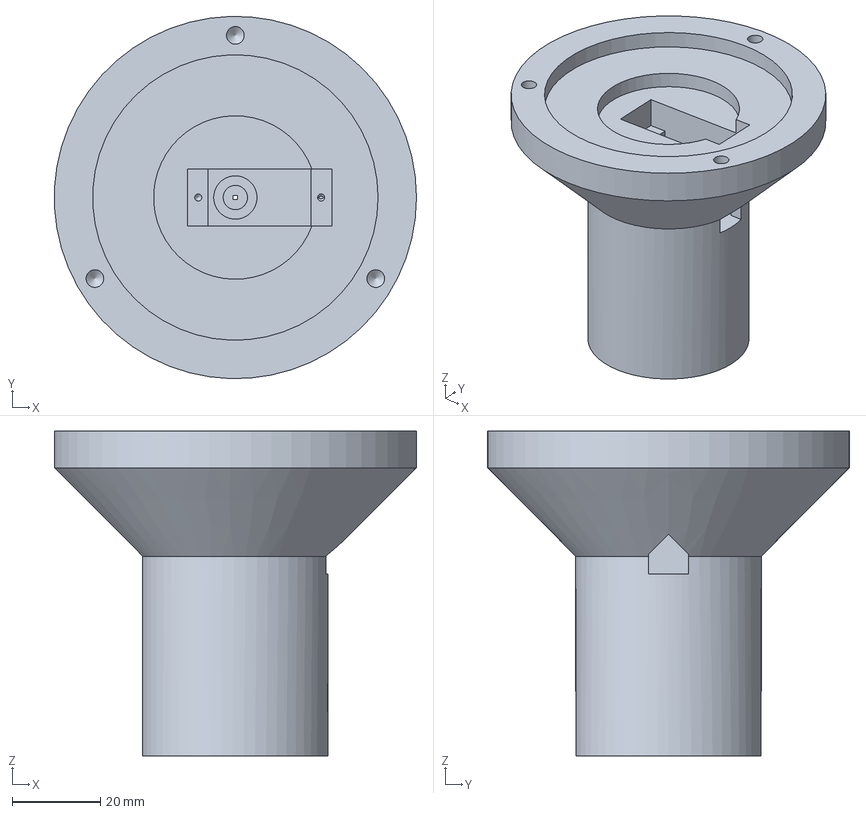
[picture p142: CAD file, 2026-10-15]
hardware/phone-stand/step/PS-110.step
81.9 x 82.0 x 73.4 mm
