JacobFV/labrat/hardware/print/plate_06_pla_so101_follower_x2.3mf

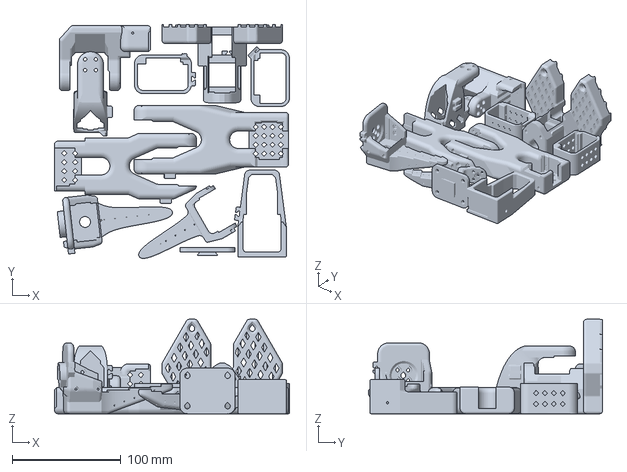
[picture p143: CAD file, 2026-10-15]
hardware/print/plate_06_pla_so101_follower_x2.3mf
216.3 x 215.3 x 87.0 mm
