JacobFV/labrat/hardware/tool-head/step/SYR-104.step

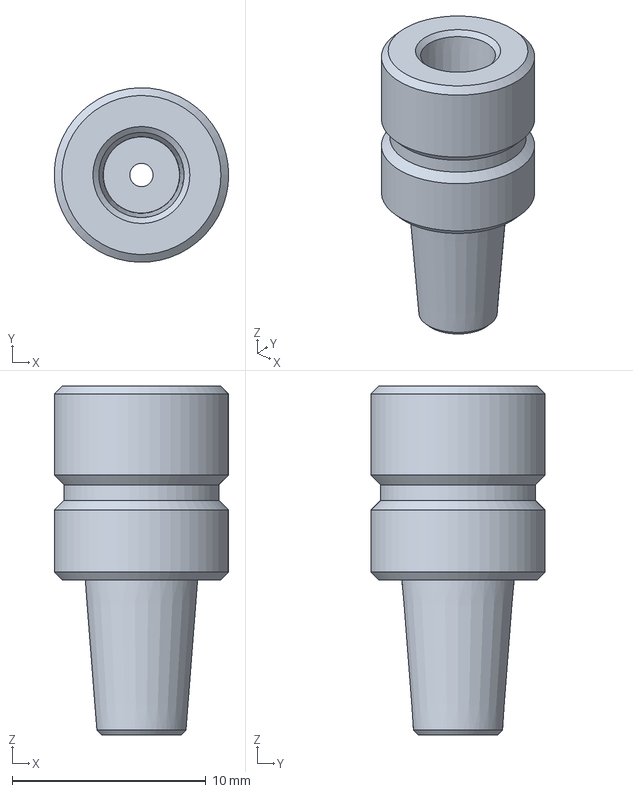
[picture p144: CAD file, 2026-10-15]
hardware/tool-head/step/SYR-104.step
8.99 x 9.00 x 18.0 mm
