JacobFV/labrat/hardware/tool-head/twin/carriage__polypropylene_white.stl

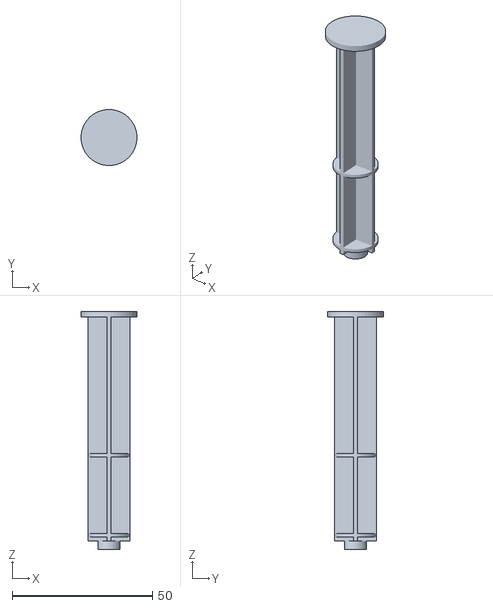
[picture p145: CAD file, 2026-10-15]
hardware/tool-head/twin/carriage__polypropylene_white.stl
20.0 x 20.0 x 85.0
