JacobFV/labrat/tappet/hardware/cad/step/tray_shim_iphone_se.step

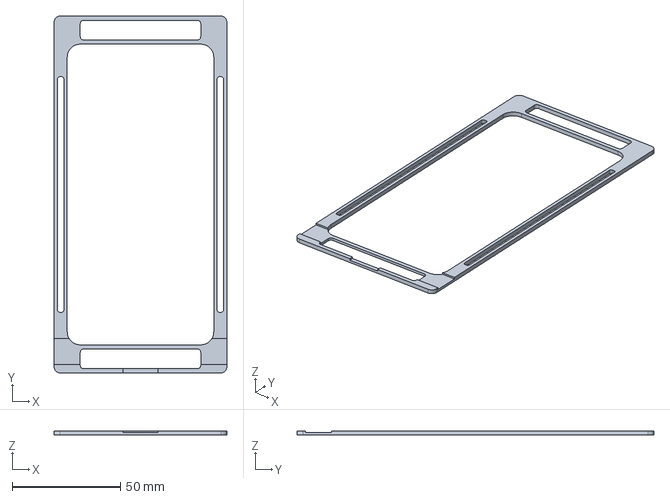
[picture p146: CAD file, 2026-10-11]
tappet/hardware/cad/step/tray_shim_iphone_se.step
79.7 x 164.7 x 2.00 mm
