JacobFV/labrat/apps/console/models/so101/assets/wrist_roll_follower_so101_v1.stl

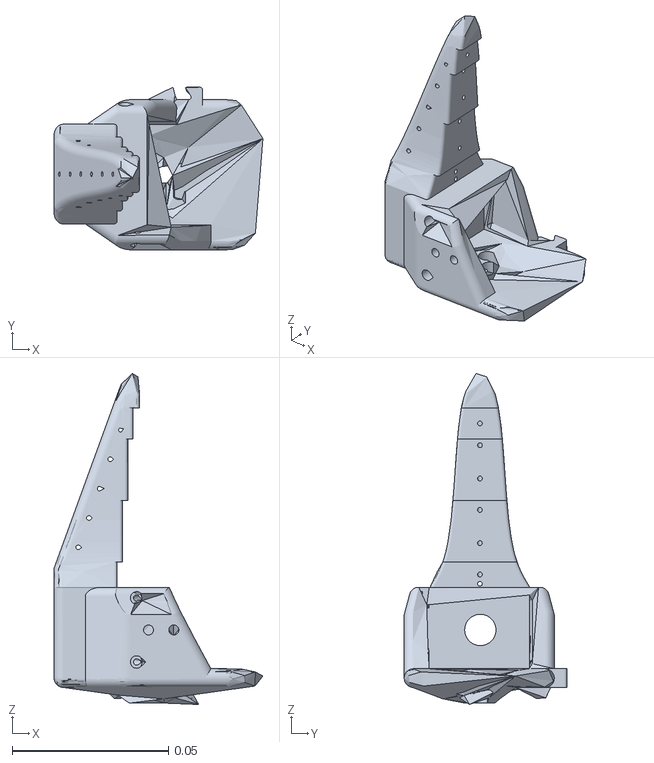
[picture p147: CAD file, 2026-10-15]
apps/console/models/so101/assets/wrist_roll_follower_so101_v1.stl
0.0668 x 0.052 x 0.106
