JacobFV/labrat/cad/syringe/twin/static__pilot_white.stl

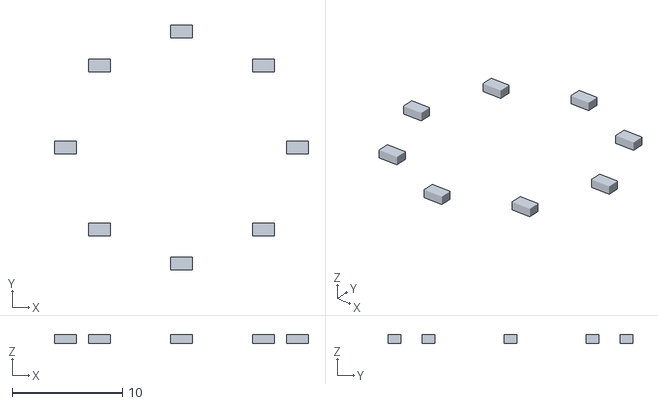
[picture p148: CAD file, 2026-10-14]
cad/syringe/twin/static__pilot_white.stl
23.0 x 22.2 x 0.8
