JacobFV/labrat/hardware/phone-stand/step/PS-111.step

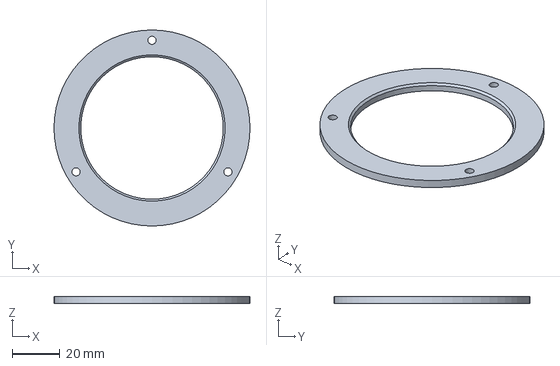
[picture p149: CAD file, 2026-10-15]
hardware/phone-stand/step/PS-111.step
82.0 x 82.0 x 3.00 mm
