JacobFV/labrat/hardware/tool-head/step/SYR-130-09p00.step

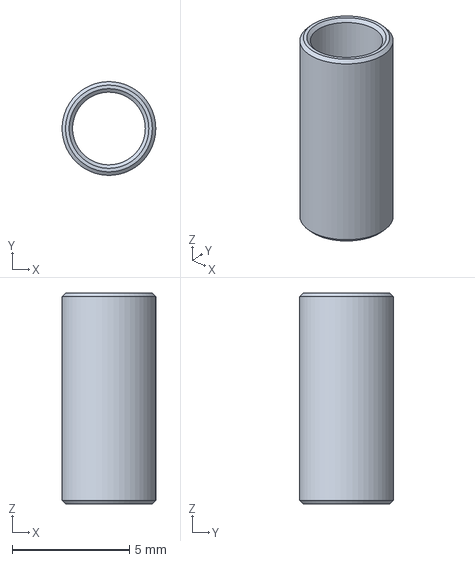
[picture p150: CAD file, 2026-10-15]
hardware/tool-head/step/SYR-130-09p00.step
4.00 x 4.00 x 9.00 mm
