JacobFV/labrat/tappet/hardware/cad/step/forearm.step

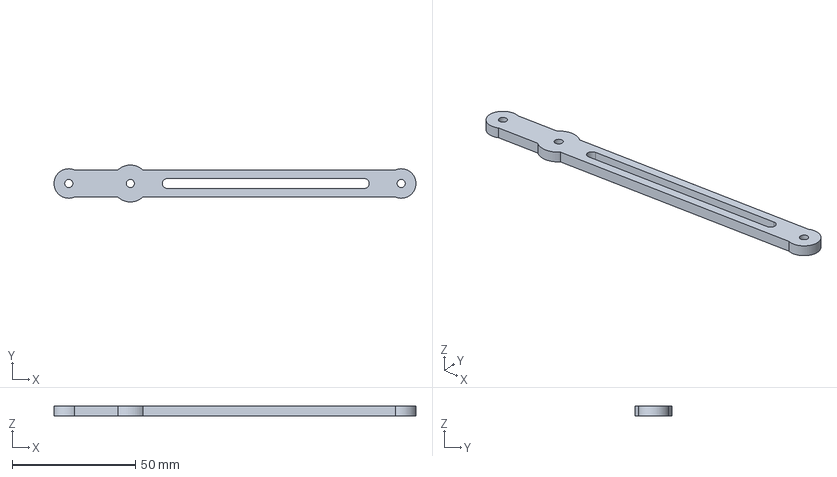
[picture p151: CAD file, 2026-10-11]
tappet/hardware/cad/step/forearm.step
147.0 x 15.0 x 4.00 mm
