JacobFV/labrat/cad/syringe/twin/static__petg_print.stl

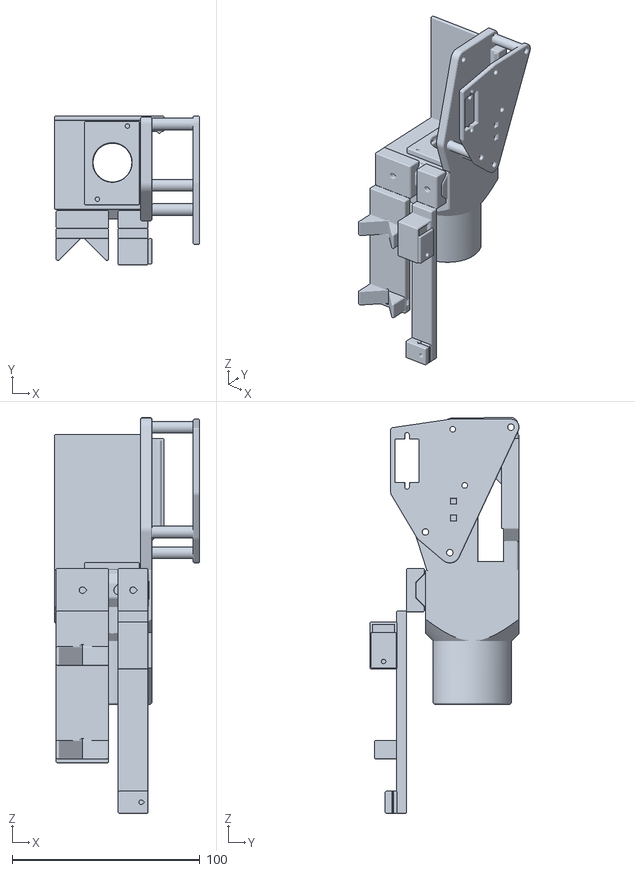
[picture p152: CAD file, 2026-10-14]
cad/syringe/twin/static__petg_print.stl
77.5 x 79.5 x 211.1
