JacobFV/labrat/hardware/phone-stand/step/PS-133.step

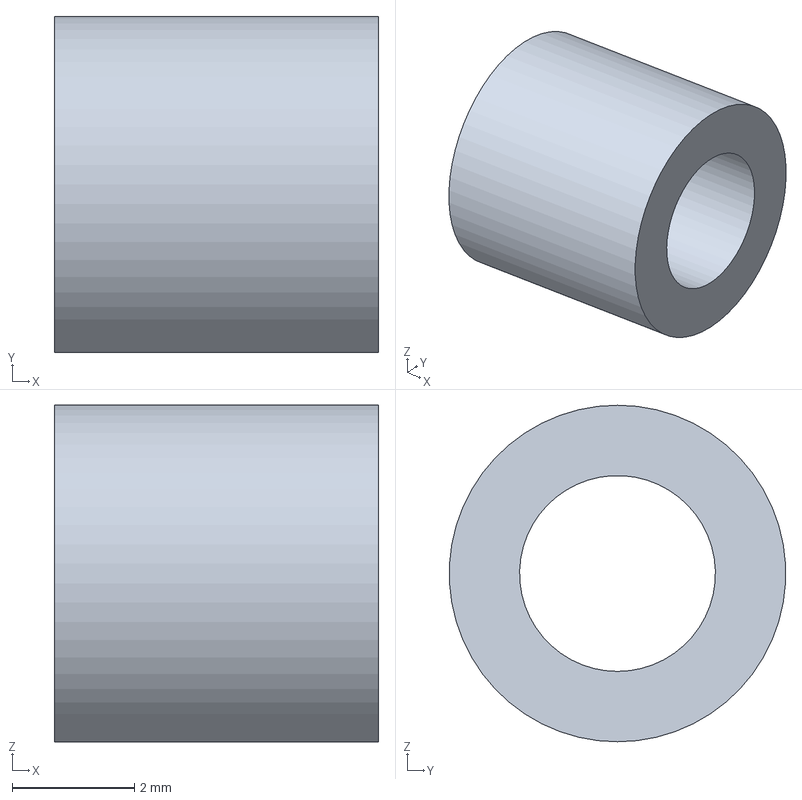
[picture p153: CAD file, 2026-10-15]
hardware/phone-stand/step/PS-133.step
5.30 x 5.49 x 5.50 mm
