JacobFV/labrat/hardware/tool-head/step/SYR-130-04p00.step

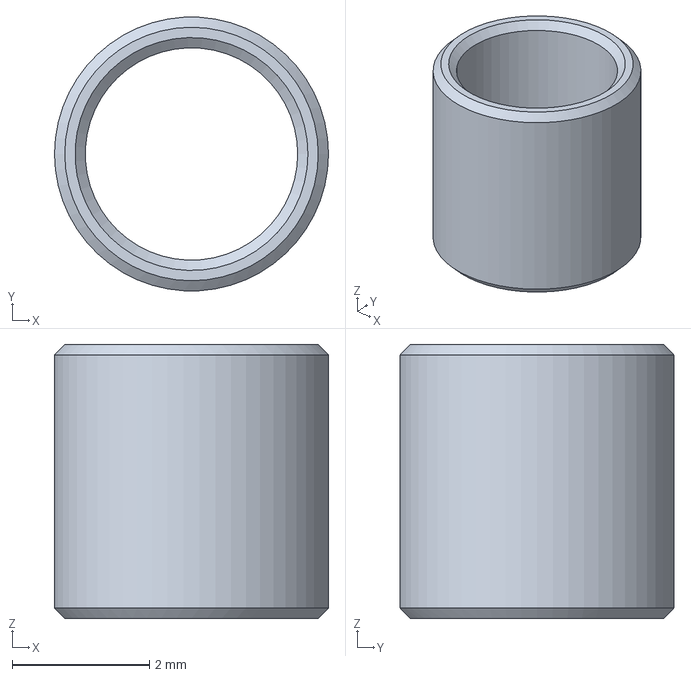
[picture p154: CAD file, 2026-10-15]
hardware/tool-head/step/SYR-130-04p00.step
4.00 x 3.99 x 4.00 mm
