JacobFV/labrat/hardware/tool-head/twin/static__polypropylene_natural.stl

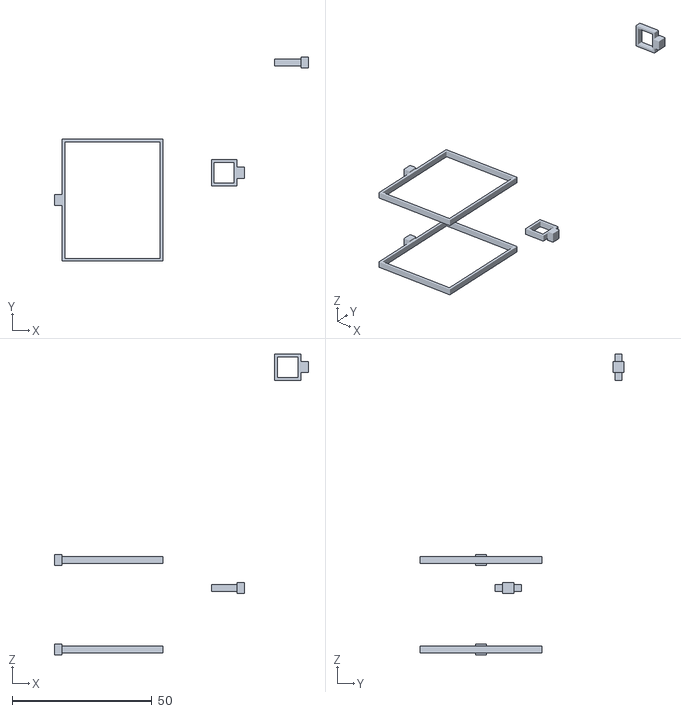
[picture p155: CAD file, 2026-10-15]
hardware/tool-head/twin/static__polypropylene_natural.stl
91.0 x 73.1 x 107.7
