JacobFV/labrat/tappet/hardware/cad/step/column_head.step

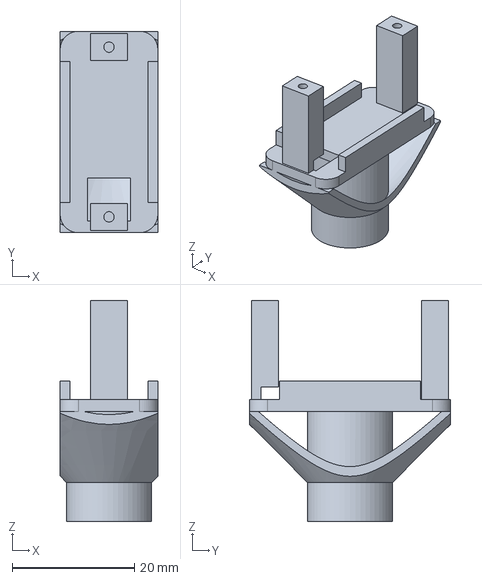
[picture p156: CAD file, 2026-10-11]
tappet/hardware/cad/step/column_head.step
16.0 x 33.0 x 36.2 mm
