JacobFV/labrat/cad/syringe/twin/static__syr_pcb_red.stl

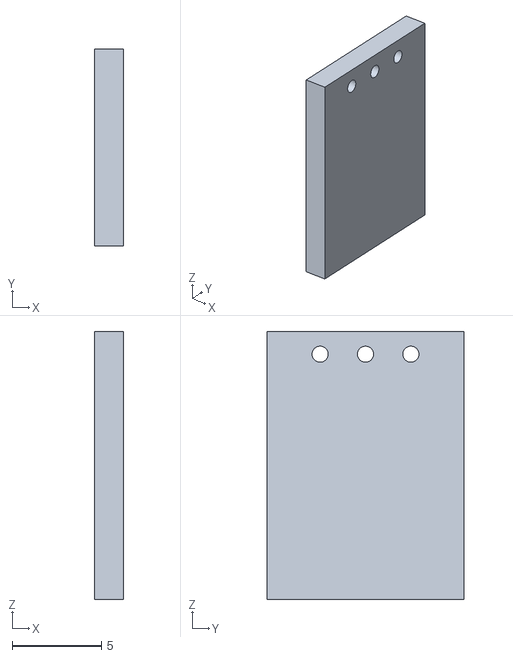
[picture p157: CAD file, 2026-10-14]
cad/syringe/twin/static__syr_pcb_red.stl
1.60 x 11.0 x 15.0
