JacobFV/labrat/hardware/phone-stand/step/PS-132.step

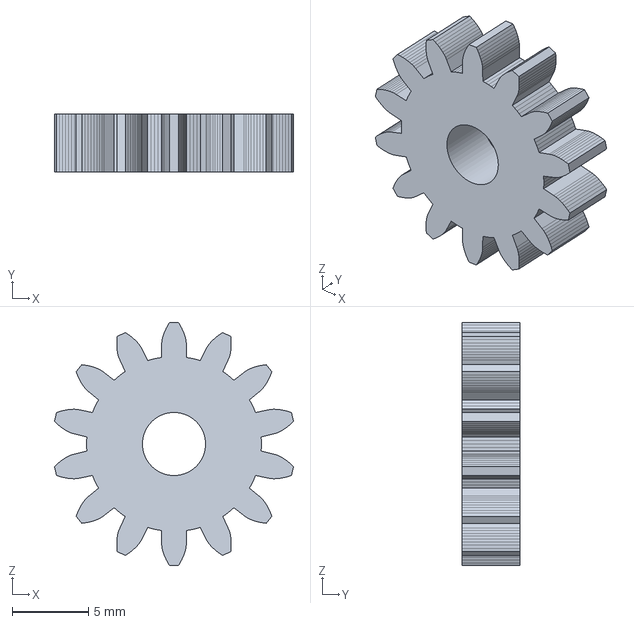
[picture p158: CAD file, 2026-10-15]
hardware/phone-stand/step/PS-132.step
15.7 x 3.80 x 16.0 mm
