JacobFV/labrat/hardware/tool-head/step/SYR-103.step

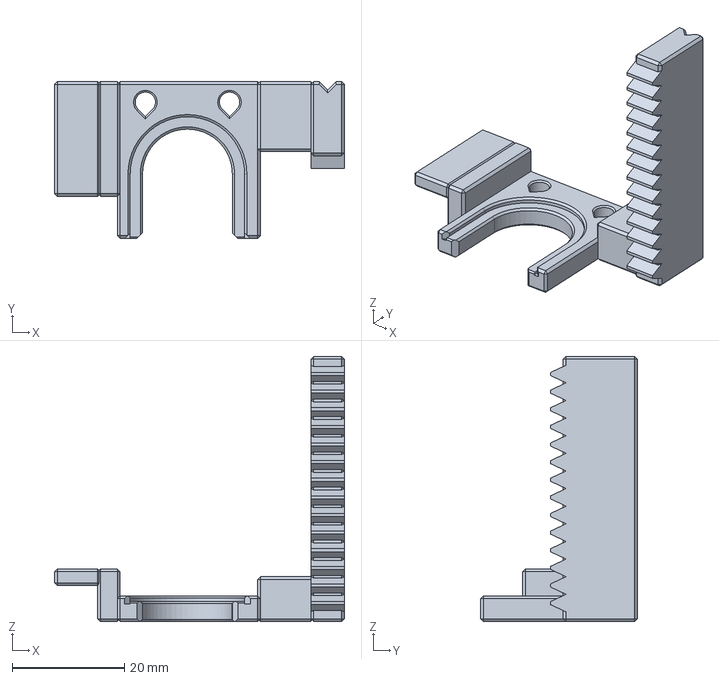
[picture p159: CAD file, 2026-10-15]
hardware/tool-head/step/SYR-103.step
51.7 x 28.0 x 47.3 mm
