JacobFV/labrat/tappet/hardware/cad/step/neck_tilt_bracket.step

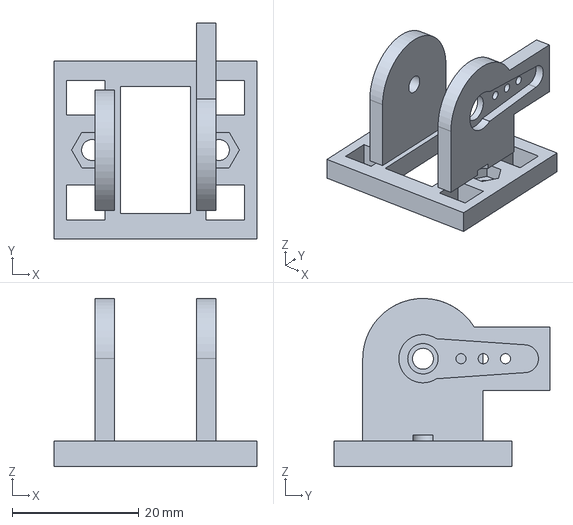
[picture p160: CAD file, 2026-10-11]
tappet/hardware/cad/step/neck_tilt_bracket.step
32.0 x 34.0 x 26.5 mm
