JacobFV/labrat/cad/syringe/twin/static__syr_cable_orange.stl

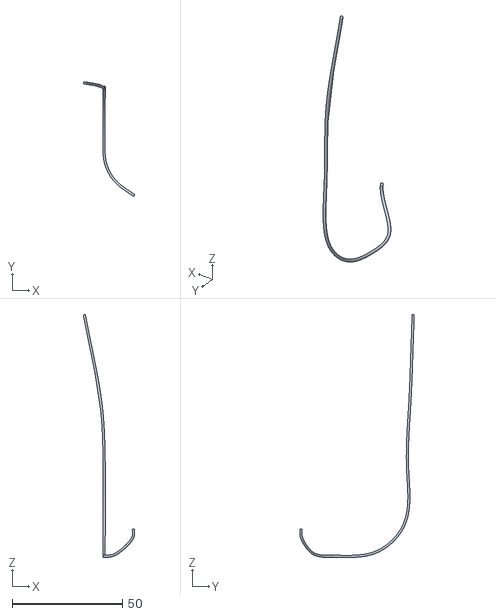
[picture p161: CAD file, 2026-10-14]
cad/syringe/twin/static__syr_cable_orange.stl
23.3 x 51.9 x 110.2
