JacobFV/labrat/hardware/tool-head/twin/gear_c__steel_hardened_ground.stl

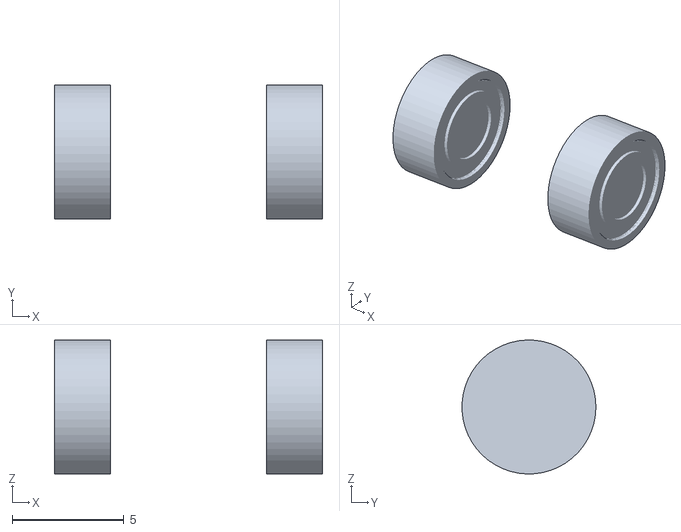
[picture p162: CAD file, 2026-10-15]
hardware/tool-head/twin/gear_c__steel_hardened_ground.stl
12.0 x 5.99 x 6.00
