JacobFV/labrat/cad/syringe/twin/static__polypropylene_natural.stl

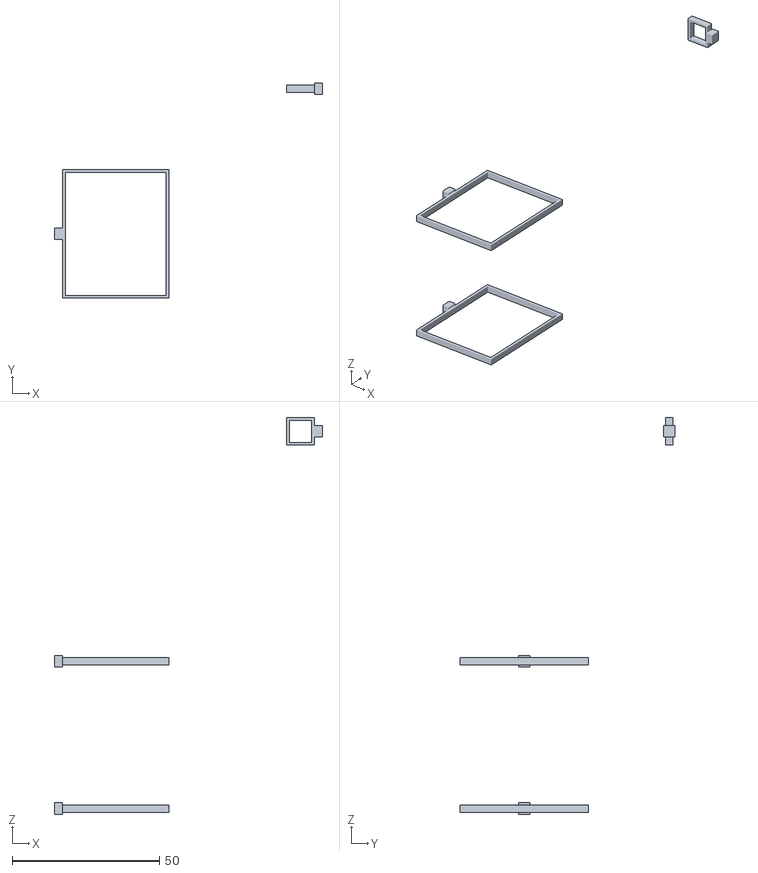
[picture p163: CAD file, 2026-10-14]
cad/syringe/twin/static__polypropylene_natural.stl
91.0 x 73.1 x 134.7
