JacobFV/labrat/hardware/tool-head/step/TM-110.step

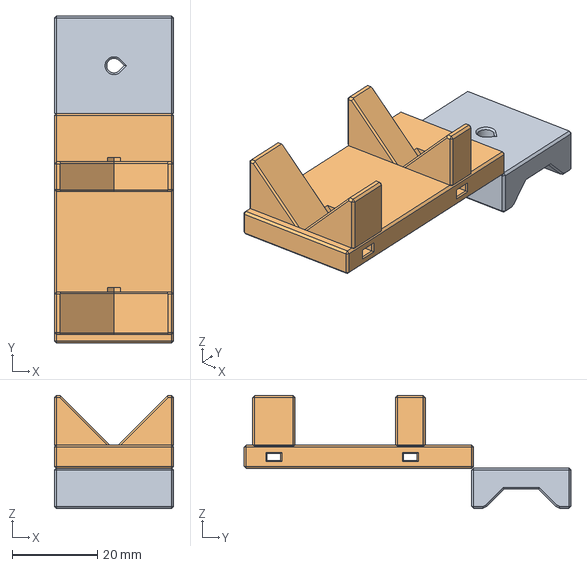
[picture p164: CAD file, 2026-10-15]
hardware/tool-head/step/TM-110.step
28.0 x 76.7 x 26.5 mm
