JacobFV/labrat/tappet/hardware/cad/step/cable_clip.step

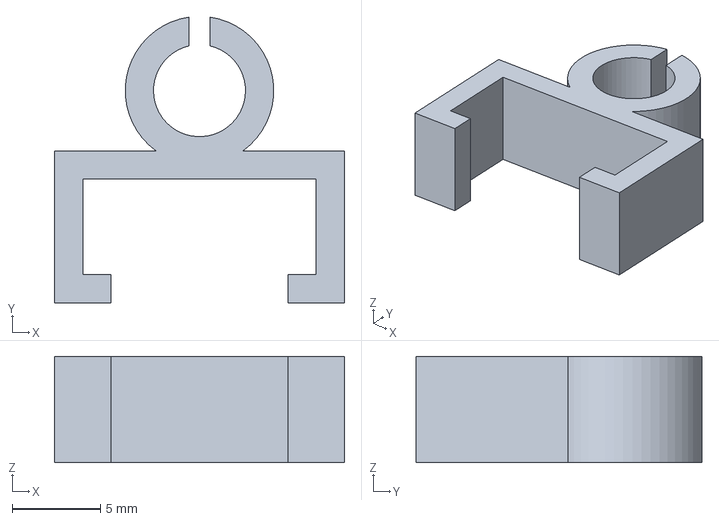
[picture p165: CAD file, 2026-10-11]
tappet/hardware/cad/step/cable_clip.step
16.4 x 16.2 x 6.00 mm
