JacobFV/labrat/hardware/tool-head/step/TM-122.step

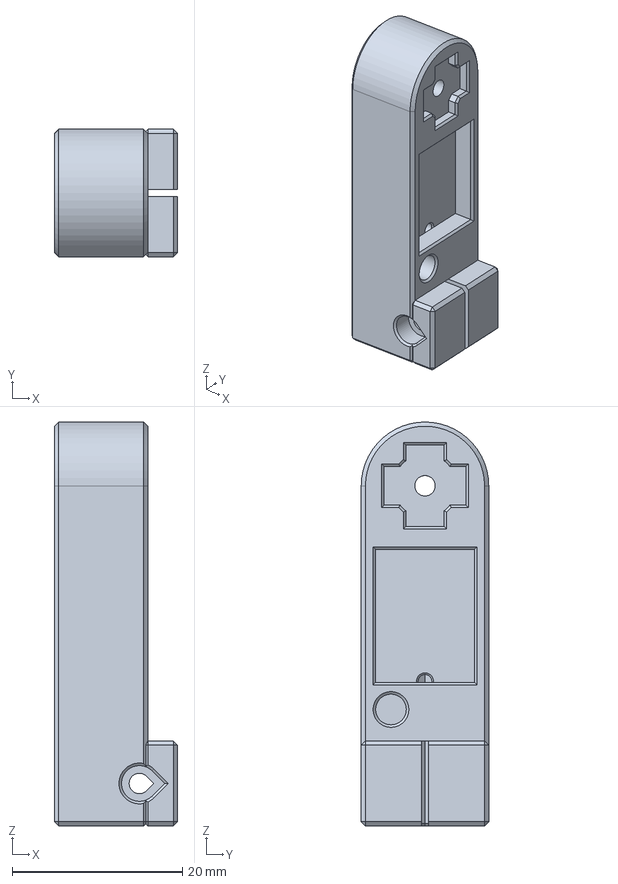
[picture p166: CAD file, 2026-10-15]
hardware/tool-head/step/TM-122.step
14.5 x 15.0 x 47.5 mm
