JacobFV/labrat/hardware/tool-head/twin/probe__syr_petg_orange__probe_arm.stl

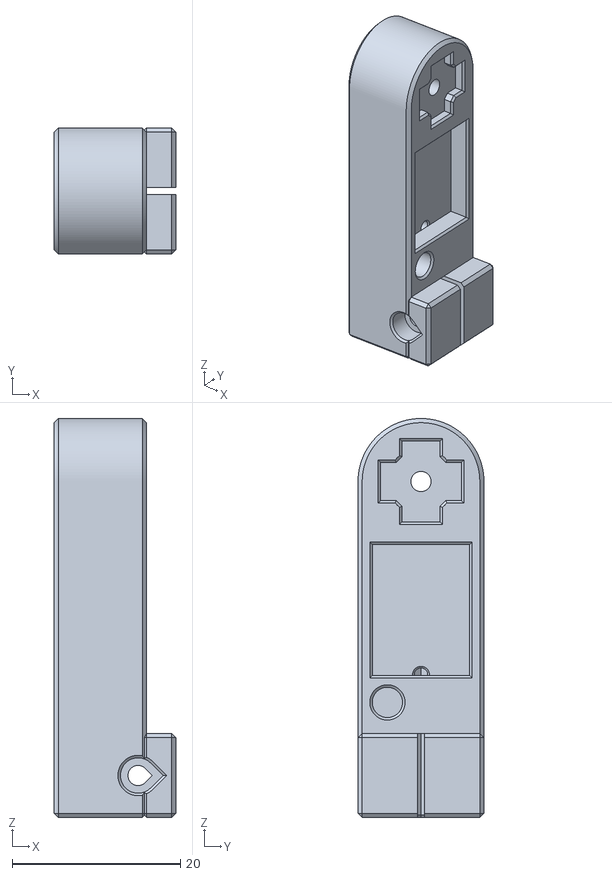
[picture p167: CAD file, 2026-10-15]
hardware/tool-head/twin/probe__syr_petg_orange__probe_arm.stl
14.5 x 15.0 x 47.5
