JacobFV/labrat/tappet/hardware/cad/step/yaw_gear_servo.step

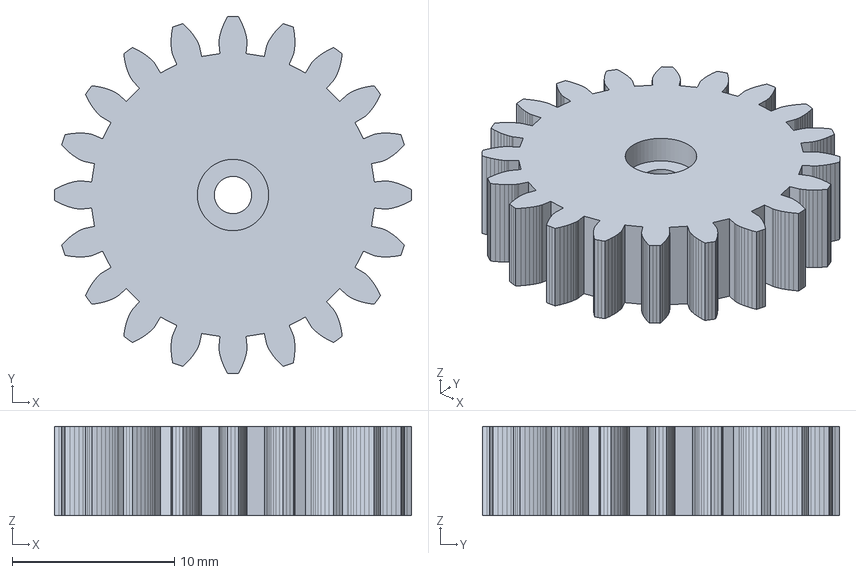
[picture p168: CAD file, 2026-10-11]
tappet/hardware/cad/step/yaw_gear_servo.step
22.0 x 22.0 x 5.50 mm
