JacobFV/labrat/cad/syringe/twin/static__syr_cable_brown.stl

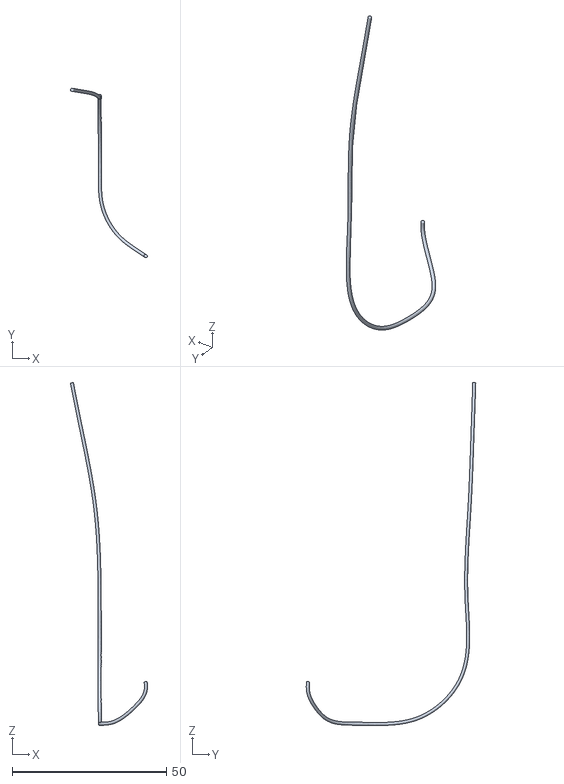
[picture p169: CAD file, 2026-10-14]
cad/syringe/twin/static__syr_cable_brown.stl
25.0 x 54.9 x 111.1
