JacobFV/labrat/hardware/tool-head/step/TM-121.step

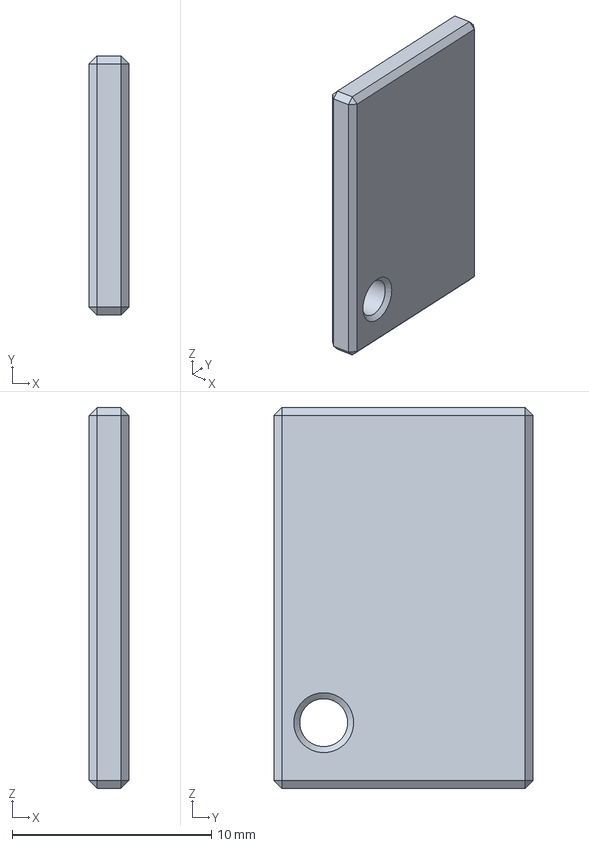
[picture p170: CAD file, 2026-10-15]
hardware/tool-head/step/TM-121.step
2.00 x 13.0 x 19.1 mm
