JacobFV/labrat/hardware/tool-head/twin/gear_a__syr_petg_white__gear_a.stl

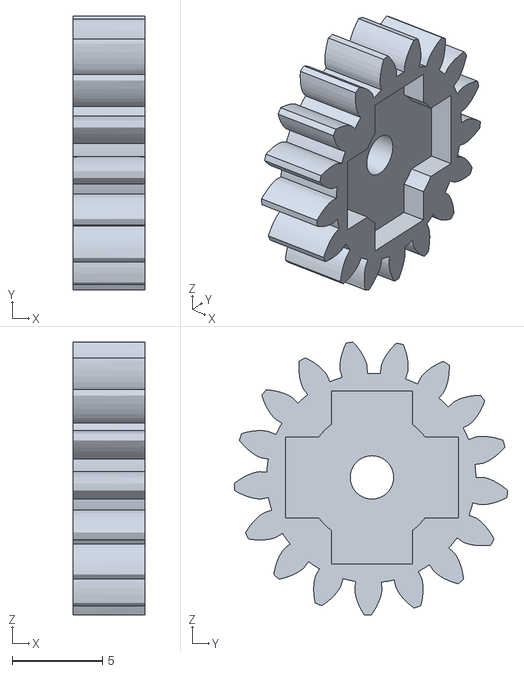
[picture p171: CAD file, 2026-10-15]
hardware/tool-head/twin/gear_a__syr_petg_white__gear_a.stl
4.00 x 15.2 x 15.1
