JacobFV/labrat/cad/syringe/twin/static__cable_pvc_black.stl

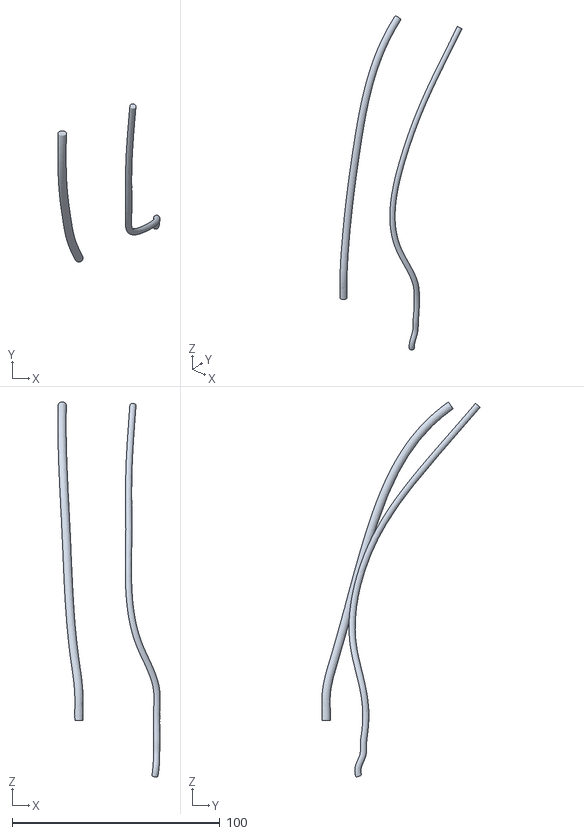
[picture p172: CAD file, 2026-10-14]
cad/syringe/twin/static__cable_pvc_black.stl
49.3 x 76.2 x 180.6
