JacobFV/labrat/hardware/tool-head/step/SYR-101.step

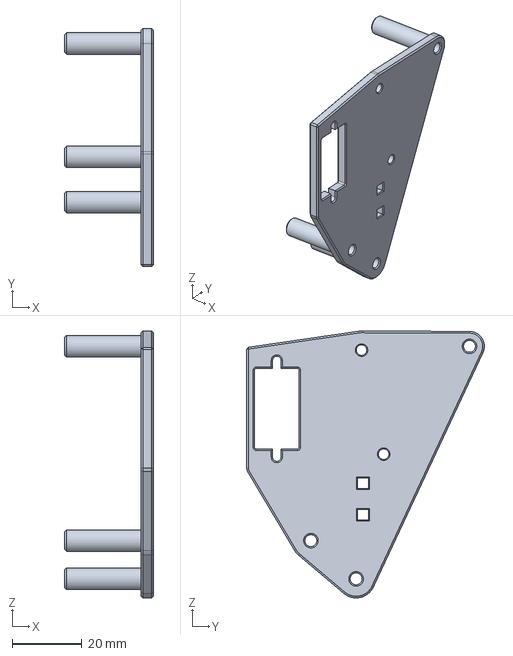
[picture p173: CAD file, 2026-10-15]
hardware/tool-head/step/SYR-101.step
25.5 x 68.4 x 76.8 mm
