JacobFV/labrat/tappet/hardware/cad/step/tray_shim_iphone_61.step

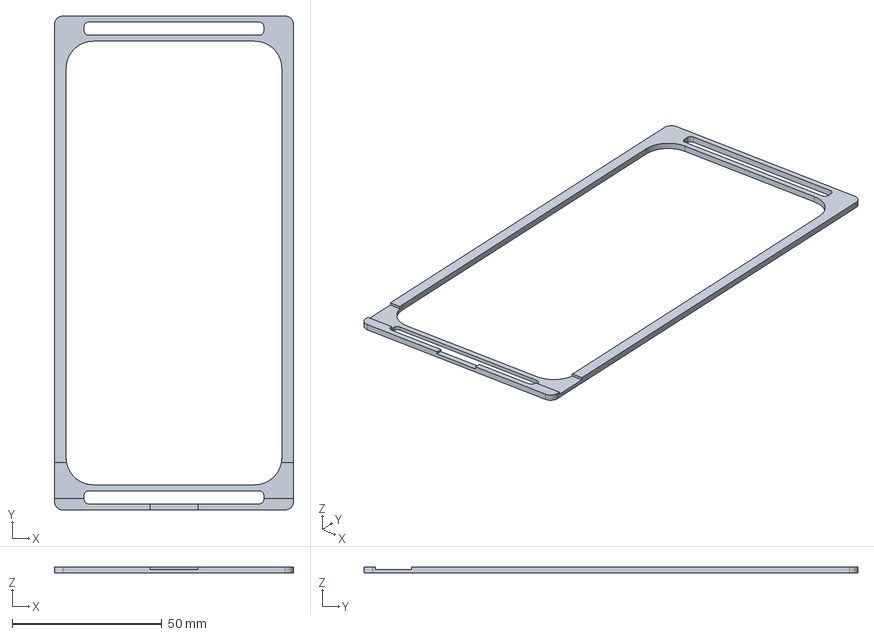
[picture p174: CAD file, 2026-10-11]
tappet/hardware/cad/step/tray_shim_iphone_61.step
79.7 x 164.7 x 2.00 mm
