JacobFV/labrat/cad/syringe/twin/carriage__syr_petg_orange.stl

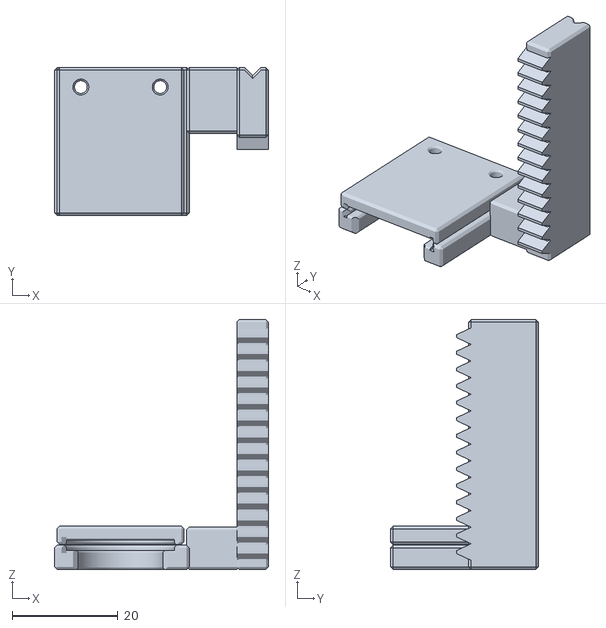
[picture p175: CAD file, 2026-10-14]
cad/syringe/twin/carriage__syr_petg_orange.stl
40.5 x 28.0 x 47.3
