JacobFV/labrat/hardware/tool-head/step/SYR-311.step

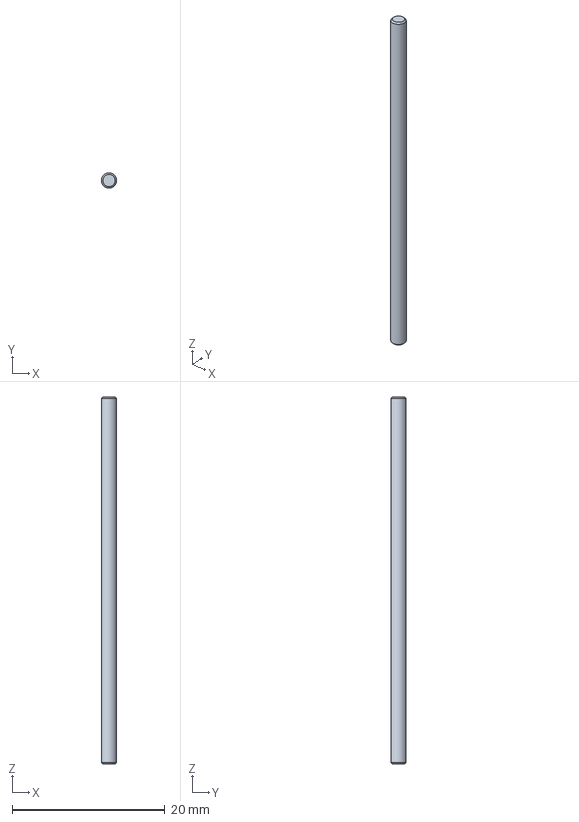
[picture p176: CAD file, 2026-10-15]
hardware/tool-head/step/SYR-311.step
2.00 x 2.00 x 48.0 mm
