JacobFV/labrat/cad/syringe/twin/static__label_vinyl.stl

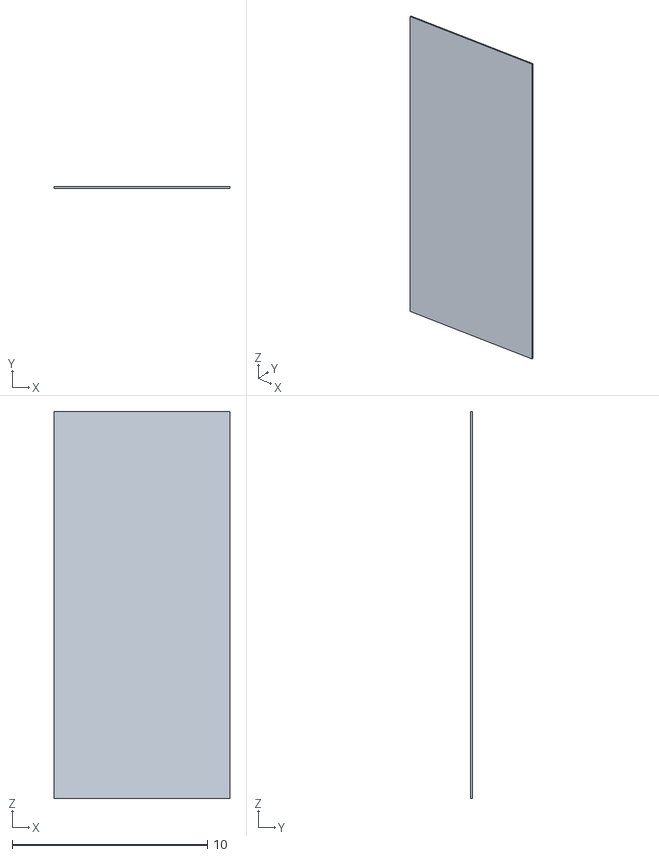
[picture p177: CAD file, 2026-10-14]
cad/syringe/twin/static__label_vinyl.stl
9.00 x 0.08 x 19.8
