JacobFV/labrat/hardware/tool-head/step/SYR-111.step

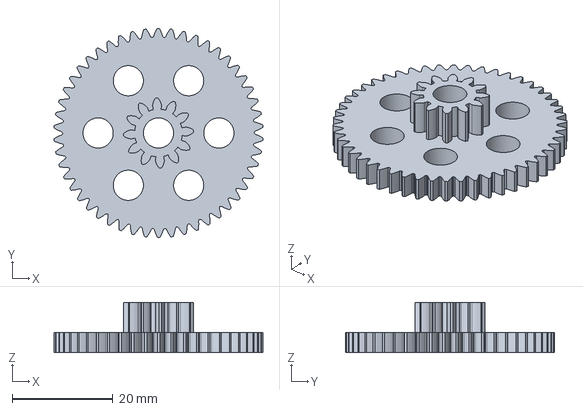
[picture p178: CAD file, 2026-10-15]
hardware/tool-head/step/SYR-111.step
41.6 x 41.6 x 10.0 mm
