JacobFV/labrat/hardware/tool-head/twin/static__syr_pp_clear.stl

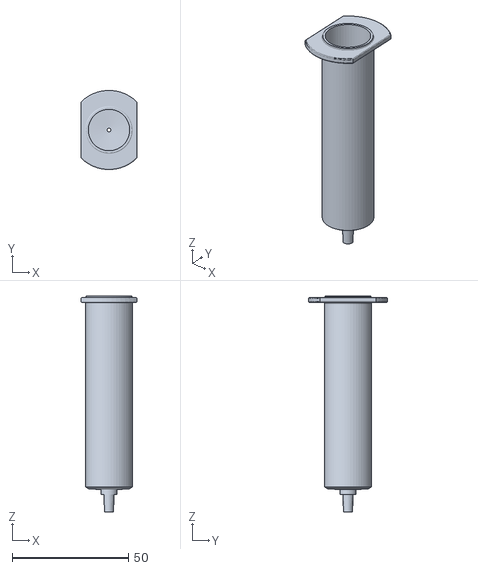
[picture p179: CAD file, 2026-10-15]
hardware/tool-head/twin/static__syr_pp_clear.stl
24.0 x 33.9 x 92.8
