JacobFV/labrat/cad/syringe/twin/static__brass_c360.stl

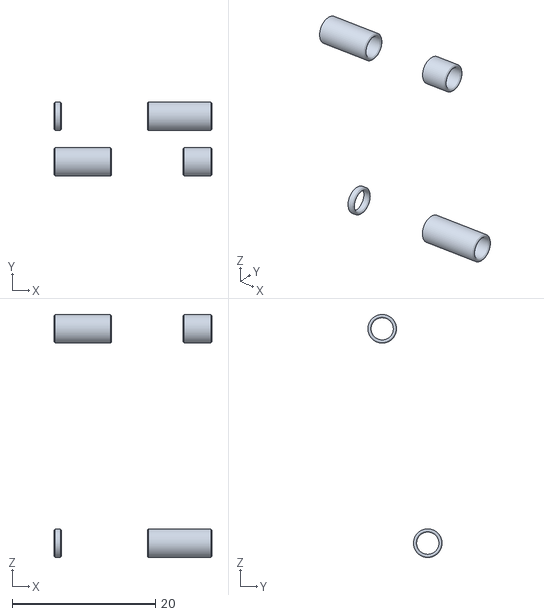
[picture p180: CAD file, 2026-10-14]
cad/syringe/twin/static__brass_c360.stl
22.0 x 10.4 x 33.9
