JacobFV/labrat/hardware/tool-head/step/SYR-102.step

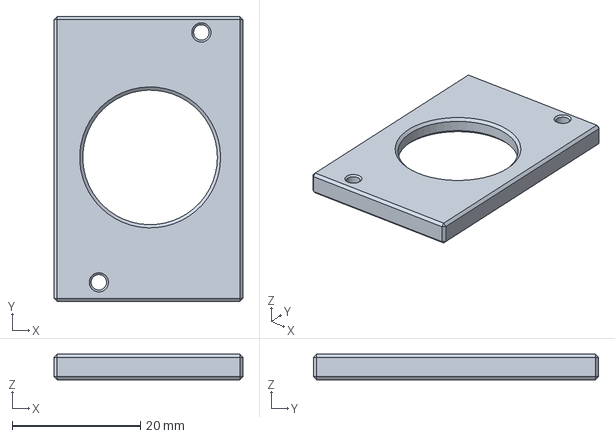
[picture p181: CAD file, 2026-10-15]
hardware/tool-head/step/SYR-102.step
29.5 x 44.5 x 4.00 mm
