JacobFV/labrat/hardware/tool-head/twin/static__brass_c360.stl

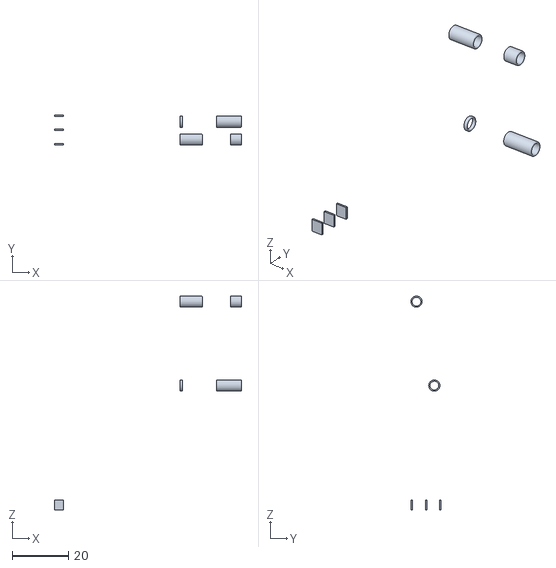
[picture p182: CAD file, 2026-10-15]
hardware/tool-head/twin/static__brass_c360.stl
66.7 x 10.8 x 76.2
