JacobFV/labrat/cad/syringe/twin/carriage__epdm_rubber.stl

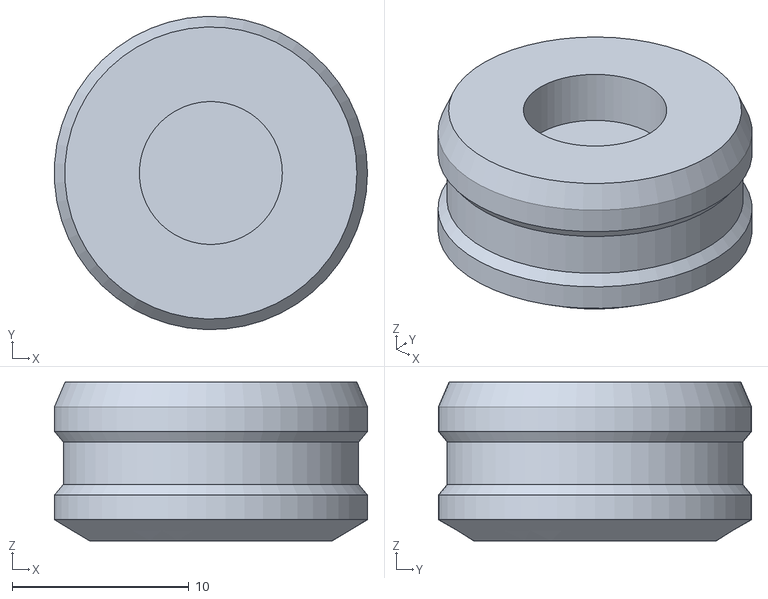
[picture p183: CAD file, 2026-10-14]
cad/syringe/twin/carriage__epdm_rubber.stl
17.7 x 17.7 x 9.00
