JacobFV/labrat/cad/syringe/step/SYR-130-03p00.step

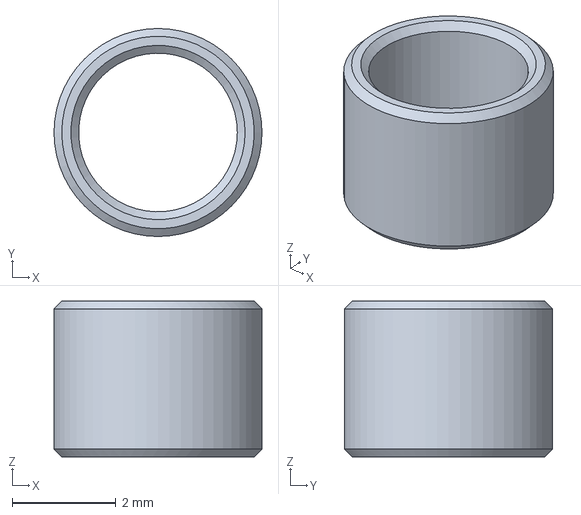
[picture p184: CAD file, 2026-10-14]
cad/syringe/step/SYR-130-03p00.step
4.00 x 4.00 x 3.00 mm
