JacobFV/labrat/cad/syringe/twin/static__print_black.stl

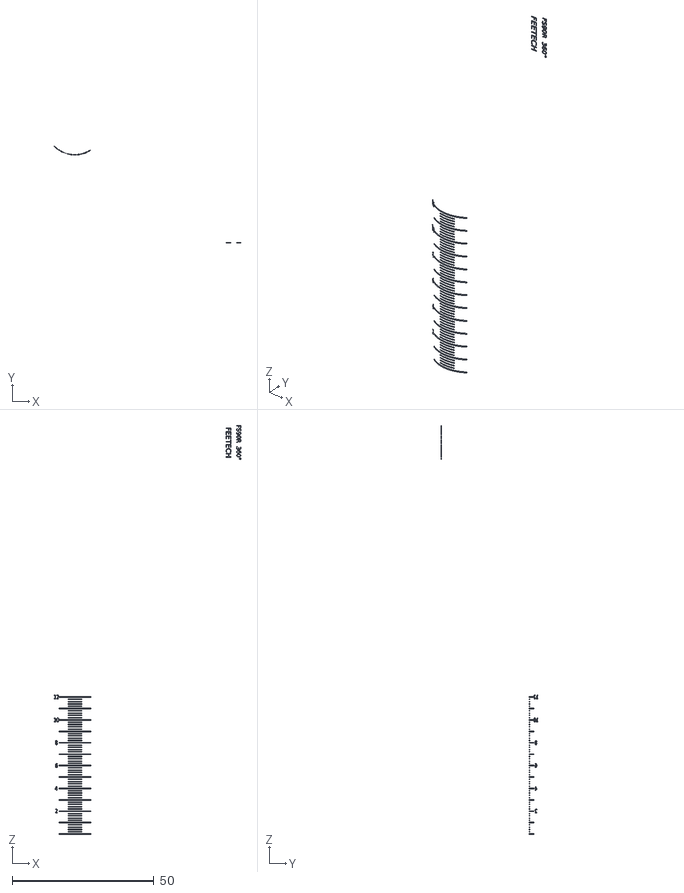
[picture p185: CAD file, 2026-10-14]
cad/syringe/twin/static__print_black.stl
65.8 x 34.1 x 144.0
