JacobFV/labrat/hardware/tool-head/twin/static__abs_black.stl

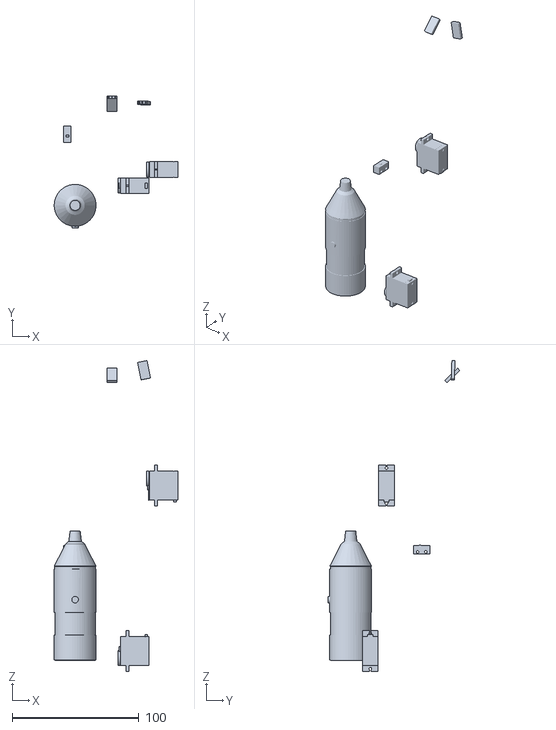
[picture p186: CAD file, 2026-10-15]
hardware/tool-head/twin/static__abs_black.stl
97.4 x 103.9 x 245.1
