JacobFV/labrat/cad/syringe/step/SYR-130-09p80.step

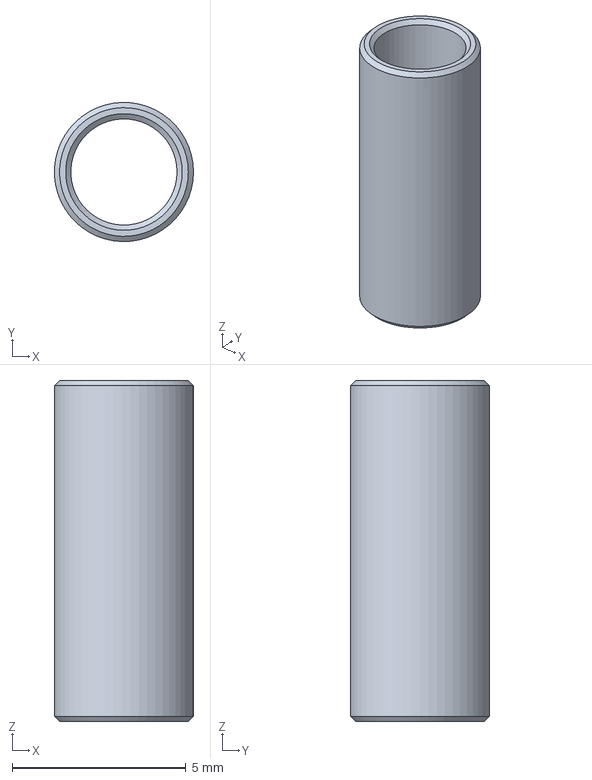
[picture p187: CAD file, 2026-10-14]
cad/syringe/step/SYR-130-09p80.step
4.00 x 4.00 x 9.80 mm
