JacobFV/labrat/cad/syringe/twin/gear_b__steel_hardened_ground.stl

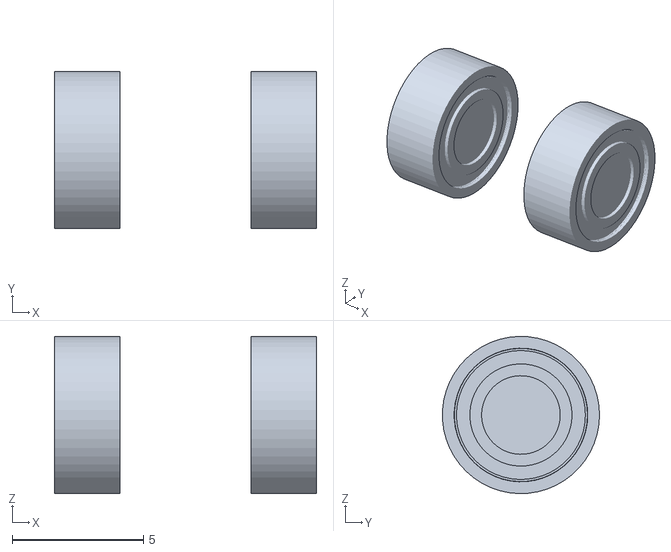
[picture p188: CAD file, 2026-10-14]
cad/syringe/twin/gear_b__steel_hardened_ground.stl
10.0 x 5.99 x 6.00
