JacobFV/labrat/hardware/tool-head/twin/probe__polypropylene_white.stl

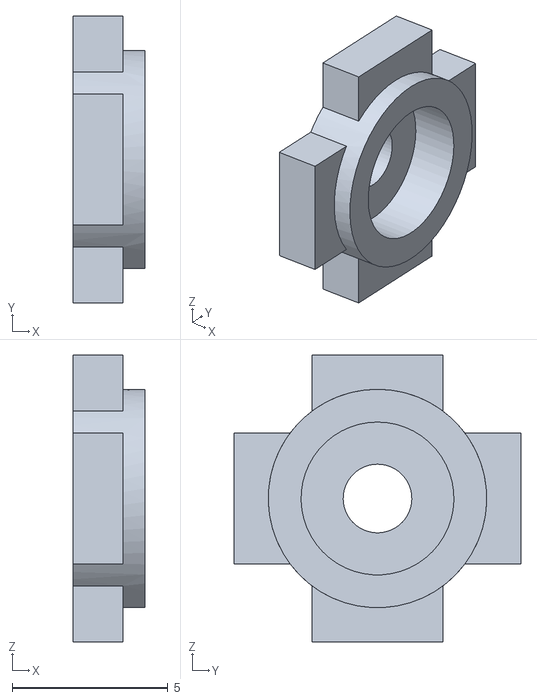
[picture p189: CAD file, 2026-10-15]
hardware/tool-head/twin/probe__polypropylene_white.stl
2.30 x 9.20 x 9.20
