JacobFV/labrat/cad/syringe/step/SYR-130-19p50.step

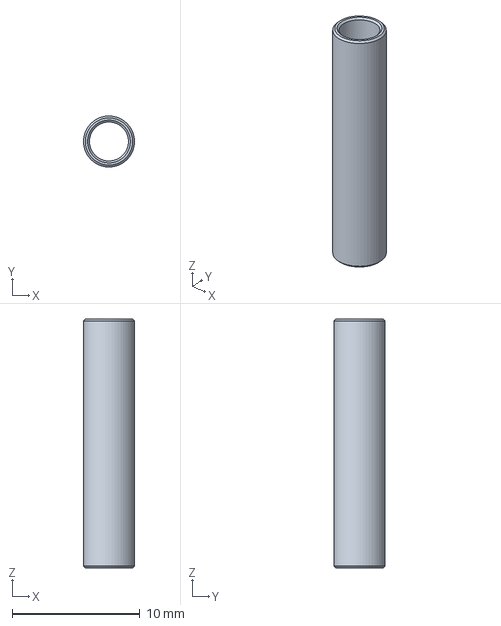
[picture p190: CAD file, 2026-10-14]
cad/syringe/step/SYR-130-19p50.step
4.00 x 4.00 x 19.5 mm
