JacobFV/labrat/cad/syringe/step/SYR-130-04p50.step

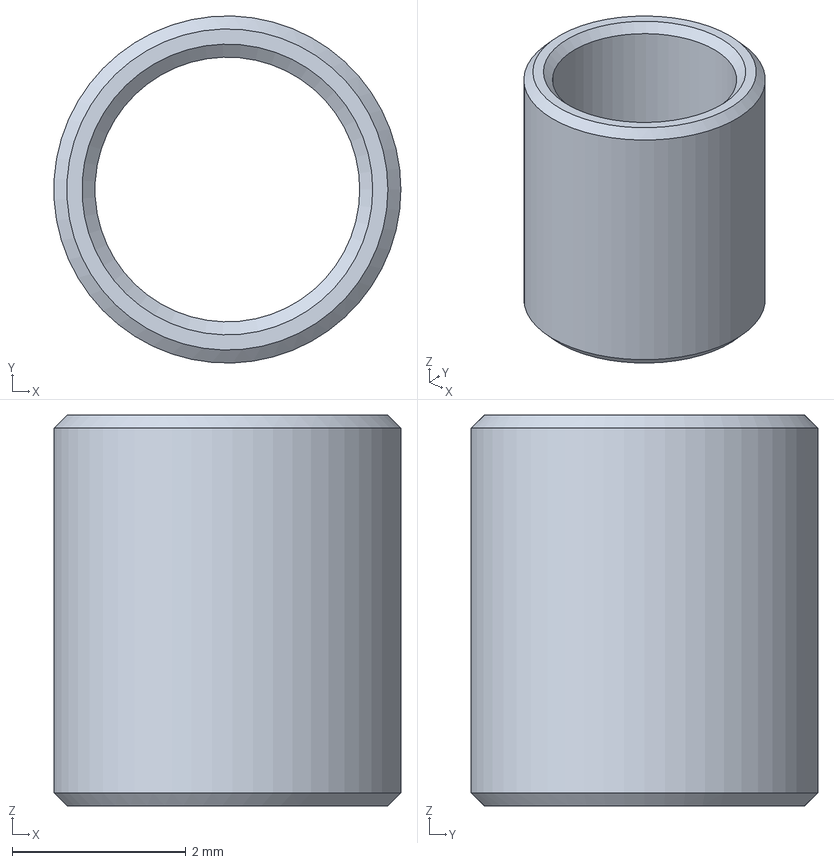
[picture p191: CAD file, 2026-10-14]
cad/syringe/step/SYR-130-04p50.step
4.00 x 4.00 x 4.50 mm
