JacobFV/labrat/cad/syringe/twin/carriage__abs_black.stl

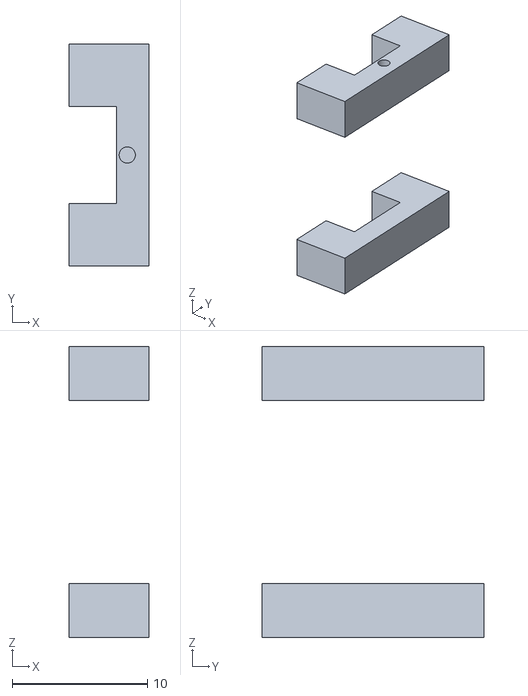
[picture p192: CAD file, 2026-10-14]
cad/syringe/twin/carriage__abs_black.stl
5.90 x 16.4 x 21.5
