JacobFV/labrat/hardware/tool-head/twin/static__syr_cable_orange.stl

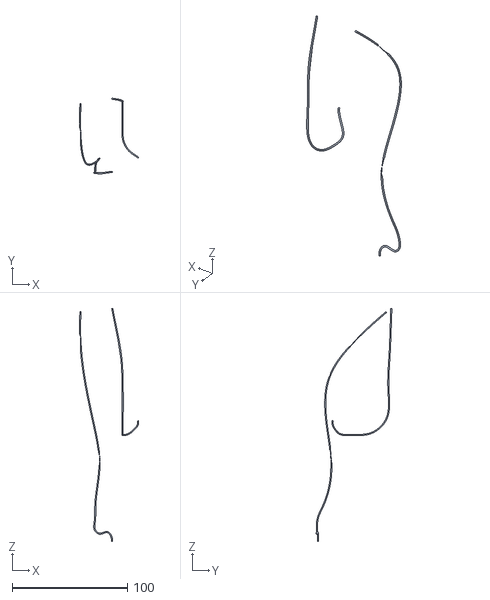
[picture p193: CAD file, 2026-10-15]
hardware/tool-head/twin/static__syr_cable_orange.stl
51.3 x 65.7 x 201.9
