JacobFV/labrat/cad/syringe/step/mount_body.step

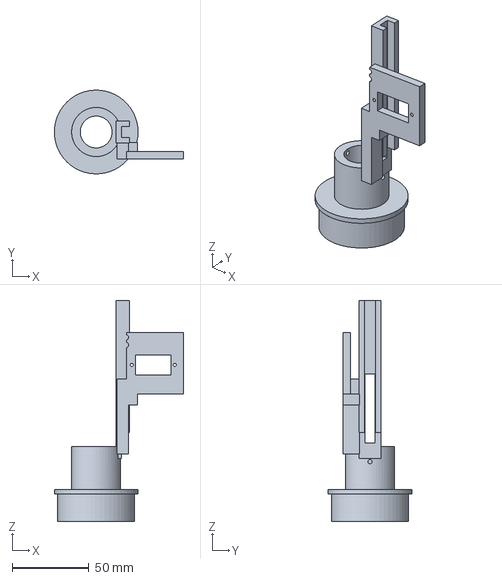
[picture p194: CAD file, 2026-10-14]
cad/syringe/step/mount_body.step
84.2 x 54.6 x 144.0 mm
