JacobFV/labrat/cad/syringe/twin/gear_c__syr_petg_white.stl

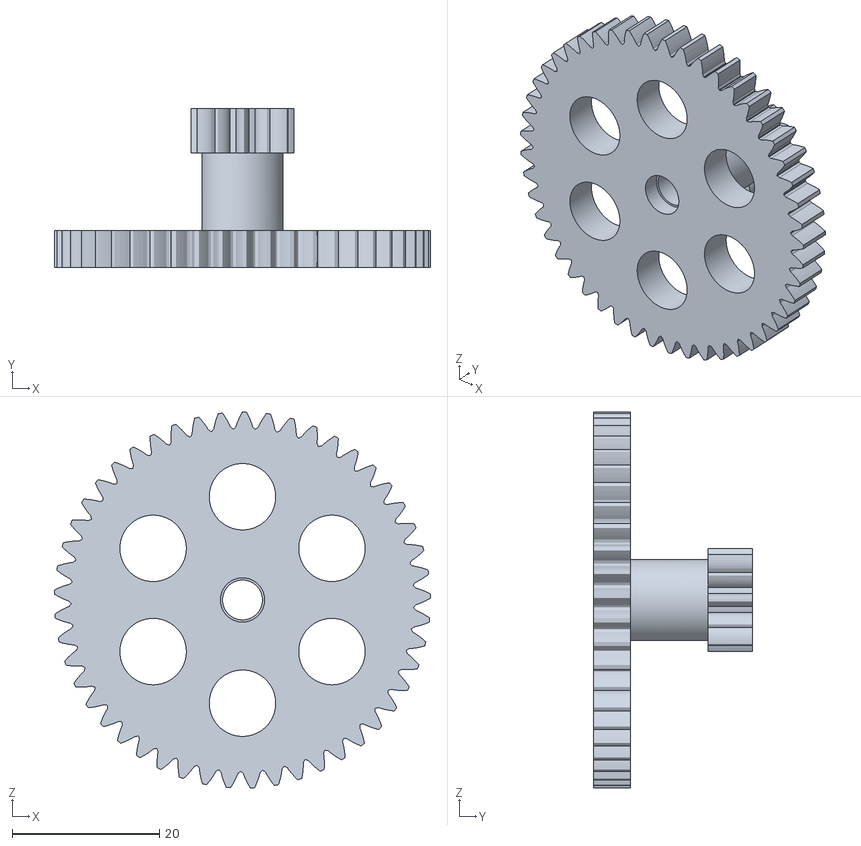
[picture p195: CAD file, 2026-10-14]
cad/syringe/twin/gear_c__syr_petg_white.stl
51.0 x 21.5 x 51.0
