JacobFV/labrat/hardware/tool-head/twin/probe__syr_cable_red.stl

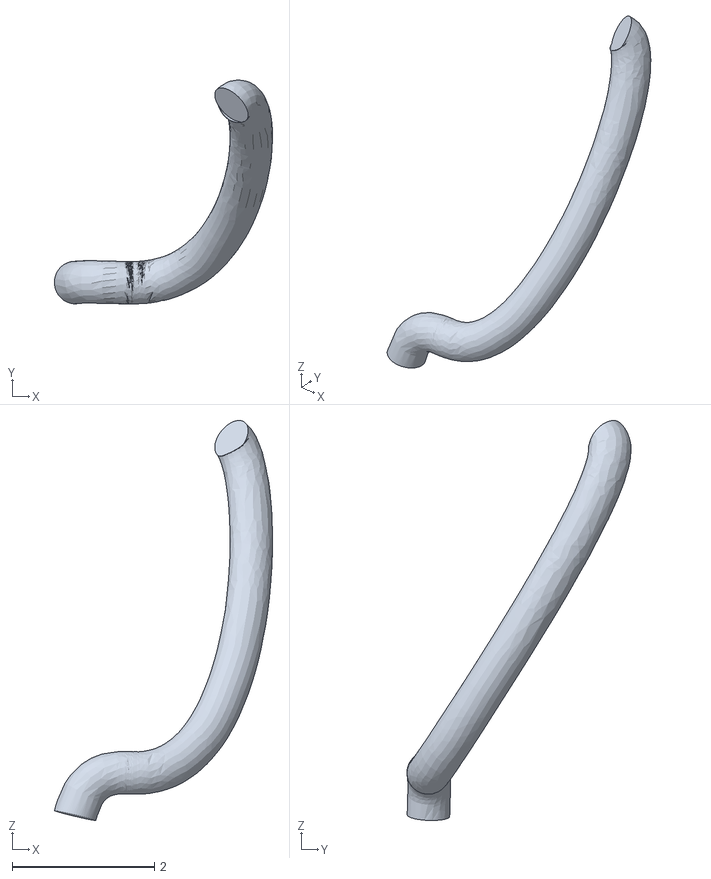
[picture p196: CAD file, 2026-10-15]
hardware/tool-head/twin/probe__syr_cable_red.stl
3.07 x 3.16 x 5.63
