JacobFV/labrat/cad/syringe/twin/gear_a__syr_petg_white.stl

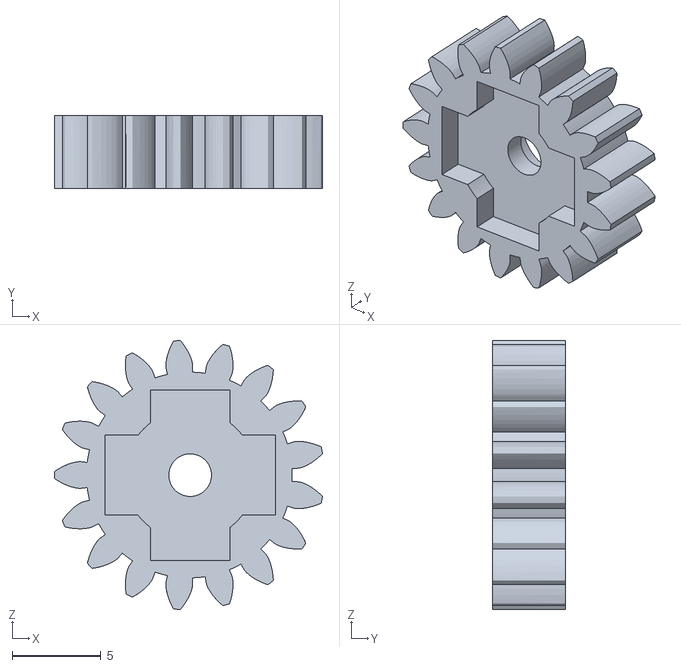
[picture p197: CAD file, 2026-10-14]
cad/syringe/twin/gear_a__syr_petg_white.stl
15.1 x 4.10 x 15.2
