JacobFV/labrat/cad/syringe/step/rack.step

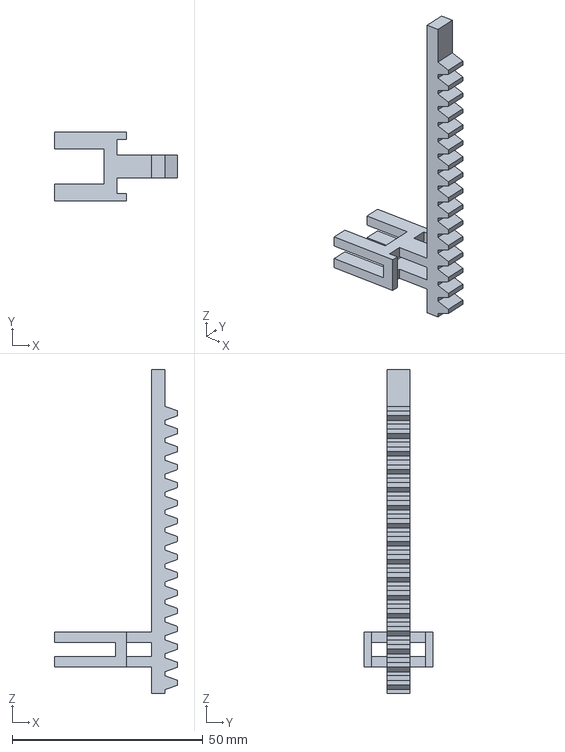
[picture p198: CAD file, 2026-10-14]
cad/syringe/step/rack.step
32.4 x 18.0 x 85.0 mm
