JacobFV/labrat/hardware/tool-head/twin/static__syr_cable_red.stl

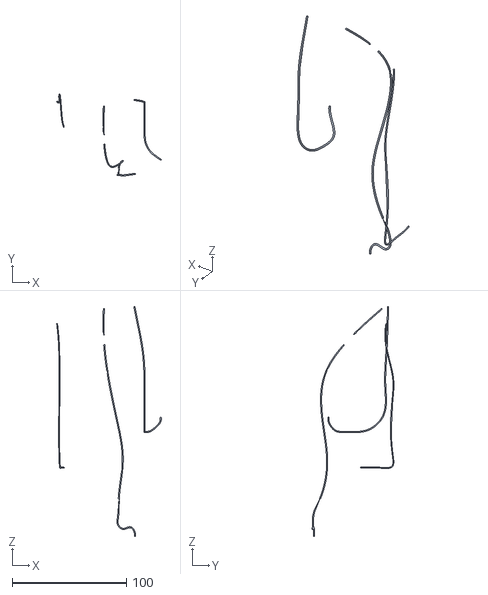
[picture p199: CAD file, 2026-10-15]
hardware/tool-head/twin/static__syr_cable_red.stl
91.9 x 71.8 x 201.7
