JacobFV/labrat/cad/syringe/step/pinion.step

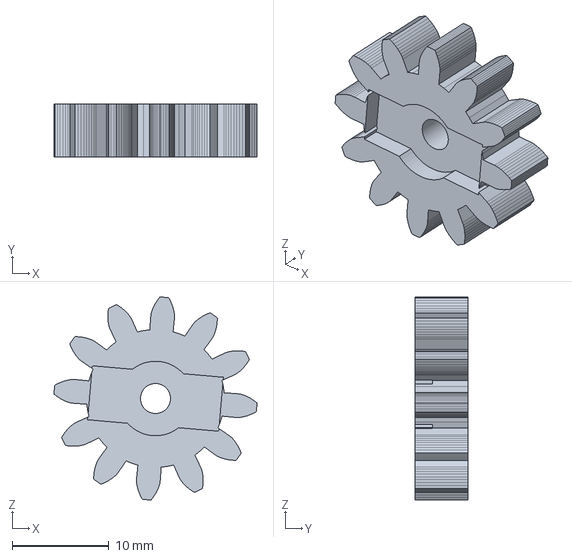
[picture p200: CAD file, 2026-10-14]
cad/syringe/step/pinion.step
21.0 x 5.50 x 21.0 mm
