JacobFV/labrat/cad/syringe/twin/static__acrylic_clear.stl

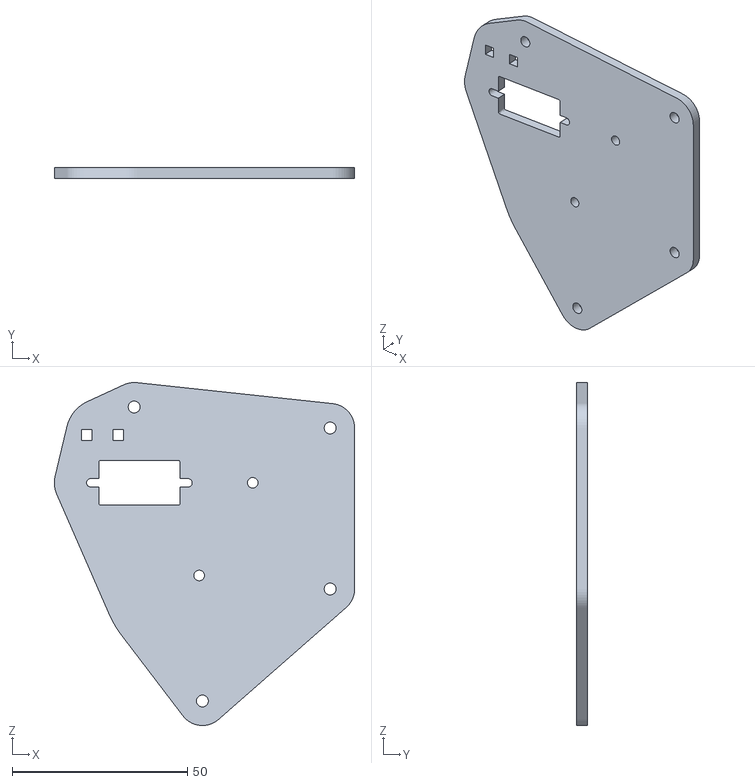
[picture p201: CAD file, 2026-10-14]
cad/syringe/twin/static__acrylic_clear.stl
85.8 x 3.00 x 98.0
