JacobFV/labrat/hardware/tool-head/twin/static__stainless_304_brushed.stl

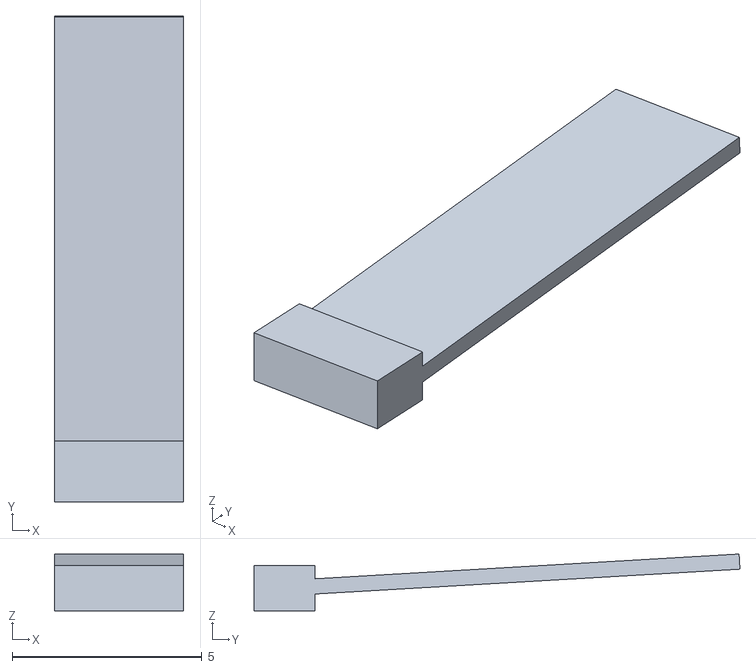
[picture p202: CAD file, 2026-10-15]
hardware/tool-head/twin/static__stainless_304_brushed.stl
3.40 x 12.8 x 1.50
