JacobFV/labrat/cad/syringe/twin/carriage__steel_hardened_ground.stl

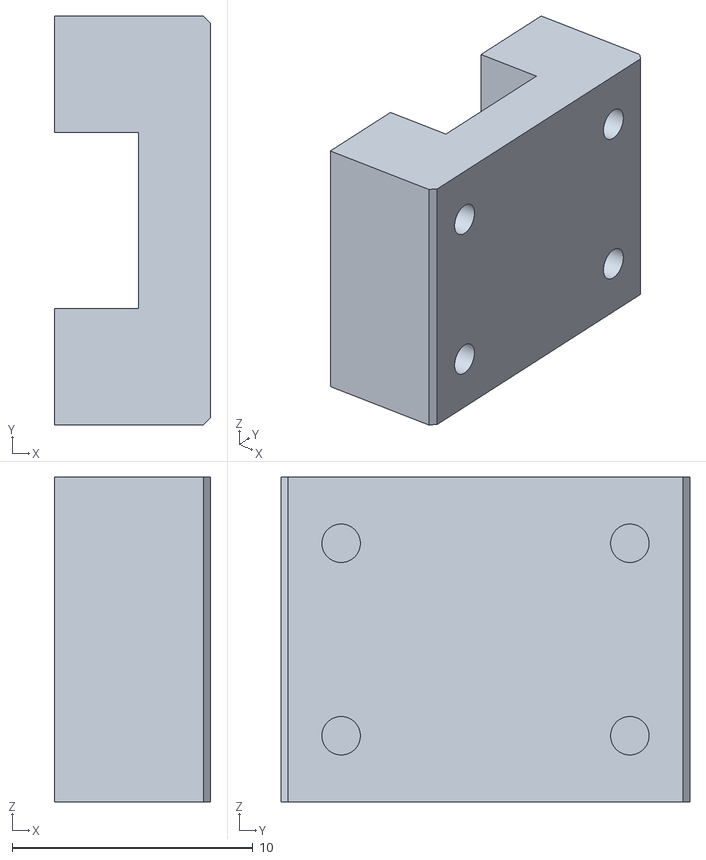
[picture p203: CAD file, 2026-10-14]
cad/syringe/twin/carriage__steel_hardened_ground.stl
6.50 x 17.0 x 13.5
