JacobFV/labrat/(list of files, cad)

Other CAD files:
hardware/print/plate_03_petg_stand_base.3mf
tappet/hardware/cad/stl/stylus_holder_L.stl
hardware/tool-head/twin/static__pilot_white.stl
hardware/tool-head/twin/static__syr_pom_white.stl
hardware/phone-stand/step/PS-100.step
hardware/tool-head/step/TM-120.step
hardware/tool-head/twin/gear_c__syr_petg_white__gear_c.stl
cad/syringe/twin/static__ic_epoxy_black.stl
tappet/hardware/cad/step/turret_R.step
hardware/tool-head/twin/carriage__syr_petg_orange__disc_cap.stl
hardware/tool-head/twin/static__petg_print__mod_microscope.stl
hardware/tool-head/step/SYR-110.step
hardware/tool-head/twin/carriage__syr_petg_orange__carriage.stl
cad/syringe/twin/gear_a__pom_black.stl
hardware/tool-head/twin/gear_a__polypropylene_white.stl
hardware/tool-head/twin/gear_b__syr_petg_white__gear_b.stl
cad/syringe/twin/carriage__polypropylene_white.stl
hardware/tool-head/twin/probe__syr_petg_orange__probe_lid.stl
cad/syringe/twin/gear_a__polypropylene_white.stl
cad/syringe/dxf/SYR-101.dxf
cad/syringe/step/SYR-100.step
cad/syringe/step/SYR-101.step
cad/syringe/step/SYR-102.step
cad/syringe/step/SYR-103.step
cad/syringe/step/SYR-104.step
cad/syringe/step/SYR-105.step
cad/syringe/step/SYR-110.step
cad/syringe/step/SYR-111.step
cad/syringe/step/SYR-112.step
cad/syringe/step/SYR-130-01p00.step
cad/syringe/step/SYR-130-04p00.step
cad/syringe/step/SYR-130-08p00.step
cad/syringe/step/SYR-130-09p00.step
cad/syringe/step/SYR-311.step
cad/syringe/step/TM-110.step
cad/syringe/step/TM-120.step
cad/syringe/step/TM-121.step
cad/syringe/stl/SYR-100.stl
cad/syringe/stl/SYR-101.stl
cad/syringe/stl/SYR-102.stl
cad/syringe/stl/SYR-103.stl
cad/syringe/stl/SYR-105.stl
cad/syringe/stl/SYR-110.stl
cad/syringe/stl/SYR-111.stl
cad/syringe/stl/SYR-112.stl
cad/syringe/stl/TM-110.stl
cad/syringe/stl/TM-120.stl
cad/syringe/stl/TM-121.stl
cad/syringe/stl/mount_body.stl
cad/syringe/stl/pinion.stl
cad/syringe/stl/rack.stl
cad/syringe/twin/carriage__silicone_rubber_red.stl
cad/syringe/twin/gear_b__syr_petg_white.stl
cad/syringe/twin/gear_c__steel_hardened_ground.stl
cad/syringe/twin/static__steel_hardened_ground.stl
cad/syringe/twin/static__syr_pom_white.stl
cad/syringe/twin/static__syr_pp_clear.stl
cad/syringe/twin/tip__syr_tip_yellow.stl
hardware/deck/stl/DECK-001.stl
hardware/phone-stand/stl/PS-100.stl
hardware/phone-stand/stl/PS-101.stl
hardware/phone-stand/stl/PS-110.stl
hardware/phone-stand/stl/PS-111.stl
hardware/phone-stand/stl/PS-120.stl
hardware/phone-stand/stl/PS-130.stl
hardware/phone-stand/stl/PS-131.stl
hardware/phone-stand/stl/PS-132.stl
hardware/phone-stand/stl/PS-133.stl
hardware/tool-head/stl/SYR-100.stl
hardware/tool-head/stl/SYR-101.stl
hardware/tool-head/stl/SYR-102.stl
hardware/tool-head/stl/SYR-103.stl
hardware/tool-head/stl/SYR-112.stl
hardware/tool-head/stl/TM-110.stl
hardware/tool-head/stl/TM-120.stl
hardware/tool-head/stl/TM-121.stl
hardware/tool-head/stl/TM-122.stl
hardware/tool-head/twin/probe__cable_pvc_black.stl
hardware/tool-head/twin/probe__stainless_304_brushed.stl
hardware/tool-head/twin/probe__syr_pcb_red.stl
hardware/tool-head/twin/static__aluminum_6063_t5_clear_anodized.stl
hardware/tool-head/twin/static__label_vinyl.stl
hardware/tool-head/twin/static__petg_print__body.stl
hardware/tool-head/twin/static__petg_print__flange_clamp.stl
hardware/tool-head/twin/static__petg_print__plate2.stl
hardware/tool-head/twin/static__polycarbonate_clear.stl
hardware/tool-head/twin/static__print_white.stl
hardware/tool-head/twin/static__syr_cable_brown.stl
hardware/tool-head/twin/tip__syr_tip_yellow.stl
tappet/hardware/cad/plates/plate5_gears_stylus.stl
tappet/hardware/cad/stl/column_head.stl
tappet/hardware/cad/stl/elbow_triangle.stl
tappet/hardware/cad/stl/forearm.stl
tappet/hardware/cad/stl/neck_tilt_bracket.stl
tappet/hardware/cad/stl/tray_shim_iphone_se.stl
tappet/hardware/cad/stl/turret_R.stl
tappet/hardware/cad/stl/yaw_gear_servo.stl
