JacobFV/labrat/cad/renders/assembly_iso.png

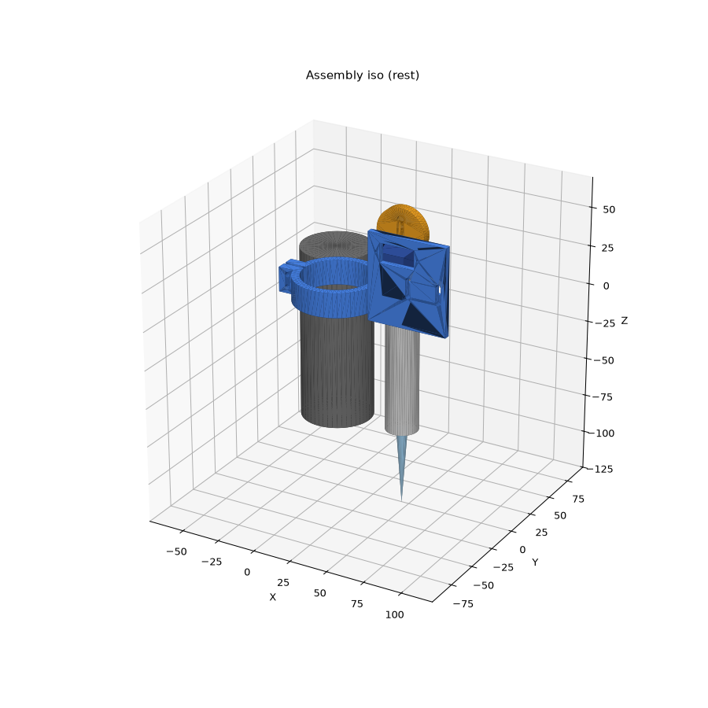
cad/renders/assembly_iso.png
