JacobFV/labrat/cad/renders/assembly_side.png

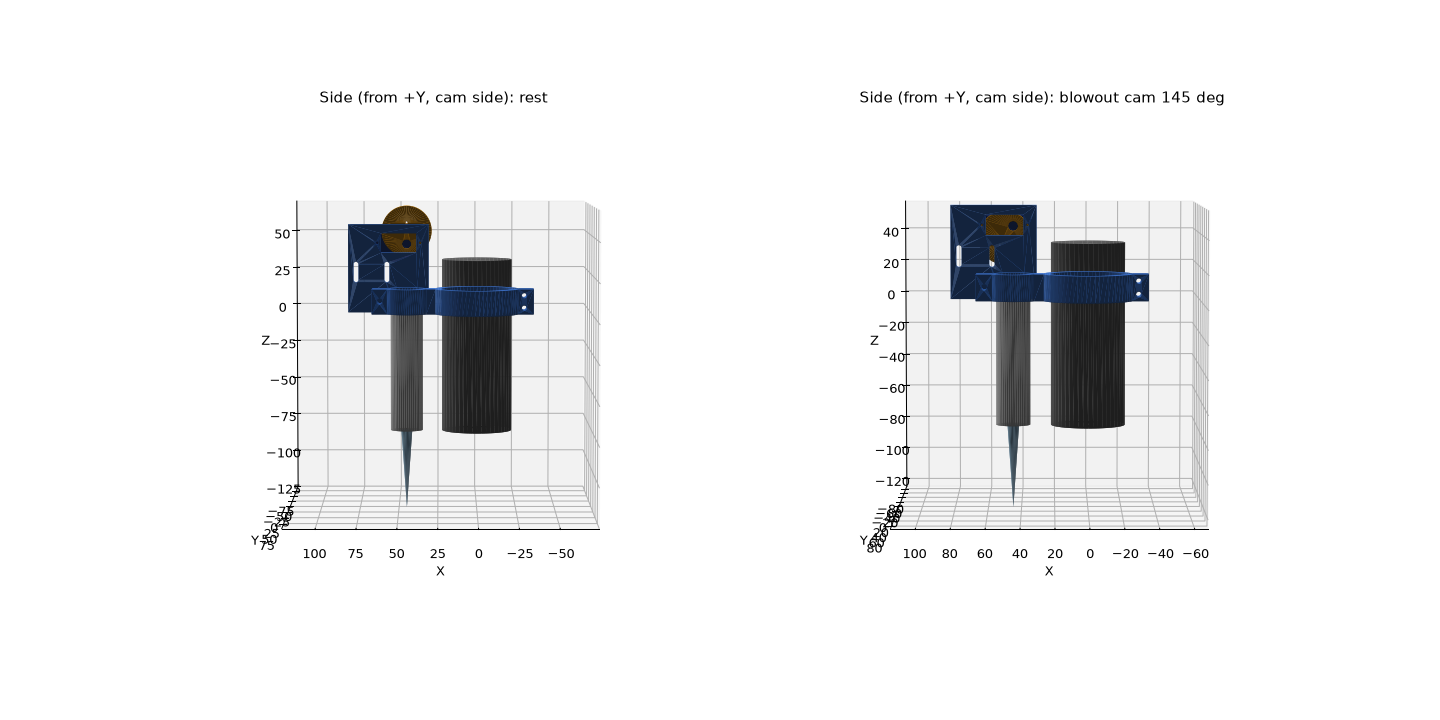
cad/renders/assembly_side.png
