JacobFV/labrat/hardware/cnc3018/renders/bench_full_assembly.png

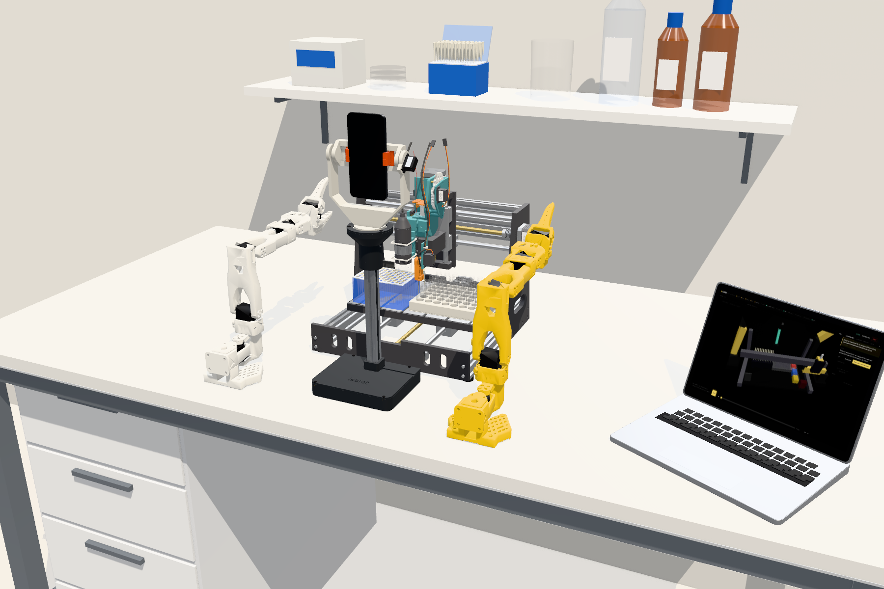
hardware/cnc3018/renders/bench_full_assembly.png
