JacobFV/labrat/hardware/cnc3018/renders/setup_front.png

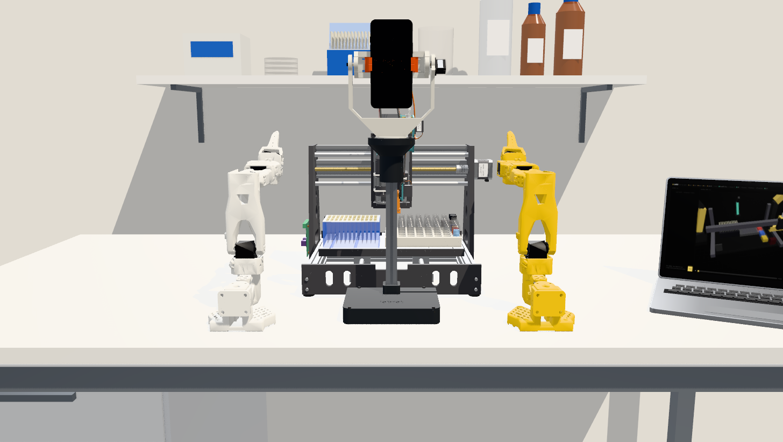
hardware/cnc3018/renders/setup_front.png
