JacobFV/labrat/hardware/cnc3018/renders/setup_iso.png

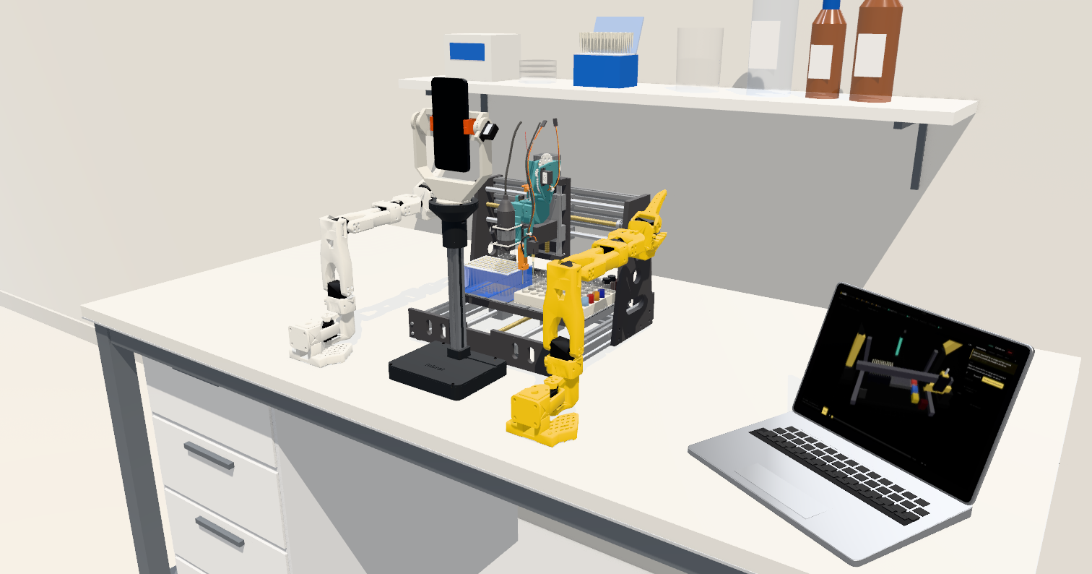
hardware/cnc3018/renders/setup_iso.png
