JacobFV/labrat/tappet/hardware/cad/renders/assembly_front.png

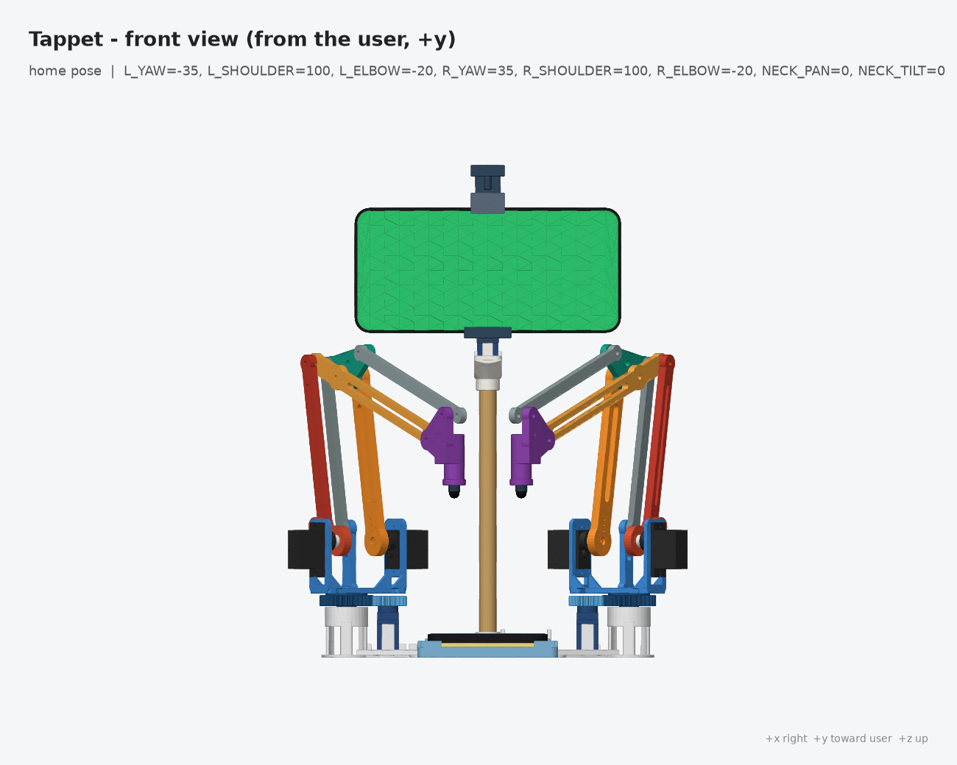
tappet/hardware/cad/renders/assembly_front.png
