JacobFV/labrat/tappet/hardware/cad/renders/assembly_iso_rear.png

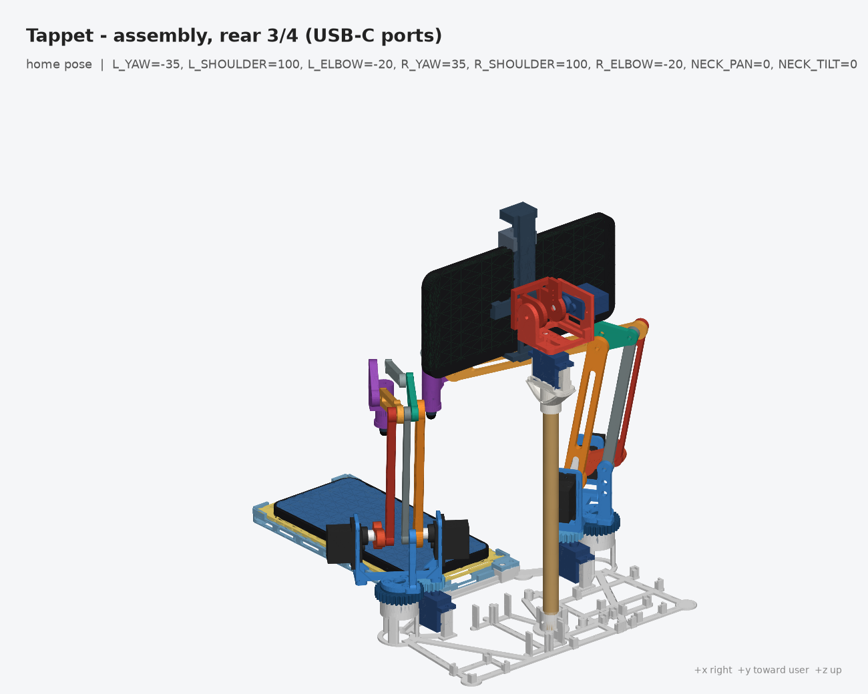
tappet/hardware/cad/renders/assembly_iso_rear.png
