JacobFV/labrat/tappet/hardware/cad/renders/assembly_top.png

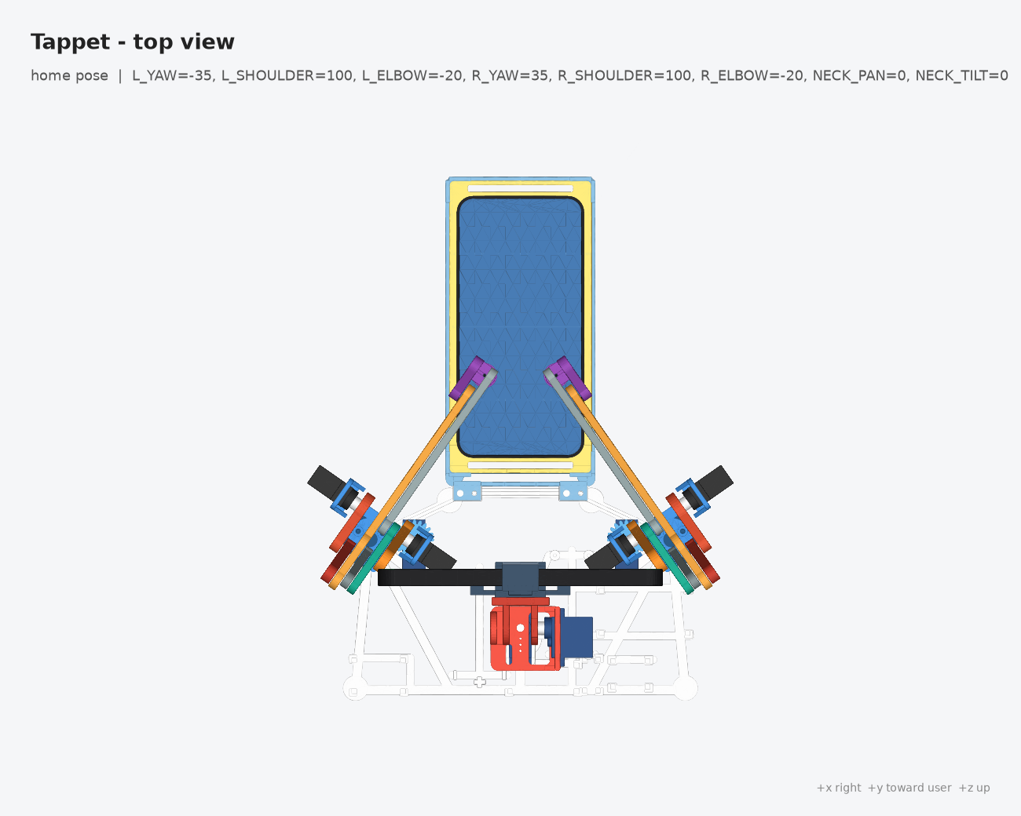
tappet/hardware/cad/renders/assembly_top.png
