JacobFV/labrat/hardware/tool-head/syrhead/spec.py

"""Design parameters for the 3018 syringe head and the layout derived from them.

Frame (the head frame): machine axes, millimetres. +X = machine +X (operator's right), +Y = machine +Y (toward the
gantry / Z plate), +Z up. Origin = syringe axis on the plane of the spindle clamp's TOP face (the body's seat ring
sits on it). The CNC moves the spindle clamp, so this frame moves with machine Z; at CNC z = 0 the clamp top is
165 mm above the bed (hardware/cnc3018/cnc3018.py: HOLDER_Y[1]).

Architecture (every part printable without supports):
    z-stack:  plug (Ø42 x 34, in the spindle clamp)  ->  rectangular mid body (syringe barrel inside)  ->  top section
    top section, an x-stack:  carriage + plunger | gear plate 1 (+ the rack's guide rib) | gears | gear plate 2 | servo
Gear axes run along +X. The carriage is an L: jaw (thumb disc) + bottom arm (through a window in gear plate 1) + rack
bar. The rack slides directly on its own back: a V-groove in the rack's back face rides a V-ridge on a rib of gear plate
1, right behind the mesh, so the gear's separating force goes straight into the guide and makes no moment.

Everything here is either a measured / catalogue value (marked) or derived. Representative purchased-part numbers are
"verify at procurement".
"""
from __future__ import annotations

import math
from dataclasses import dataclass, field


@dataclass(frozen=True)
class Spec:
    # ---------------- machine (cnc3018.py) ----------------
    clamp_bore: float = 42.0          # measured: the 3018's motor holder takes a 42.0 mm cylinder ...
    clamp_h: float = 34.0             # ... 34.0 mm high
    clamp_top_above_bed: float = 165.0
    clamp_front_y: float = -34.0      # clamp block front face
    zplate_front_y: float = 32.0      # Z plate front face (moves with the head)
    zstep_front_y: float = 26.0       # Z stepper front face (on the X carriage, above the head at z >= 68)
    zstep_bottom_z: float = 68.0
    z_travel: float = 45.0            # 3018 PRO Z travel (sim BOUNDS z -45 .. 0)
    safe_tip_h: float = 55.0          # tip end above bed at CNC z = 0 (twin SAFE_H, sim Z table): clears the beaker
    #                                   rims (51.2 mm) by 3.8 mm with a tip on; the lowest tip end is 10 mm above the bed
    # ---------------- plug + seat ----------------
    plug_od: float = 41.9             # 42.0 holder bore - 0.1 (slide fit, the holder clamps it)
    seat_od: float = 41.9             # the plug flares out at 45 deg from its own OD: a conical seat on the holder's
    #                                   bore edge (self-centring, and no flat ledge that would need support)
    # ---------------- syringe: 12 mL luer-slip, PP barrel, rubber stopper (representative) ----------------
    barrel_od: float = 20.2           # measured
    barrel_len: float = 80.0          # measured: flange underside -> barrel bottom face
    barrel_id: float = 17.8           # estimate (1.2 mm wall) -> 249 uL/mm
    flange_l: float = 34.0            # finger flange, long axis (along Y when installed)
    flange_w: float = 24.0            # flats
    flange_t: float = 2.2
    hub_d: float = 7.0                # nozzle hub
    hub_l: float = 2.5
    luer_l: float = 7.5               # ISO 80369-7 male slip: 6 % taper, 3.925 at the tip
    luer_tip_d: float = 3.925
    luer_taper: float = 0.06
    disc_d: float = 20.0              # plunger thumb disc
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
