JacobFV/labrat/(commit log)

2026-10-11 Tappet v0.1: complete design package
    Desktop robot with an Android-phone head on a 2-axis neck and two 3-DOF
    stylus arms that operate an iPhone in a tray. Includes system spec and
    shared config, ESP32-S3 firmware (PCA9685, IK, motion queue, AOA USB host),
    Android head app (face, voice, camera, Claude agent, web server), web
    remote + touchpad calibration page, Python simulator/bridge/tools, build123d
    CAD with kinematic and interference checks, schematics and wiring drawings,
    and product/engineering docs.
2026-10-11 Add 6 ready-to-slice print plates for 220x220 beds (Ender 3 V3 SE)
2026-10-11 Skeleton chassis: replace base/lid/column/tray plates with 2 light plates (~5 h, ~90 g)
    Open truss chassis with open-mounted electronics, open tray frame, lightened
    turrets/neck/clamp, 10 mm dowel column. Arm links, gears, stylus parts and
    cable clips (plates 4-6) are byte-identical. All kinematic, joint,
    printability and interference checks pass.
2026-10-11 LabRat: simulation-first desk-lab agent with self-improving memory
    Server (FastAPI agent, digital twin, learning loop, Atlas/Voyage/Raindrop/
    ElevenLabs/Modelence integrations), laptop console + iPhone head SPA, USB
    bridge (SO-101, Tappet ESP32, GRBL CNC, servo pipette), pipette mount CAD,
    AWS EC2 deploy.
2026-10-11 Add terminal CLI, deck calibration (pipette offset, teach/jog), auto vision observation feeding the RSI loop, demo + submission docs
2026-10-11 Fix console vs real server: live ws status line, honest per-service status (services{} in /api/state), variants embedded + frames re-simulated on demand, no-cache static files
2026-10-11 Realistic 3018 PRO CNC (build123d GLB) + official SO-101 URDF arms in the twin; static iPhone stand and side laptop; photo step no longer moves an arm (fresh-frame wait); docs match real bench layout
2026-10-11 Twin matches the real bench (arms at CNC front corners facing back, phone front-centre, CNC mirrored); bridge: non-interactive calibrate --step; SO-101 calib so_a=left so_b=right
2026-10-11 Phone: audible replies on iOS (pre-unlocked <audio> element, audioSession=playback, mic released per utterance, mouth driven by real playback, errors reported); bridge: tick wrap in SO-101 angle conv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
2026-10-11 Teleop: right SO-101 (leader, hand-moved) drives left SO-101 (follower) at 30 Hz with trajectory recording; bridge 'teleop' CLI; POST /api/device for any bridge action
2026-10-14 Replace the cam servo pipette with a rack-and-pinion syringe head in the 3018 spindle clamp
    CAD
    - cad/syringe: parametric CadQuery head (v0.2 of the syringe_3018_rack design): 50.2 mm plug body
    with syringe collar, rack guide and SG90 plate; rack with plunger fork; m1.5 12T pinion on a trimmed
    horn. STEP/STL/3MF plate, shaded preview, report.json with fit, insertion, plunger and kinematic
    sweep checks that fail the build. Fixes found by the checks: flange vs guide wall, fork slot vs
    plunger rod, pinion vs servo gearbox, horn pocket vs tooth roots; plug_len puts the tip at SAFE_H.
    - cnc3018.py: spindle motor/sleeve/bit and the old pipette replaced by the syringe head (coaxial with
    t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
2026-10-14 Syringe head v1.0: 12:1 geared drive, MGN7 guide, full make/buy model, microfab checks + Cycles renders
    Redesign of cad/syringe as a parametric build123d package (syrhead/), replacing the v0.2 CadQuery script.
    Design
    - Drive: FS90R continuous servo -> 17T:50T (m0.8) -> 12T:49T (m1.0) -> 12T pinion -> rack = 12.01:1,
    0.50 mm plunger per servo radian (~2.2 uL/deg, 18x finer than v0.2). PA 25, contact ratios 1.36-1.42.
    - Precision: rack/plunger carriage on a HIWIN MGN7 rail; gears on MR63ZZ bearings on 3m6 dowels supported
    at both ends (printed back plate + laser-cut acrylic cover); brass tube spacers on the inner rings.
    - Syringe: plug fills the full 26 mm clamp (tip end 60 mm above the b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
2026-10-14 Head v2: support-free x-stack head, 42 mm holder, square-bar guide, tool rail (USB microscope, capacitive probe), beaker-matrix deck
    - syringe head redesigned as plug / mid body / x-stack (guide bar | carriage | gear plate | gears | gear plate | servo);
    gear axes along X, carriage is one ring through a window in gear plate 1, rack integral and printed standing up
    - every printed part prints without supports (new print check in syrhead.build); 2.5D compound gears with no neck
    - MGN7 rail replaced by a plain 14 mm square bar (diamond-wise) on the body; the carriage is a sleeve on it
    - plug 41.9 x 34 for the 42 mm holder, 45 deg self-centring seat; tip 55 mm above the bed at z = 0
    - tool rail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
2026-10-14 Head v2: rack slides on its own back (V-groove on a rib behind the mesh); trapezoid tool rail (V seat); microfab clean
    - the carriage is an L (jaw, arm, rack); the guide bar / sleeve / top bridge are gone. The rack's back V-groove rides a
    V-ridge on a rib of gear plate 1 directly behind the mesh, so the separating force goes straight into the guide
    - tool rail is a plain trapezoid; a module's single M3 index screw pulls its groove onto the two 45 deg flanks
    - probe module: TTP223 pocket in the module's top face, one 3-core cable; microscope tie tunnels, edge breaks
    - microfab: 0 errors (static + 401-pose motion); syrhead.build: 28/28 incl. the support-free print check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
2026-10-14 Head v2 renders (Cycles, microfab pipeline): studio + bench, incl. tool rail and the beaker deck
2026-10-15 Repo v2: one Cloudflare Durable Object + D1, servo hub, phone stand, retracting probe
    Layout: cloud/ (Worker + Lab DO + D1), apps/{console,phone,cli}, bridge/, firmware/servo-hub/,
    hardware/{tool-head,deck,cnc3018,phone-stand,so101,electronics}, docs/. Contracts in docs/protocol.md.
    - Sponsor services removed (Mongo, Modelence, ElevenLabs, Voyage, Raindrop, Fireworks, AWS); the old Python
    server, Docker/deploy, video and Tappet are gone. Anthropic is the only external API; voice is on-device.
    - cloud: one Durable Object coordinates providers (bridge over USB, phone over Web Bluetooth), the agent,
    sim/learn and the logical devices pipette / probe / stand on top of the servo hub; D1 for e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
2026-10-15 Experiments for scientists: an experiment is one plate
    Samples (µL of each stock per beaker) -> dry run on the twin (draft/ready) -> run with
    approval -> photo -> per-beaker results (measured vs predicted) -> CSV. Repeat makes a copy.
    Cut: variants, runs, simulate-N, scores, typed memory, taxonomy seed, procedural promotion,
    LLM variant design (the agent writes samples directly). Notebook = notes with FTS; the colour
    model refits from the newest reading per beaker and only re-predicts experiments not yet run.
    Console rebuilt around a plate map + sample/results table; Python client (labrat_cli.Lab),
    experiments/ scripts, docs/experiments.md. D1 schema rewritten (reset local state).
    Co-Aut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
2026-10-15 Straighten out the repo: one print home, no dead files, no history in names
    - hardware/print: the single plate builder (pack_plates.py, slice_plates.py, six
    Ender-3 V3 SE plates); per-component plate_*.3mf and their exporters removed
    - Delete unreferenced renders, docs images, cnc3018 matplotlib renders and
    render_bench.py, SO-101 leader/assembly/Seeed files, check report JSONs
    (now written to each component's untracked build/)
    - Remove shims: so101 POSE_ALIASES, the twin's tip {visible} proxy, unused
    imports/exports in cloud and console; drop v2 / rev A-B / formerly wording
    - Docs: root README repo map; component READMEs describe only themselves;
    routes, D1 and device rules live o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
2026-10-15 Drop the SO-101 print files, lower the beaker matrix, thin the stand base infill
    - SO-101: the arms are already built. Remove plate 06 and the vendored
    upstream stl/, step/, LICENSE and NOTICE (nothing read them; the twin uses
    apps/console/models/so101/). hardware/so101/README.md keeps only placement,
    IDs, poses, wiring/power, calibration and safety for the arms we own.
    - DECK-001: pockets 20 -> 10 mm deep on the same 1.2 mm floor, so the holder
    top is 11.2 (was 21.2) and the rims stay at 51.2. 121 -> 72 cm3. deck.json
    holder_top_h and the twin's matrix top follow. The probe floor stays 23.8:
    the deployed arm over the rims is the limit, not the holder.
    - Phone stand: no lightenin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
